DevonHope/FOSS-Health-Alarm/hardware/strap/wakeband-strap-pattern-rev-a.pdf

### WakeBand strap pattern, rev A (print at 100% / Actual size, no scaling)

Check: this box is 50 x 20 mm

2 inches

A BACKING (soft fabric) cut 1 grain along length

fold lines: wrap 4 mm over tape edges turn under 10 mm (anchor end)

FOLD around loop bar A here; box-X stitch below

cut S

S: hook tab C top

cut M

M: hook tab C top

cut L

L: hook tab C top

TIP END: cut at your size, turn under 10 mm (dashed line). Dotted box = hook tab C, sewn on this backing side, 3 mm from tip.

B LOOP TAPE 16 mm (5/8 in), soft side out cut 1

cut S

cut M

cut L

C HOOK TAPE 16 x 35 mm

cut 1, round all corners (r 4 mm)

D TIP TEMPLATE (r 8 mm)

optional: round the tip of A and B together

Sizes (finished strap length):

S: 180 mm wrist 135-160 mm

M: 195 mm wrist 150-175 mm

L: 210 mm wrist 165-190 mm

Measure your wrist snugly where you'll wear it. Between sizes: pick the larger one.

## WakeBand strap: materials and steps

Materials

- 16 mm (5/8 in) sew-on hook-and-loop tape: loop (soft) side about 25 cm, hook side 4 cm. Pick the thin, soft 'sew-on' kind, not adhesive.
- Soft, thin, breathable fabric for the backing (cotton or bamboo jersey, or thin brushed nylon), about 26 x 4 cm.
- Polyester thread, a fabric marker, sharp scissors, a lighter for synthetic edges.

Why this shape

- The strap attaches only at the case's two end loops and never runs under the case, so the charging contacts stay

clear and the motor sits directly on your skin. The finished strap must stay 16 mm wide and under 2 mm thick to

fit the 16.6 x 2.2 mm slots. Aim for 1 mm or less: two layers pass a slot at the bar folds. Test a scrap

through a printed loop before you sew the whole strap.

Steps

1. Print page 1 at 100% (Actual size). Check the 50 x 20 mm box with a ruler.
2. Cut piece A from fabric, piece B from loop tape, piece C from hook tape, at your size's cut lines.
3. Seal cut ends of the synthetic tapes with a quick pass of a lighter flame (don't melt the soft face).
4. Lay B on A, soft side up, centred between A's fold lines, its anchor end on A's 'turn under' line.
5. Fold A's 4 mm edges over B's edges, pin or clip, and topstitch each side about 1.5 mm from the edge.

Use a long stitch (3 mm) and a walking foot or tissue paper if the tape drags.

6. Turn both ends of A under 10 mm (over B's ends) and stitch across.
7. Sew C (hook) onto the BACKING side at the tip, 3 mm from the end, inside the dotted box. Stitch all the way round.
8. Anchor end: thread it through case loop A (either end of the case), fold it back onto the soft side at the 'fold' line,

and sew a box with an X through both layers (about 14 x 14 mm). Do this before you seal the case if the

bar is hard to reach, or sew it with the case already assembled; the slot is open.

9. To wear: wrap around your wrist, pass the tip through the other loop, fold it back and press the hook onto the soft side.

Fit

- Snug, so the case back touches your wrist, but loose enough to slide one finger under the strap.
- The hook tab only touches the soft side when folded back, so it never scratches you.
- Hand wash the strap; remove it from the band first.

Variations

- Stretchier: use 16 mm soft elastic for B and a short sewn-on loop patch where the hook lands.
- Quick, no-sew: 5/8 in VELCRO ONE-WRAP strap cut to length, ends sealed, looped the same way.
