DevonHope/FOSS-Health-Alarm/hardware/strap/wakeband-strap-pattern-rev-b-elastic-buckle.pdf

### WakeBand strap pattern, rev B: elastic edges + buckle (print at 100% / Actual size)

Check: this box is 50 x 20 mm

2 inches

A SHORT STRAP cut 1 (knit)

cut S

S: elastic zone ends

cut M

M: elastic zone ends

cut L

L: elastic zone ends

fold round case bar;
elastic zone starts

turn under 8 mm

B LONG STRAP cut 1 (knit)

cut S

S: elastic zone ends

cut M

M: elastic zone ends

cut L

L: elastic zone ends

fold round case bar;
elastic zone starts

turn under 8 mm

A: male buckle end at top. B: buckle slider end at top. Long dash-dot = fold line (fold lengthwise, right sides in). Short dashes 4 mm in = seam line.

Cut lengths (mm)

size A B elastic A elastic B

S | 66 121 2 x 16 2 x 24
M | 72 129 2 x 21 2 x 30
L | 77 138 2 x 25 2 x 38

Elastic: 1/8 in (3 mm) flat elastic,
two pieces per strap, one per edge.

Keeper: 1/4 in elastic, 45 mm, 1 piece.

## WakeBand strap rev B: elastic edges and a buckle

Materials

- Soft, thin knit (cotton or bamboo jersey, or nylon-spandex), about 30 x 5 cm.
- 1/8 in (3 mm) flat braided elastic, about 30 cm. 1/4 in elastic, 5 cm, for the keeper.
- One 5/8 in (16 mm) plastic side-release buckle with an adjuster bar (the low-profile 'contoured' kind is kinder at night).

Alternative: a 16 mm magnetic snap clasp; then make B the same length as A plus 10 mm and skip the tail and keeper.

- Polyester thread, a bodkin or small safety pin for threading elastic.

How it goes together

- A runs from one case loop to the buckle's male half. B runs from the other case loop, through the buckle's

female half and its adjuster, and ends in a tail held by the keeper. The buckle sits under your wrist.

- Each strap is a 16 mm tube with a 3 mm elastic channel along both edges, so the edges gather and stretch

slightly. The ends that wrap the case bars and buckle bars have no elastic, so they stay thin enough for the

16.6 x 2.2 mm slots.

Steps (same for A and B)

1. Print page 1 at 100%, check the 50 x 20 mm box, cut A and B at your size. Cut elastic from the table.
2. Fold lengthwise right sides together and sew the long edge 4 mm in (stretch or narrow zigzag stitch). Trim to 2 mm.
3. Turn right side out with a bodkin and press so the seam sits on one edge; the tube is now 16 mm wide.
4. Mark the elastic zone from page 1 (from the fold line by the case end to your size's 'elastic zone ends' mark).
5. Sew a line along the full length 3.5 mm in from each edge. This makes two 3 mm channels.
6. Thread one elastic piece into each channel. Pin its ends at the start and end of the elastic zone, so the fabric

gathers evenly. Bar-tack across the channel at both ends of the zone (several back-and-forth stitches).

7. Turn both raw ends in 8 mm and stitch across.
8. A: wrap one end round a case loop bar at the fold mark and box-X stitch. Wrap the other end round the

buckle's male bar the same way.

9. B: wrap one end round the other case loop bar and box-X stitch. Thread the other end up through the

female half's adjuster, back down, and through the keeper.

10. Keeper: overlap the 1/4 in elastic ends by 5 mm round two layers of strap and stitch; slide it onto B.

Fit and care

- Adjust so the case back sits flat on your wrist and you can slide one finger under the strap; the elastic edges

take up movement during sleep. Unclip the buckle to lay the band on the dock.

- Test a scrap of the finished tube end through a printed loop before sewing the bar folds.
- Hand wash with the strap removed from the band.
