DevonHope/FOSS-Health-Alarm/hardware/flex-rev-a/bom.csv

Comment | Designator | Footprint | LCSC | MPN | Qty | DNP
1uF 50V X5R | C201,C206 | Capacitor_SMD:C_0603_1608Metric | C15849 |  | 2
2.2uF 16V X5R | C202 | Capacitor_SMD:C_0603_1608Metric | C23630 |  | 1
100nF | C203,C401,C402 | Capacitor_SMD:C_0402_1005Metric | C1525 |  | 3
10uF 25V X5R | C204,C205,C207,C403 | Capacitor_SMD:C_0603_1608Metric | C96446 |  | 4
1uF 25V X5R | C501,C502 | Capacitor_SMD:C_0402_1005Metric | C52923 |  | 2
SMF18A (TVS) | D601 | Diode_SMD:D_SOD-123F | C409420 | Littelfuse SMF18A | 1
TPD1E10B06 (check) | D602,D603,D604,D605 | Diode_SMD:D_0402_1005Metric | C48260 | TI TPD1E10B06DPYR | 4
red DNP | D701 | LED_SMD:LED_0402_1005Metric | C25503345 | XINGLIGHT XL-1005SURC | 1 | DNP
2.2uH (check) | L201 | Inductor_SMD:L_Murata_DFE201610P | C337891 | Murata DFE201610E-2R2M | 1
100k DNP | R201 | Resistor_SMD:R_0402_1005Metric | C25741 |  | 1 | DNP
68k 1% | R202 | Resistor_SMD:R_0402_1005Metric | C36871 |  | 1
4.7k | R203,R204 | Resistor_SMD:R_0402_1005Metric | C25900 |  | 2
100 | R601,R602,R603,R604 | Resistor_SMD:R_0402_1005Metric | C25076 |  | 4
100k | R605 | Resistor_SMD:R_0402_1005Metric | C25741 |  | 1
1k DNP | R701 | Resistor_SMD:R_0402_1005Metric | C11702 |  | 1 | DNP
button DNP | SW201 | Button_Switch_SMD:SW_SPST_B3U-1000P | C231329 | Omron B3U-1000P | 1 | DNP
10k B3380 | TH201 | Resistor_SMD:R_0402_1005Metric | C77131 | Murata NCP15XH103F03RC | 1
ISP2454-LX | U1 | wakeband:InsightSiP_ISP2454_LGA-62_8x8mm |  |  | 1
nPM1304-QEAA | U201 | Package_DFN_QFN:QFN-32-1EP_5x5mm_P0.5mm_EP3.45x3.45mm |  |  | 1
LIS2DW12TR | U401 | Package_LGA:LGA-12_2x2mm_P0.5mm | C189624 |  | 1
DRV2605LDGSR | U501 | Package_SO:TSSOP-10_3x3mm_P0.5mm | C527464 |  | 1
