DevonHope/FOSS-Health-Alarm/hardware/dock/rev-c/pcb/fab/bom_jlcpcb.csv

Comment | Designator | Footprint | LCSC | MPN | Qty
RP2040 | U1 | QFN-56-1EP_7x7mm_P0.4mm_EP3.2x3.2mm | C2040 | Raspberry Pi RP2040 | 1
W25Q16JVSNIQ | U2 | SOIC-8_3.9x4.9mm_P1.27mm | C2456211 | Winbond W25Q16JVSNIQ | 1
12MHz 12pF | Y1 | Crystal_SMD_3225-4Pin_3.2x2.5mm | C2981639 | 3225-12-12-10-10/A | 1
15pF | C1,C2 | C_0402_1005Metric | C1548 |  | 2
1k | R1,R9,R13,R14 | R_0402_1005Metric | C11702 |  | 4
USB-C | J1 | USB_C_Receptacle_HRO_TYPE-C-31-M-12 | C165948 | HRO TYPE-C-31-M-12 | 1
5.1k | R2,R3 | R_0402_1005Metric | C25905 |  | 2
USBLC6-2SC6 | U3,U9 | SOT-23-6 | C7519 | ST USBLC6-2SC6 | 2
27 | R4,R5 | R_0402_1005Metric | C25100 |  | 2
500mA | F1 | Fuse_0805_2012Metric | C181350 | FSMD050-0805-R | 1
10uF | C3 | C_0603_1608Metric | C19702 |  | 1
XC6206P332MR | U4 | SOT-23-3 | C2897477 | Torex XC6206P332MR | 1
1uF | C4,C5,C6,C7,C14,C15 | C_0402_1005Metric | C52923 |  | 6
XC6206P182MR | U5 | SOT-23-3 | C21659 | Torex XC6206P182MR | 1
SY6280AAC | U6 | SOT-23-5 | C55136 | Silergy SY6280AAC | 1
33k | R6 | R_0402_1005Metric | C25779 |  | 1
100nF | C8,C9,C10,C11,C12,C13,C16,C17,C22,C18,C19,C20,C21 | C_0402_1005Metric | C1525 |  | 13
100nF | C23,C24 | C_0201_0603Metric | C160831 |  | 2
10k | R7,R8 | R_0402_1005Metric | C25744 |  | 2
BOOTSEL | SW1 | SW_SPST_TS-1088-xR020 | C720477 | XKB TS-1088-AR02016 | 1
74LVC1T45 | U7 | SOT-23-6 | C168856 | Diodes 74LVC1T45W6-7 | 1
TXS0101 | U8 | SOT-23-6 | C132604 | TI TXS0101DBVR | 1
22 | R10 | R_0402_1005Metric | C25092 |  | 1
100 | R11,R12 | R_0402_1005Metric | C25076 |  | 2
100k | R15 | R_0201_0603Metric | C106224 | Yageo RC0201FR-07100KL | 1
SMF6.0A | D3 | D_SOD-123F | C123790 | SMF6.0A | 1
red LED | D1,D2 | LED_0603_1608Metric | C2286 | KENTO KT-0603R | 2
