DevonHope/FOSS-Health-Alarm/hardware/band/rev-c/pcb/fab/jlcpcb/bom.csv

Comment | Designator | Footprint | LCSC
2450AT18A0100001E | AE1_0,AE1_1,AE1_2,AE1_3 | Johanson_2450AT18x100 | C17430588
2.2uF | C1_0,C1_1,C1_2,C1_3,C2_0,C2_1,C2_2,C2_3 | Nordic_CAPC0603X03L_C | C335106
10uF | C3_0,C3_1,C3_2,C3_3 | Nordic_CAPC1005X04L | C15525
100nF | C4_0,C4_1,C4_2,C4_3,C7_0,C7_1,C7_2,C7_3,C8_0,C8_1,C8_2,C8_3,C10_0,C10_1,C10_2,C10_3 | Nordic_CAPC0603X03L_C | C307380
2.2nF | C5_0,C5_1,C5_2,C5_3 | Nordic_CAPC0603X03L_C | C161479
1.5pF | C6_0,C6_1,C6_2,C6_3 | Nordic_CAPC0603X03L_C | C435397
2.0pF | C9_0,C9_1,C9_2,C9_3 | Nordic_CAPC0603X03L_C | C668326
0.3pF | C11_0,C11_1,C11_2,C11_3 | Nordic_CAPC0603X03L_C | C76927
10nF | C12_0,C12_1,C12_2,C12_3 | Nordic_CAPC0603X03L_C | C76941
3.9pF | C13_0,C13_1,C13_2,C13_3 | Nordic_CAPC0603X03L_C | C76926
1uF | C201_0,C201_1,C201_2,C201_3,C208_0,C208_1,C208_2,C208_3,C501_0,C501_1,C501_2,C501_3,C502_0,C502_1,C502_2,C502_3 | C_0402_1005Metric | C52923
2.2uF | C202_0,C202_1,C202_2,C202_3 | C_0603_1608Metric | C23630
10uF | C205_0,C205_1,C205_2,C205_3,C206_0,C206_1,C206_2,C206_3 | C_0603_1608Metric | C96446
100nF | C209_0,C209_1,C209_2,C209_3,C401_0,C401_1,C401_2,C401_3,C402_0,C402_1,C402_2,C402_3 | C_0402_1005Metric | C1525
1uF | C210_0,C210_1,C210_2,C210_3,C211_0,C211_1,C211_2,C211_3 | Nordic_CAPC0603X03L_C | C307385
ESD5681N07 | D601_0,D601_1,D601_2,D601_3 | D_SOD-882 | C240204
TPD1E10B06 | D602_0,D602_1,D602_2,D602_3,D603_0,D603_1,D603_2,D603_3 | Texas_DPY0002A_0.6x1mm_P0.65mm | C48260
TJ-S1615SW6TGLCCYRGB-A5 | D702_0,D702_1,D702_2,D702_3 | LED_TOGIALED_1615_RGB_CommonAnode | C273610
120R@100MHz | FB1_0,FB1_1,FB1_2,FB1_3 | Nordic_INDC0603X03L_C | C97850
4.7uH | L1_0,L1_1,L1_2,L1_3 | Nordic_INDC1608X06L | C76799
2.7nH | L2_0,L2_1,L2_2,L2_3 | Nordic_INDC0603X03L_C | C7216765
3.5nH | L3_0,L3_1,L3_2,L3_3,L4_0,L4_1,L4_2,L4_3 | Nordic_INDC0603X03L_C | C3911055
2.2uH | L201_0,L201_1,L201_2,L201_3 | L_Murata_DFE201610P | C337891
1k | R1_0,R1_1,R1_2,R1_3 | Nordic_RESC0603X03L_C | C270365
0R | R2_0,R2_1,R2_2,R2_3 | R_0402_1005Metric | C17168
6.65k | R202_0,R202_1,R202_2,R202_3 | R_0402_1005Metric | C45194
4.7k | R203_0,R203_1,R203_2,R203_3,R204_0,R204_1,R204_2,R204_3 | R_0402_1005Metric | C25900
14k | R207_0,R207_1,R207_2,R207_3 | R_0402_1005Metric | C54831
14.3k | R208_0,R208_1,R208_2,R208_3 | R_0402_1005Metric | C25855
100k | R211_0,R211_1,R211_2,R211_3 | R_0402_1005Metric | C25741
100 | R601_0,R601_1,R601_2,R601_3,R602_0,R602_1,R602_2,R602_3 | R_0402_1005Metric | C25076
10k B3380 | TH201_0,TH201_1,TH201_2,TH201_3 | R_0402_1005Metric | C77131
nRF54L10-QFAA | U1_0,U1_1,U1_2,U1_3 | Nordic_QFN40P600X600X90-48N | C44800139
BQ25125 | U201_0,U201_1,U201_2,U201_3 | TI_DSBGA-25_2.5x2.5mm_Layout5x5_P0.4mm | C2871567
IS31FL3193 | U202_0,U202_1,U202_2,U202_3 | DFN-10-1EP_3x3mm_P0.5mm_EP1.65x2.38mm | C2653363
TPS7A0220 | U203_0,U203_1,U203_2,U203_3 | Texas_X2SON-4_1x1mm_P0.65mm_SilkTrim | C2860934
LIS2DW12TR | U401_0,U401_1,U401_2,U401_3 | LGA-12_2x2mm_P0.5mm | C189624
DRV2605LDGSR | U501_0,U501_1,U501_2,U501_3 | TSSOP-10_3x3mm_P0.5mm | C527464
32.768kHz 9pF | X1_0,X1_1,X1_2,X1_3 | Nordic_XTAL_2012 | C96341
32MHz 8pF | X2_0,X2_1,X2_2,X2_3 | Nordic_BT-XTAL_2016 | C2965582
