DevonHope/FOSS-Health-Alarm/hardware/band/rev-c/case/wakeband-case-rev-c-cover.step

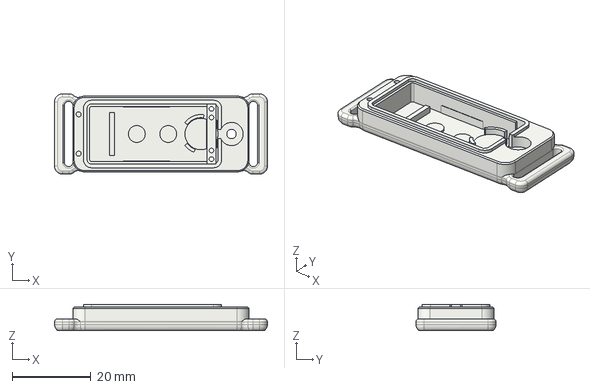
[picture p19: CAD file, 2026-11-10]
hardware/band/rev-c/case/wakeband-case-rev-c-cover.step
54.2 x 20.4 x 6.70 mm
