DevonHope/FOSS-Health-Alarm/hardware/dock/rev-c/case/wakeband-dock-rev-c-tray.step

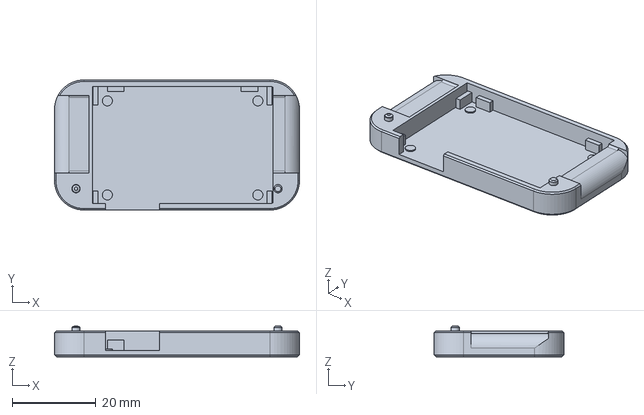
[picture p20: CAD file, 2026-11-10]
hardware/dock/rev-c/case/wakeband-dock-rev-c-tray.step
58.6 x 31.1 x 7.39 mm
