DevonHope/FOSS-Health-Alarm/hardware/band/rev-c/case/wakeband-case-rev-c-shell.step

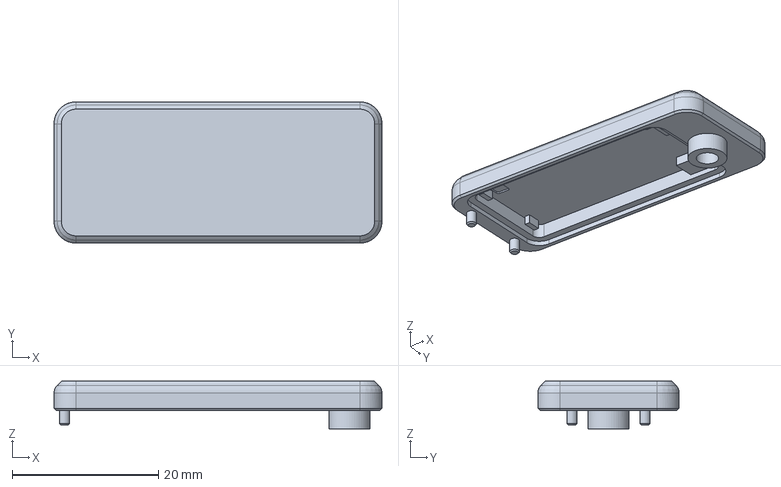
[picture p21: CAD file, 2026-11-10]
hardware/band/rev-c/case/wakeband-case-rev-c-shell.step
44.8 x 19.3 x 6.50 mm
