DevonHope/FOSS-Health-Alarm/hardware/dock/rev-c/case/wakeband-dock-rev-c-spring-pins.step

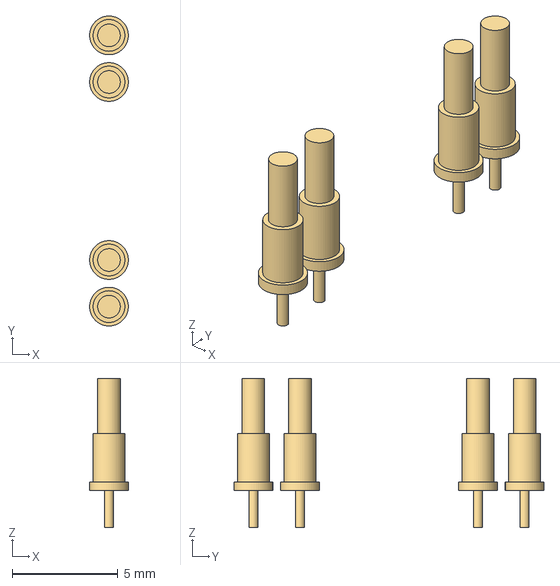
[picture p22: CAD file, 2026-11-10]
hardware/dock/rev-c/case/wakeband-dock-rev-c-spring-pins.step
1.83 x 14.6 x 7.04 mm
