DevonHope/FOSS-Health-Alarm/hardware/dock/rev-c/case/wakeband-dock-rev-c-strap-standin.step

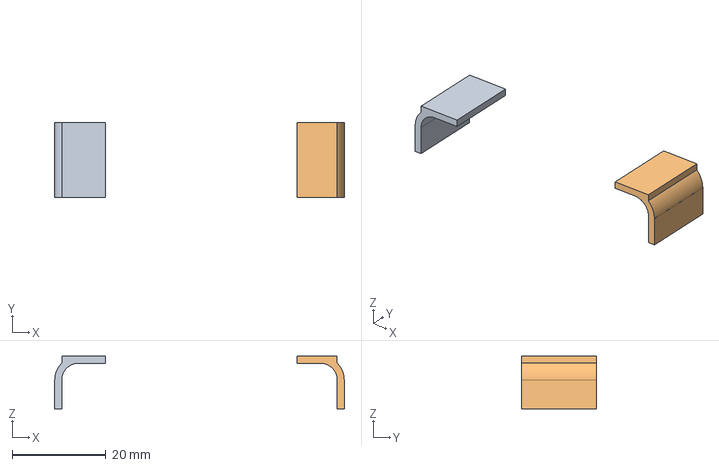
[picture p23: CAD file, 2026-11-10]
hardware/dock/rev-c/case/wakeband-dock-rev-c-strap-standin.step
61.8 x 16.0 x 11.2 mm
