DevonHope/FOSS-Health-Alarm/hardware/dock/rev-c/case/wakeband-dock-rev-c-magnets.step

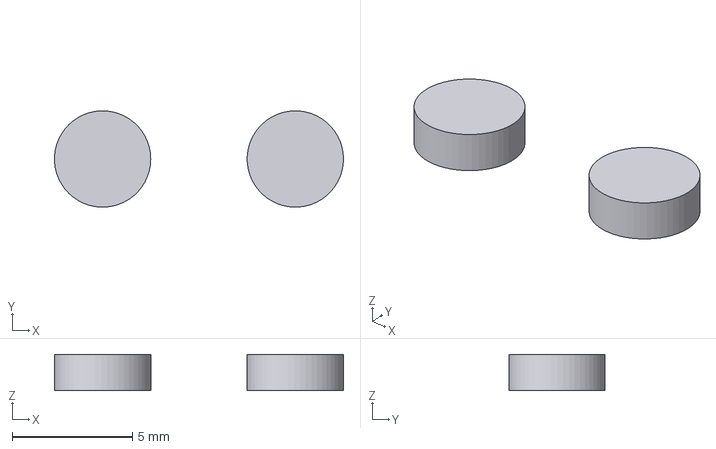
[picture p24: CAD file, 2026-11-10]
hardware/dock/rev-c/case/wakeband-dock-rev-c-magnets.step
12.0 x 4.00 x 1.50 mm
