DevonHope/FOSS-Health-Alarm/hardware/dock/rev-c/case/wakeband-dock-rev-c-top.step

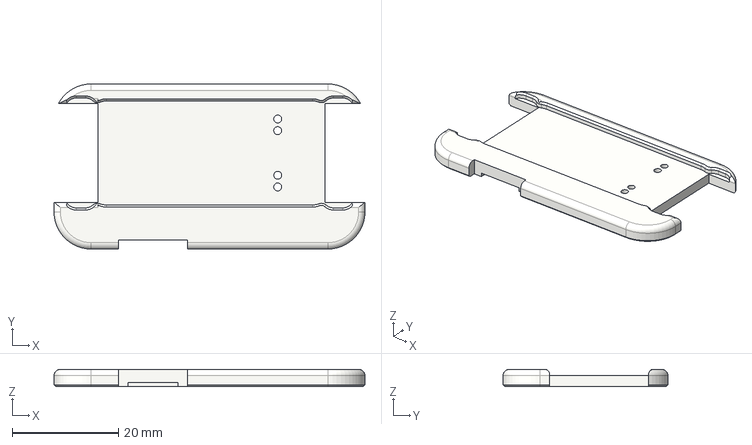
[picture p25: CAD file, 2026-11-10]
hardware/dock/rev-c/case/wakeband-dock-rev-c-top.step
58.6 x 31.1 x 3.25 mm
