DevonHope/FOSS-Health-Alarm/hardware/band/rev-a/case/wakeband-case-rev-a-spring-pins.step

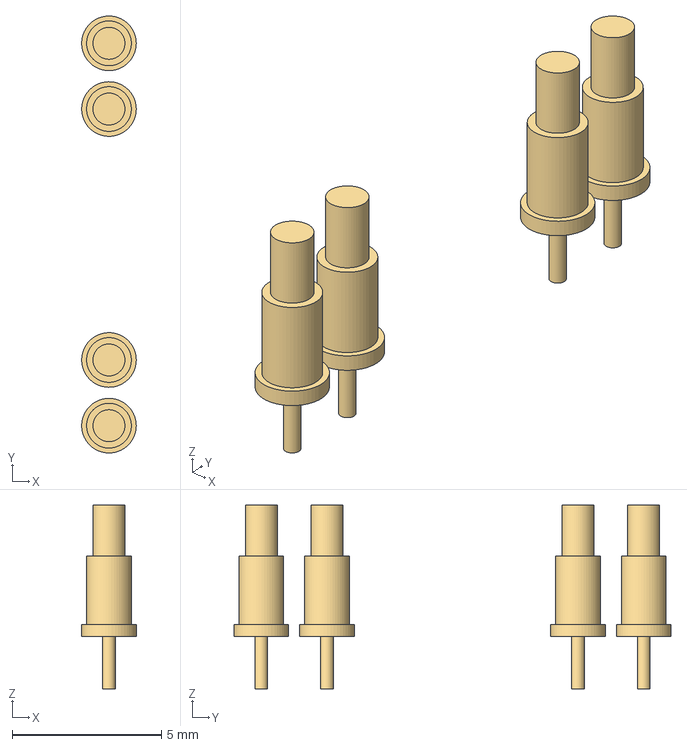
[picture p26: CAD file, 2026-11-10, an earlier design]
hardware/band/rev-a/case/wakeband-case-rev-a-spring-pins.step
1.83 x 14.6 x 6.15 mm
