DevonHope/FOSS-Health-Alarm/hardware/dock/rev-a/case/wakeband-dock-rev-a-pcb-envelope.step

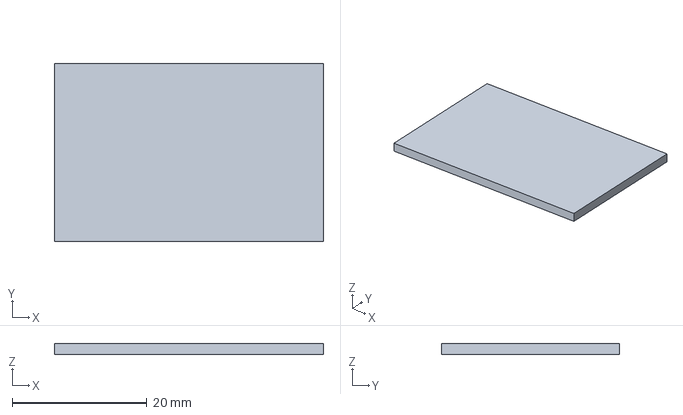
[picture p27: CAD file, 2026-11-10, an earlier design]
hardware/dock/rev-a/case/wakeband-dock-rev-a-pcb-envelope.step
40.0 x 26.5 x 1.60 mm
