DevonHope/FOSS-Health-Alarm/hardware/dock/rev-a/case/wakeband-dock-rev-a-magnets.step

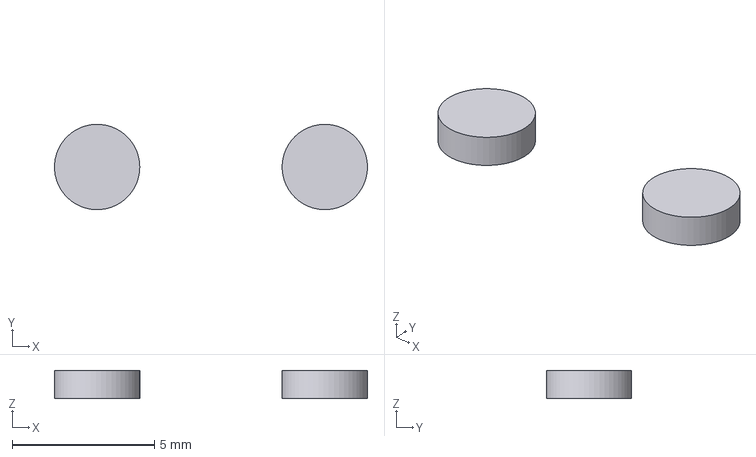
[picture p28: CAD file, 2026-11-10, an earlier design]
hardware/dock/rev-a/case/wakeband-dock-rev-a-magnets.step
11.0 x 3.00 x 1.00 mm
