DevonHope/FOSS-Health-Alarm/(list of files, cad)

Other CAD files:
hardware/dock/rev-a/case/wakeband-dock-rev-a-spring-pins.step
hardware/dock/rev-b/case/wakeband-dock-rev-b-tray.step
hardware/band/rev-a/case/wakeband-case-rev-a-shell.step
hardware/dock/rev-b/case/wakeband-dock-rev-b-strap-standin.step
hardware/band/rev-a/case/wakeband-case-rev-a-cover.step
hardware/dock/rev-b/case/wakeband-dock-rev-b-top.step
hardware/band/rev-a/case/wakeband-case-rev-a-contact-carrier.step
hardware/band/rev-a/case/wakeband-case-rev-a-cover.stl
hardware/band/rev-a/case/wakeband-case-rev-a-magnets.step
hardware/band/rev-a/case/wakeband-case-rev-a-shell.stl
hardware/band/rev-b/case/wakeband-case-rev-b-cover.stl
hardware/band/rev-b/case/wakeband-case-rev-b-shell.stl
hardware/band/rev-c/case/wakeband-case-rev-c-cover.stl
hardware/band/rev-c/case/wakeband-case-rev-c-shell.stl
hardware/dock/rev-a/case/wakeband-dock-rev-a-top.step
hardware/dock/rev-a/case/wakeband-dock-rev-a-top.stl
hardware/dock/rev-a/case/wakeband-dock-rev-a-tray.step
hardware/dock/rev-a/case/wakeband-dock-rev-a-tray.stl
hardware/dock/rev-b/case/wakeband-dock-rev-b-magnets.step
hardware/dock/rev-b/case/wakeband-dock-rev-b-spring-pins.step
hardware/dock/rev-b/case/wakeband-dock-rev-b-top.stl
hardware/dock/rev-b/case/wakeband-dock-rev-b-tray.stl
hardware/dock/rev-c/case/wakeband-dock-rev-c-top.stl
hardware/dock/rev-c/case/wakeband-dock-rev-c-tray.stl
