DevonHope/FOSS-Health-Alarm/hardware/dock/rev-c/pcb/dock-pcb-rev-c-schematic.pdf

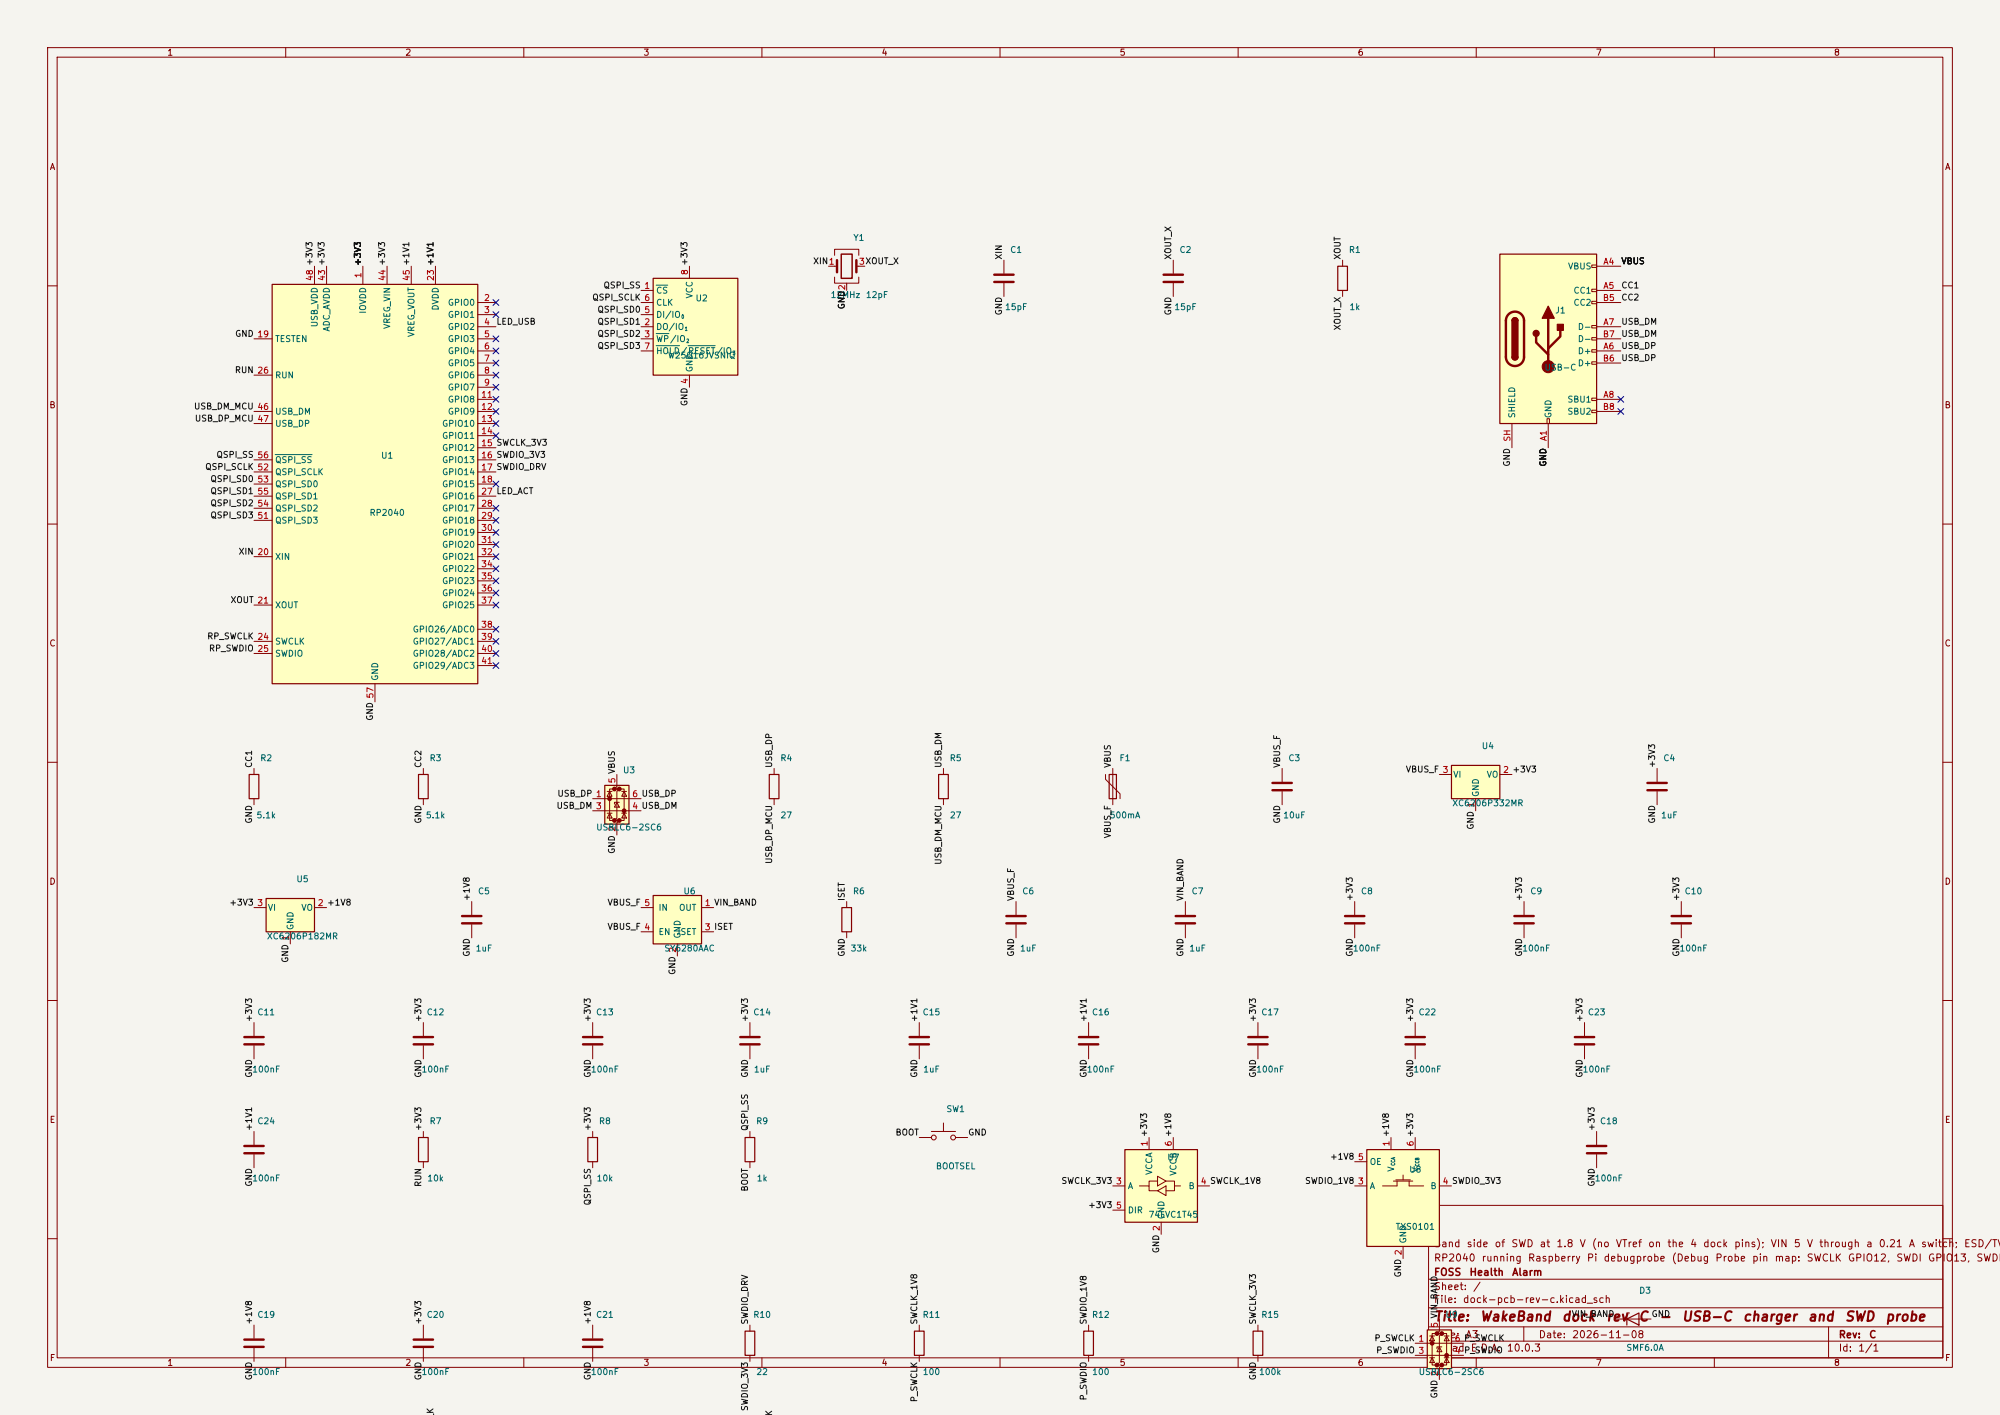
[picture p29: page 1]

4 DI/IO0 5 CLK 6 HOLD/RESET/IO3 7 VCC

Band side of SWD at 1.8 V (no VTref on the 4 dock pins); VIN 5 V through a 0.21 A switch; ESD/TVS on the 4 pins
RP2040 running Raspberry Pi debugprobe (Debug Probe pin map: SWCLK GPIO12, SWDI GPIO13, SWDIO GPIO14, LEDs GPIO2/16)
FOSS Health Alarm
P_SWDIO VIN_BAND
Sheet: /
File: dock-pcb-rev-c.kicad_sch
KiCad E.D.A. 10.0.3
