DevonHope/FOSS-Health-Alarm/hardware/flex-rev-a/flex-rev-a-layout.pdf

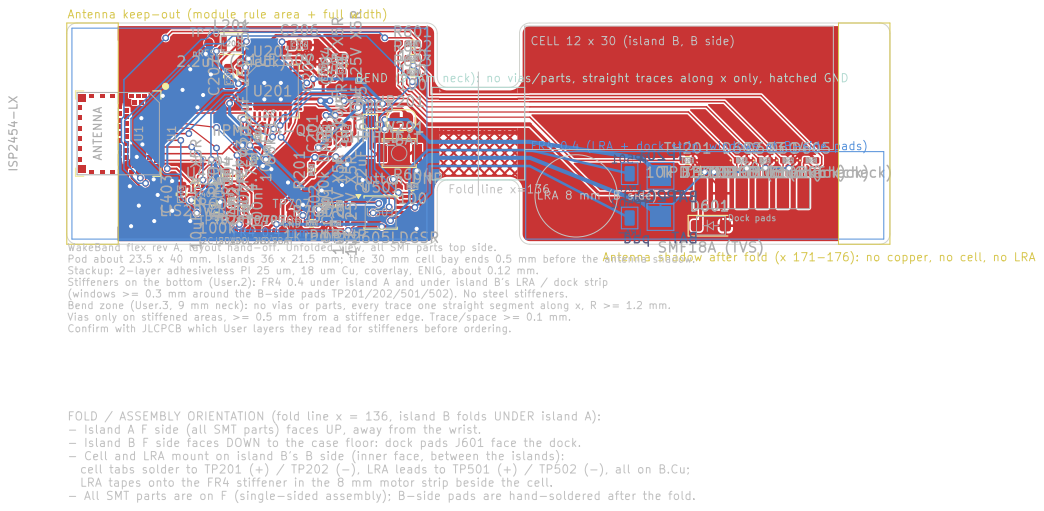
[picture p30: page 1]
