DevonHope/FOSS-Health-Alarm/hardware/dock/rev-c/pcb/dock-pcb-rev-c-layout.pdf

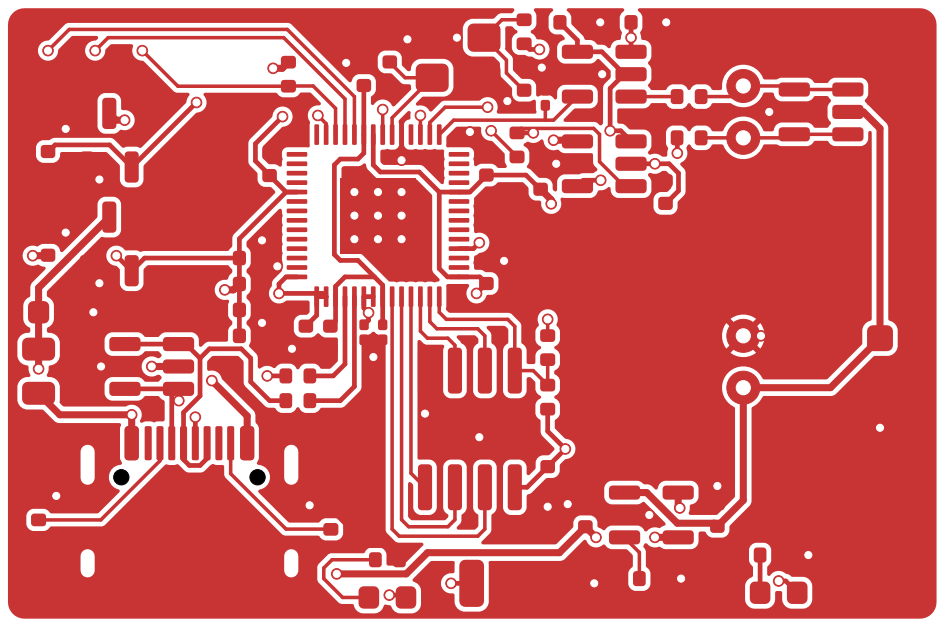
[picture p31: page 1]

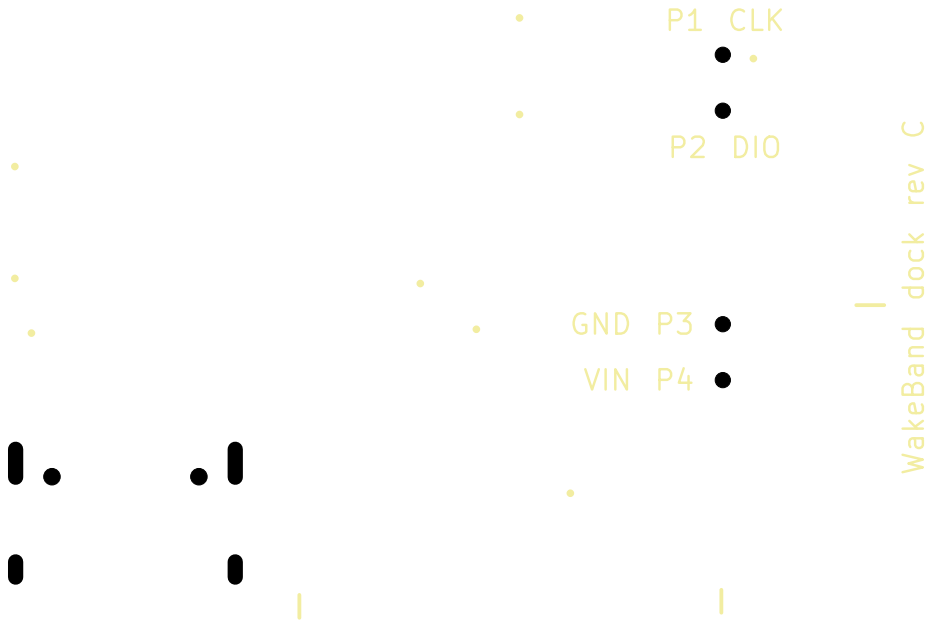
[picture p32: page 2]

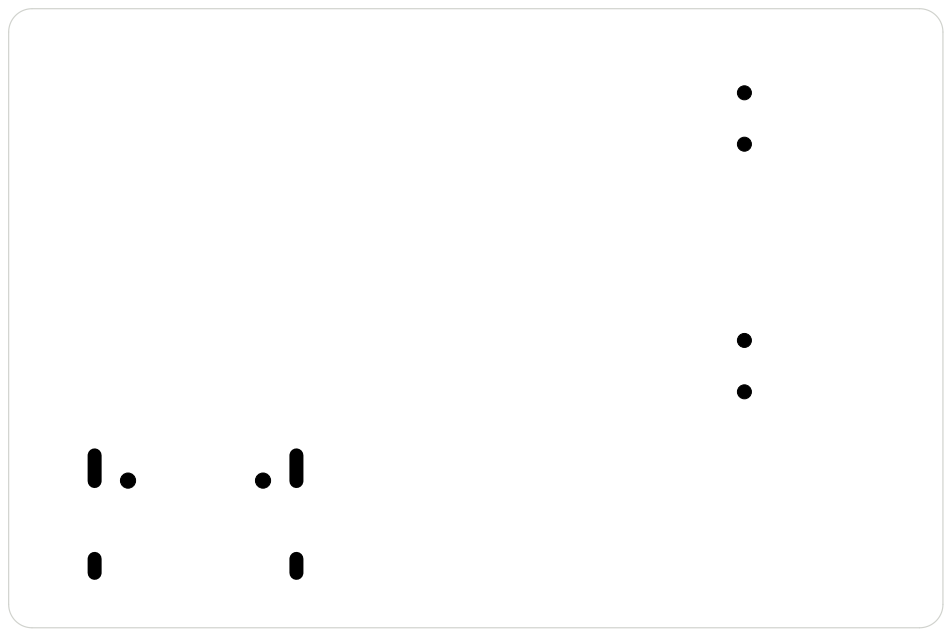
[picture p33: page 3]

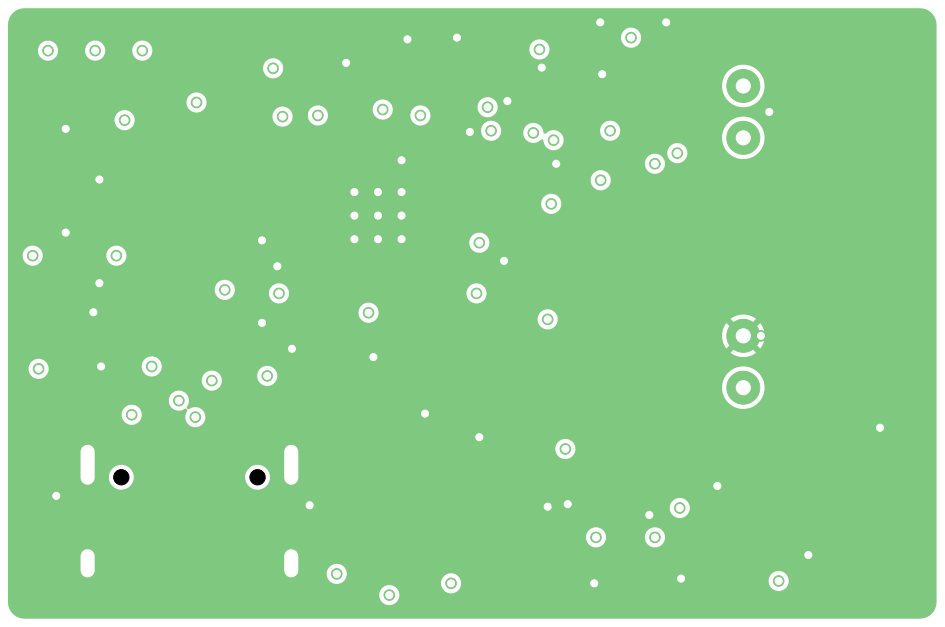
[picture p34: page 4]

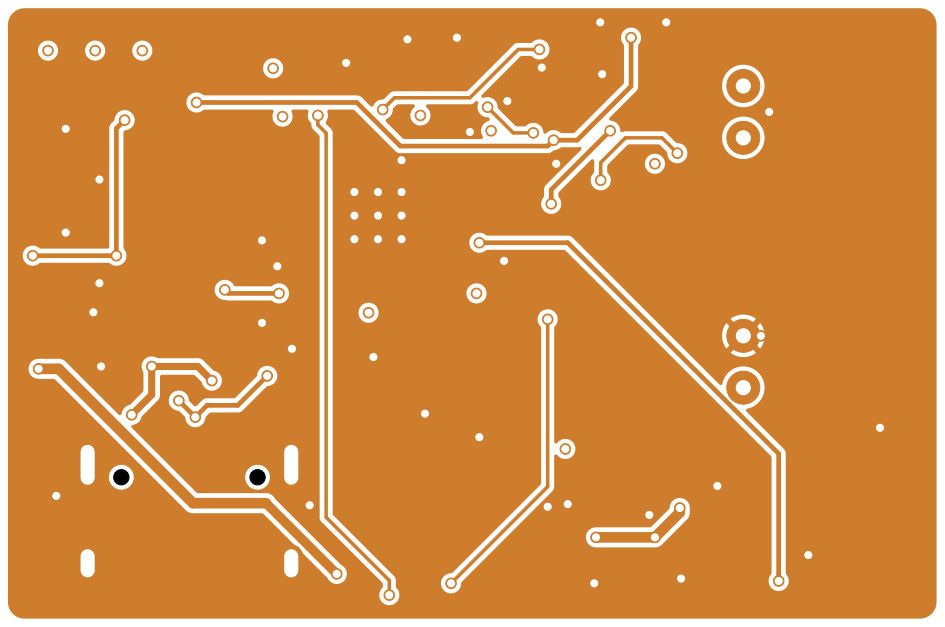
[picture p35: page 5]

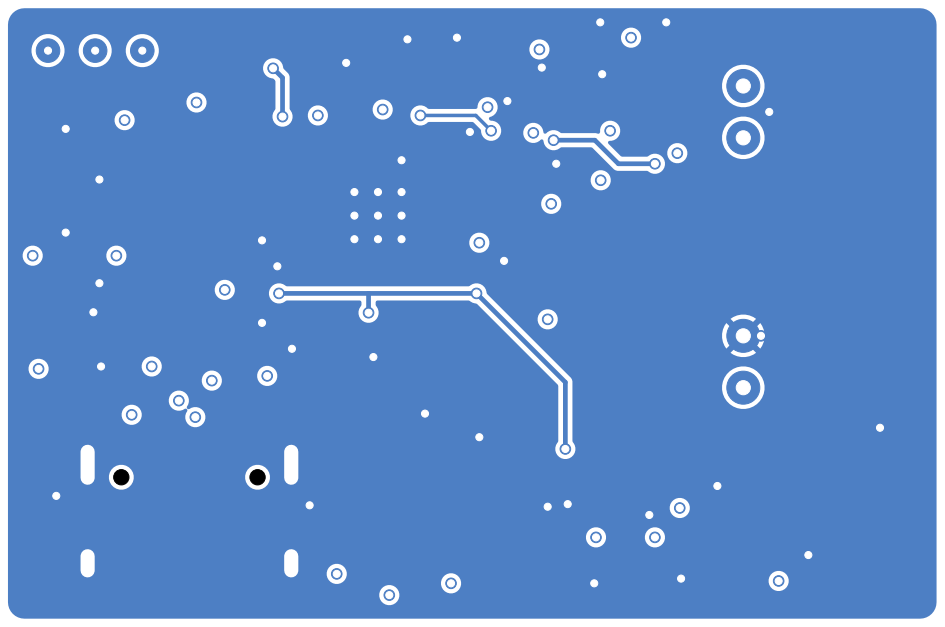
[picture p36: page 6]

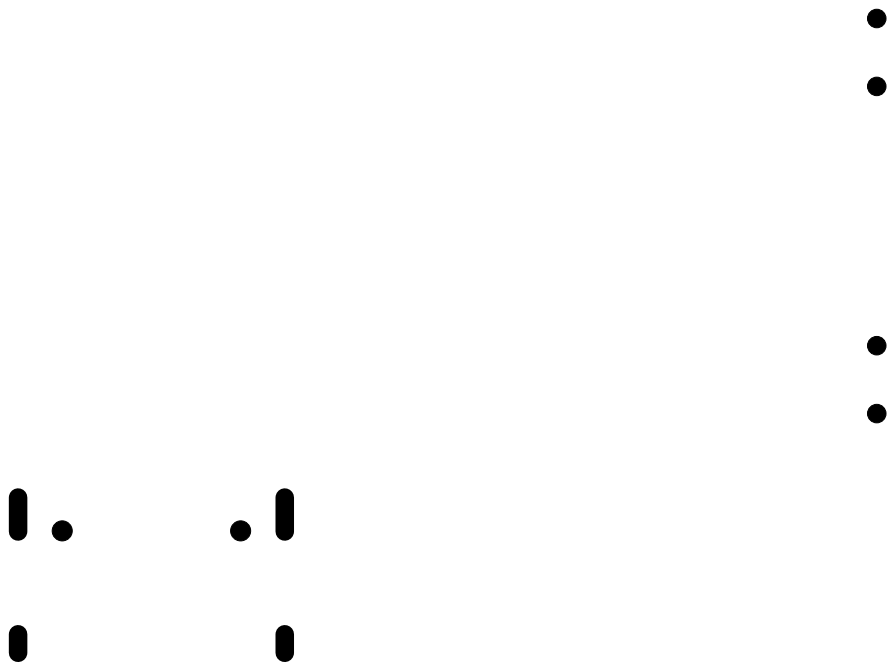
[picture p37: page 7]
