DevonHope/FOSS-Health-Alarm/hardware/dock/rev-a/pcb/dock-pcb-rev-a-layout.pdf

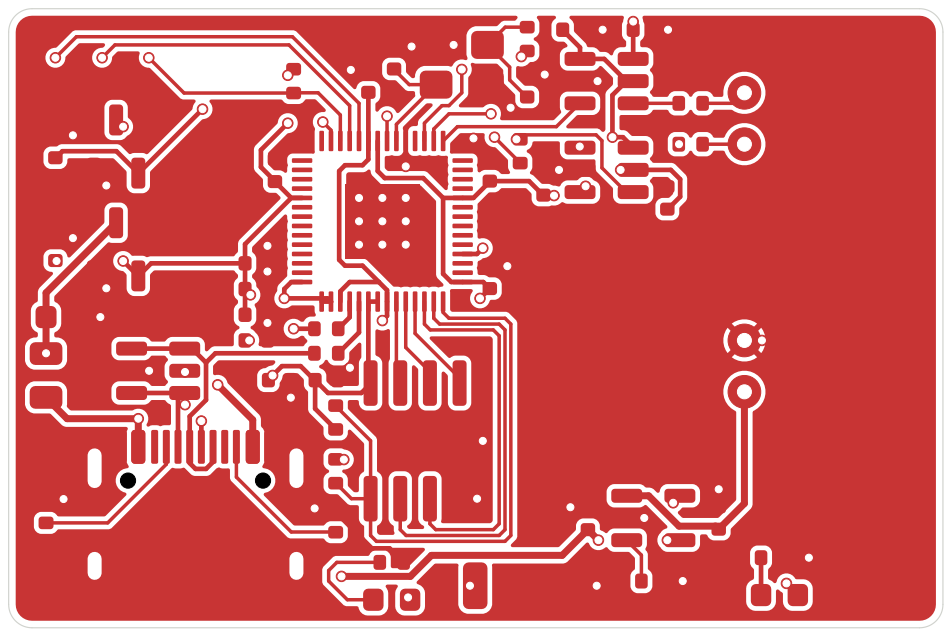
[picture p46: page 1]

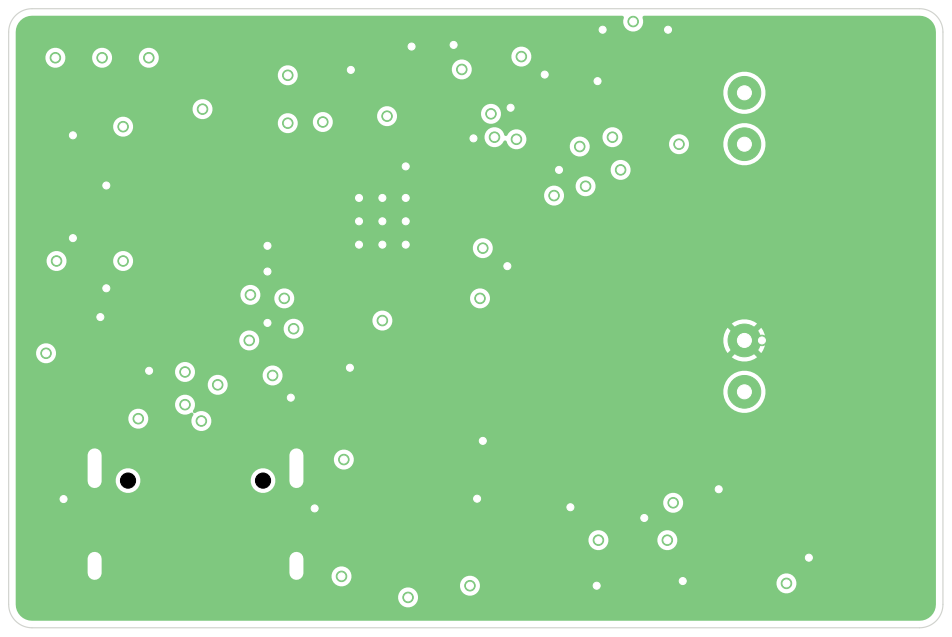
[picture p47: page 2]

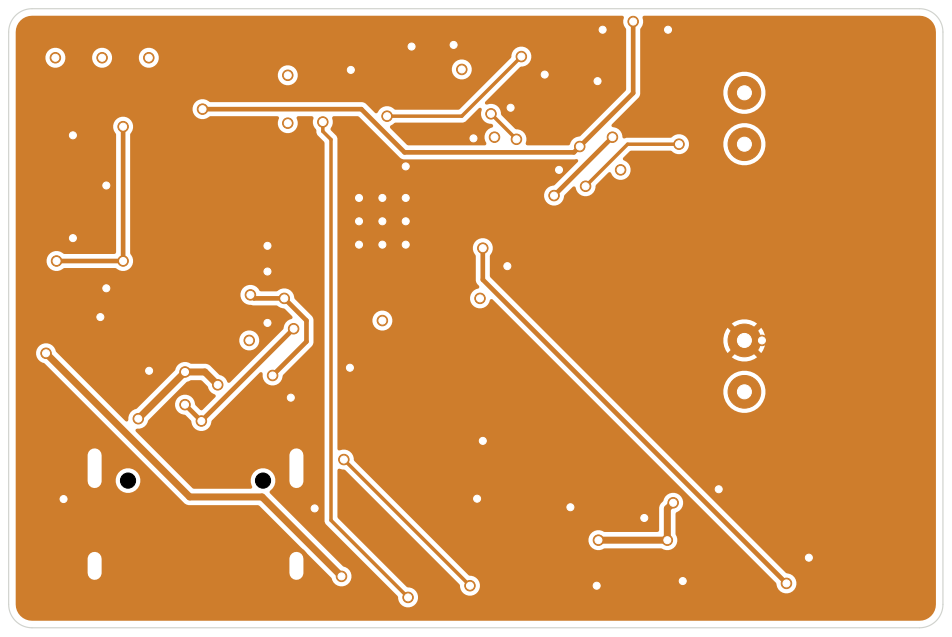
[picture p48: page 3]

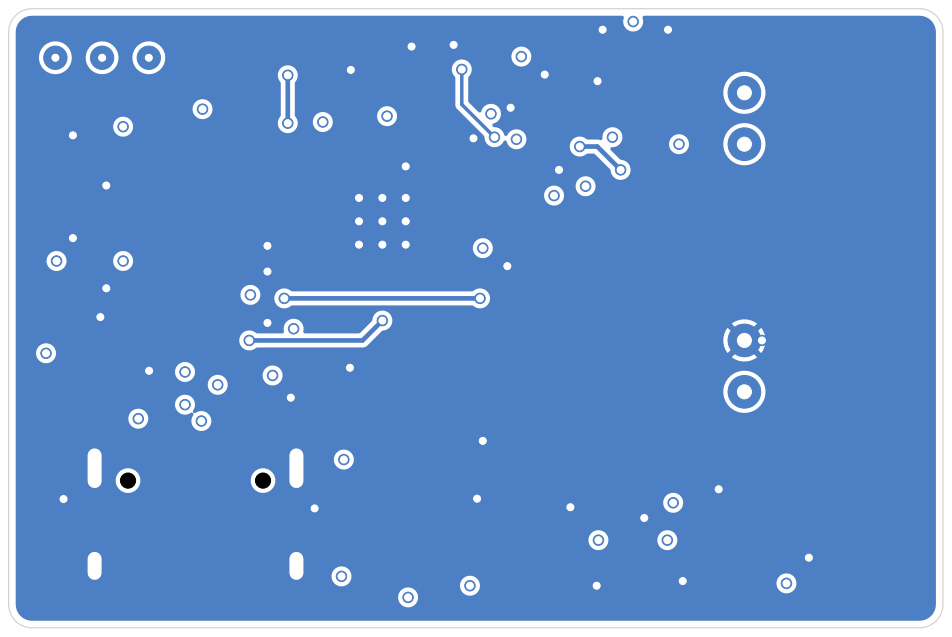
[picture p49: page 4]

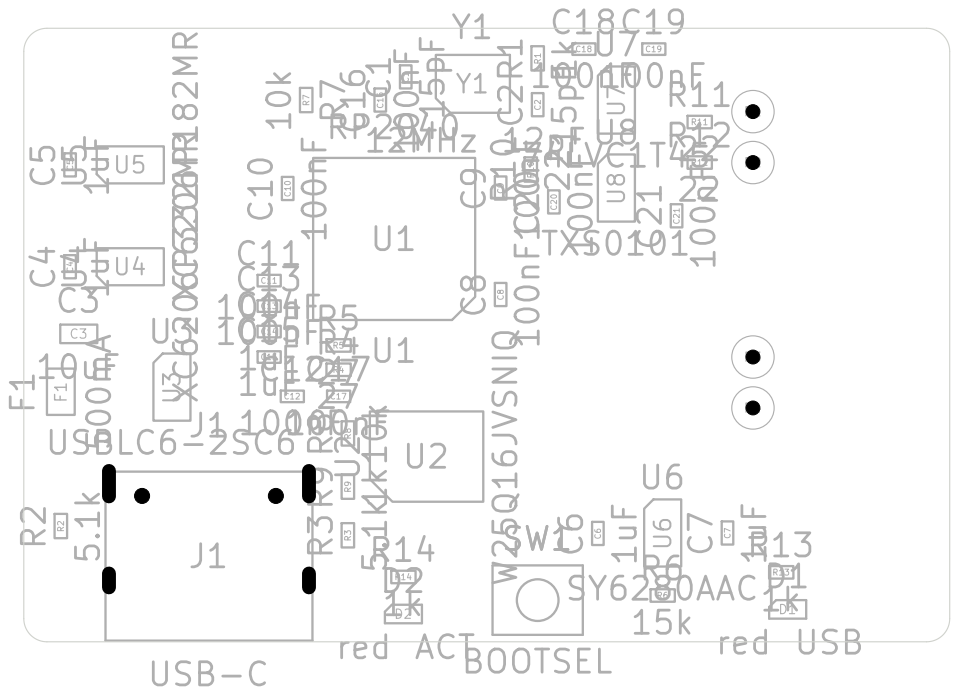
[picture p50: page 5]

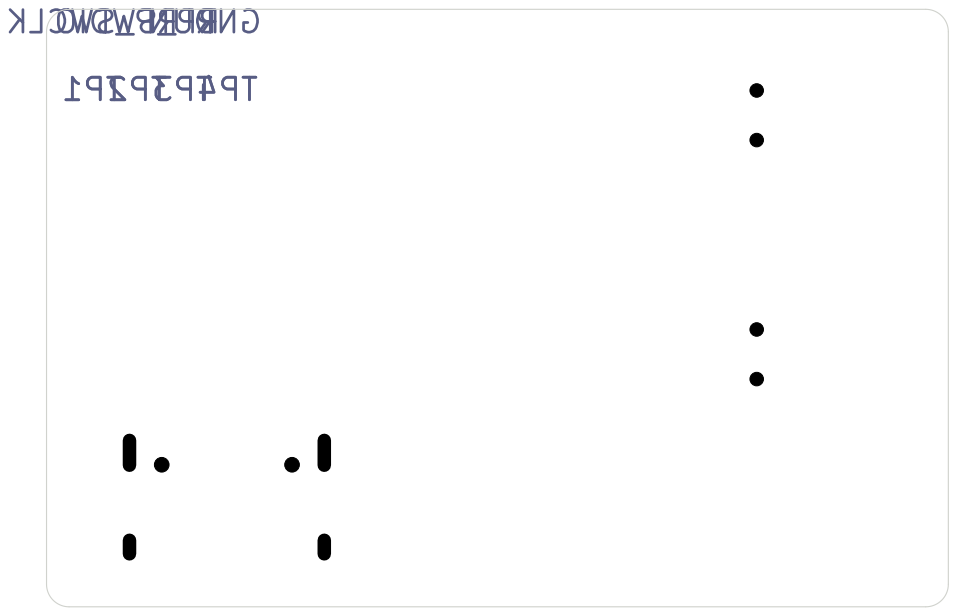
[picture p51: page 6]
