DevonHope/FOSS-Health-Alarm/hardware/dock/rev-b/pcb/dock-pcb-rev-b-layout.pdf

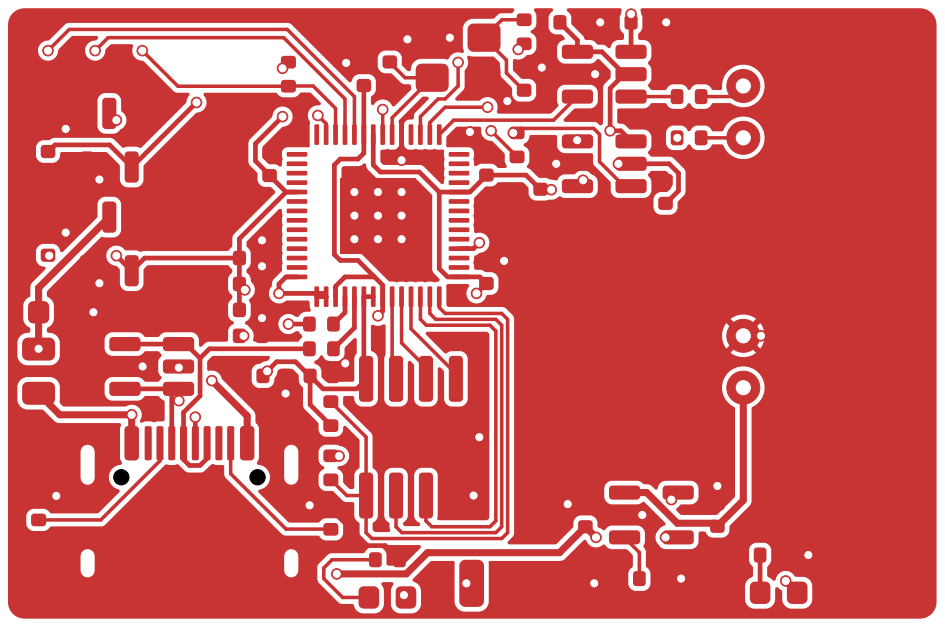
[picture p52: page 1]



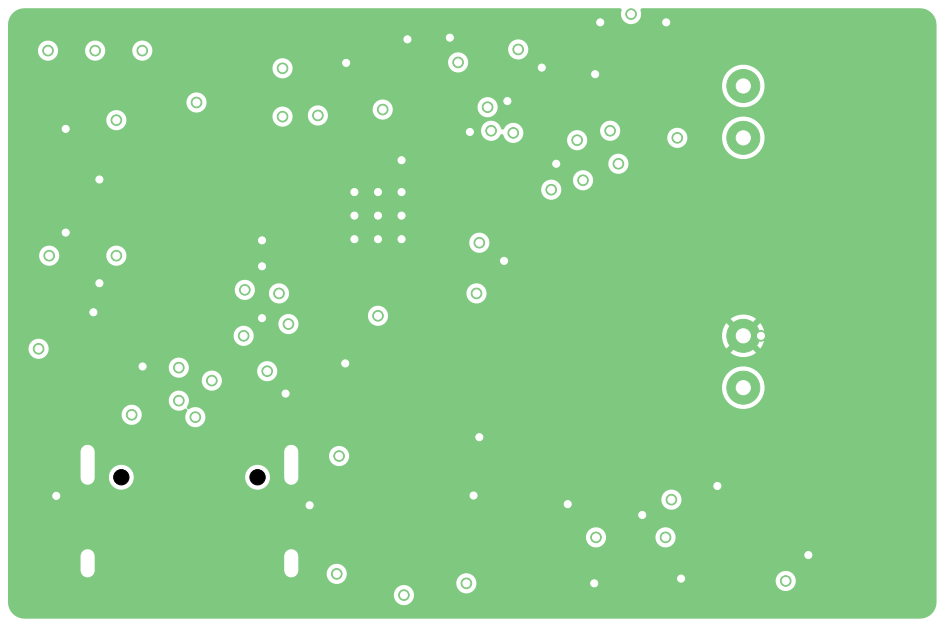
[picture p53: page 4]

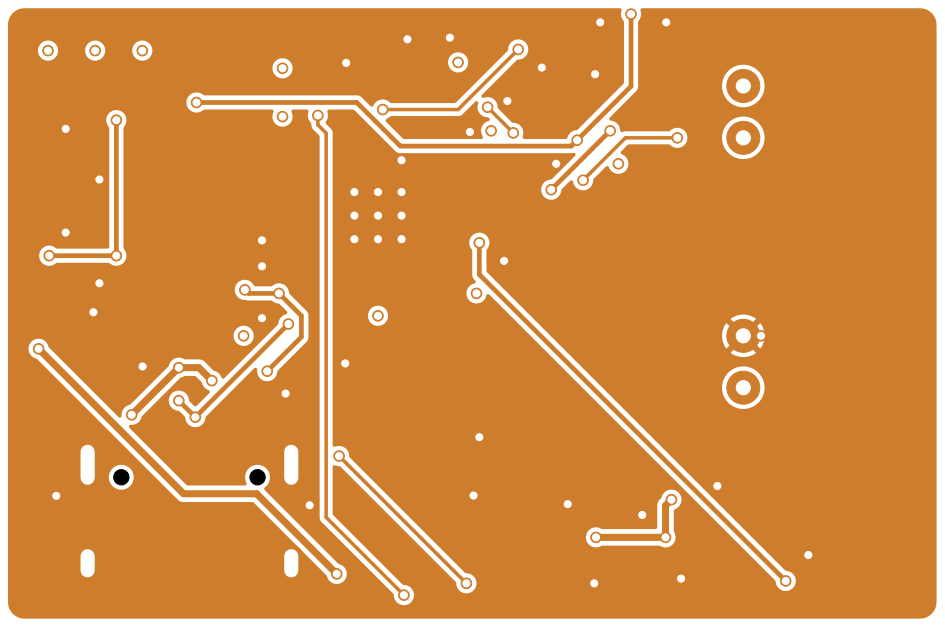
[picture p54: page 5]

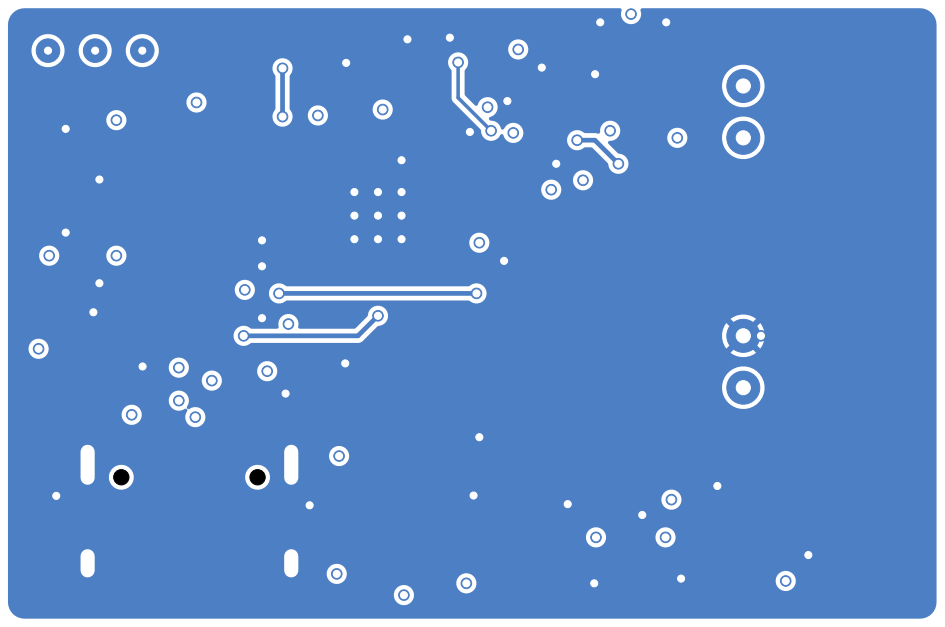
[picture p55: page 6]
