DevonHope/FOSS-Health-Alarm/hardware/band/rev-a/pcb/fab/u1-pin1-drawing.pdf

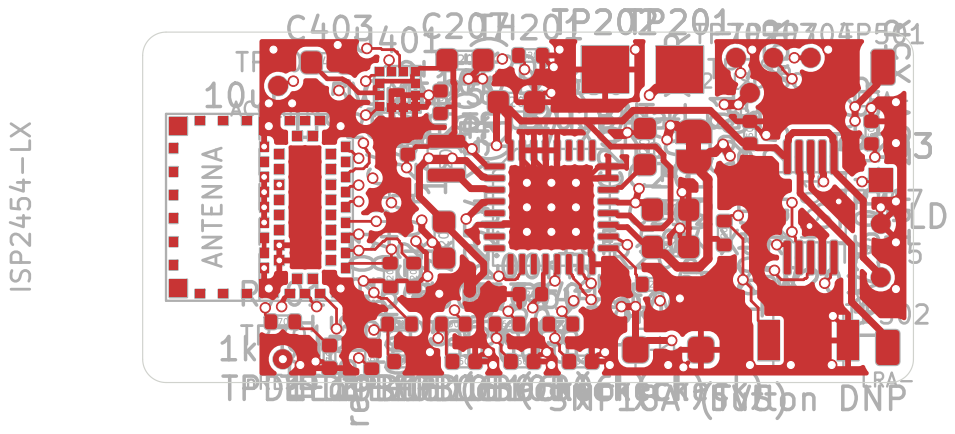
[picture p56: page 1]
