DevonHope/FOSS-Health-Alarm/hardware/dock/rev-b/pcb/dock-pcb-rev-b.kicad_pcb

## KiCad design hardware/dock/rev-b/pcb/dock-pcb-rev-b.kicad_pcb (2026-11-10, an earlier design)

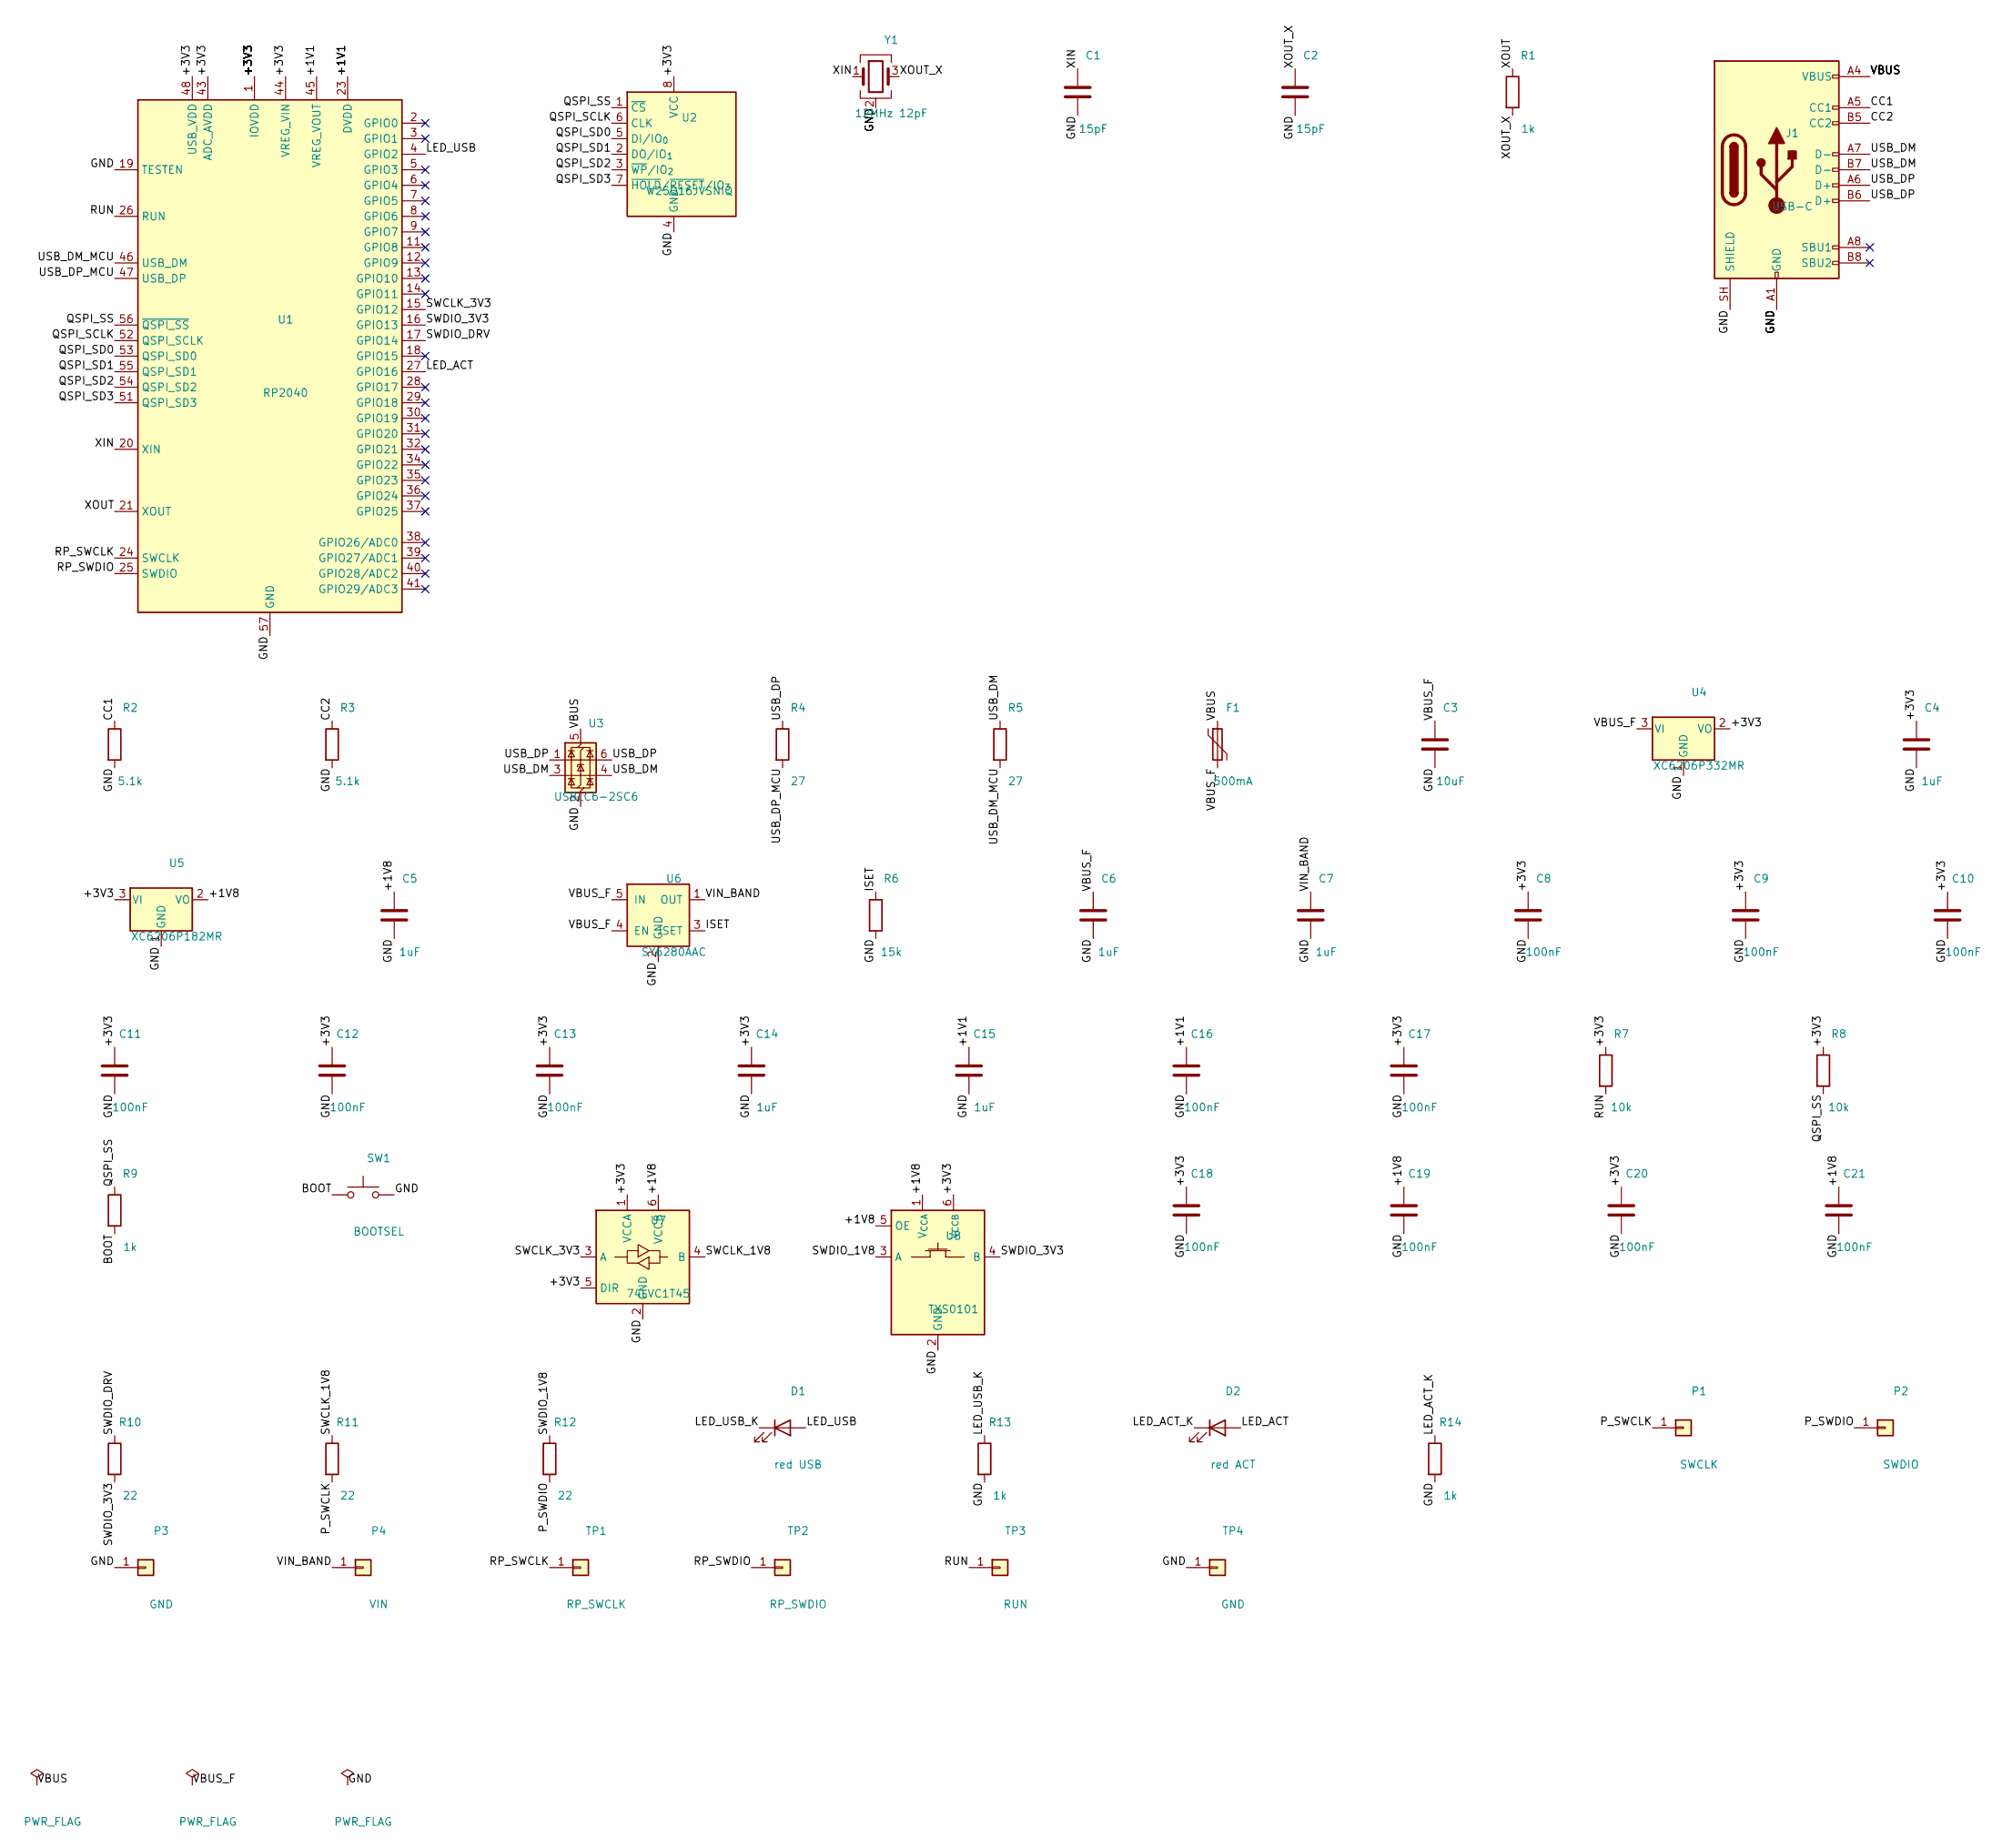
[picture p57: schematic dock-pcb-rev-b.kicad_sch, WakeBand dock rev B - USB-C charger and SWD probe]

Parts:
C1, C2: 15pF; C_0402_1005Metric; LCSC C1548
C3: 10uF; C_0603_1608Metric; LCSC C19702
C4, C5, C6, C7, C14, C15: 1uF; C_0402_1005Metric; LCSC C52923
C8, C9, C10, C11, C12, C13, C16, C17, C18, C19, C20, C21: 100nF; C_0402_1005Metric; LCSC C1525
D1: red USB; LED_0603_1608Metric; MPN KENTO KT-0603R; LCSC C2286
D2: red ACT; LED_0603_1608Metric; MPN KENTO KT-0603R; LCSC C2286
F1: 500mA; Fuse_0805_2012Metric; MPN FSMD050-0805-R; LCSC C181350
J1: USB-C; USB_C_Receptacle_HRO_TYPE-C-31-M-12; MPN HRO TYPE-C-31-M-12; LCSC C165948
P1: SWCLK; SpringPin_Mill-Max_0906_PTH_D1.4mm_Drill0.6mm; MPN Mill-Max 0906-4-15-20-75-14-11-0
P2: SWDIO; SpringPin_Mill-Max_0906_PTH_D1.4mm_Drill0.6mm; MPN Mill-Max 0906-4-15-20-75-14-11-0
P3: GND; SpringPin_Mill-Max_0906_PTH_D1.4mm_Drill0.6mm; MPN Mill-Max 0906-4-15-20-75-14-11-0
P4: VIN; SpringPin_Mill-Max_0906_PTH_D1.4mm_Drill0.6mm; MPN Mill-Max 0906-4-15-20-75-14-11-0
R1, R9, R13, R14: 1k; R_0402_1005Metric; LCSC C11702
R2, R3: 5.1k; R_0402_1005Metric; LCSC C25905
R4, R5: 27; R_0402_1005Metric; LCSC C25100
R6: 15k; R_0402_1005Metric; LCSC C25756
R7, R8: 10k; R_0402_1005Metric; LCSC C25744
R10, R11, R12: 22; R_0402_1005Metric; LCSC C25092
SW1: BOOTSEL; SW_SPST_TS-1088-xR020; MPN XKB TS-1088-AR02016; LCSC C720477
TP1: RP_SWCLK; TestPoint_Pad_D1.0mm
TP2: RP_SWDIO; TestPoint_Pad_D1.0mm
TP3: RUN; TestPoint_Pad_D1.0mm
TP4: GND; TestPoint_Pad_D1.0mm
U1: RP2040; QFN-56-1EP_7x7mm_P0.4mm_EP3.2x3.2mm; MPN Raspberry Pi RP2040; LCSC C2040
U2: W25Q16JVSNIQ; SOIC-8_3.9x4.9mm_P1.27mm; MPN Winbond W25Q16JVSNIQ; LCSC C2456211
U3: USBLC6-2SC6; SOT-23-6; MPN ST USBLC6-2SC6; LCSC C7519
U4: XC6206P332MR; SOT-23-3; MPN Torex XC6206P332MR; LCSC C2897477
U5: XC6206P182MR; SOT-23-3; MPN Torex XC6206P182MR; LCSC C21659
U6: SY6280AAC; SOT-23-5; MPN Silergy SY6280AAC; LCSC C55136
U7: 74LVC1T45; SOT-23-6; MPN Diodes 74LVC1T45W6-7; LCSC C168856
U8: TXS0101; SOT-23-6; MPN TI TXS0101DBVR; LCSC C132604
Y1: 12MHz 12pF; Crystal_SMD_3225-4Pin_3.2x2.5mm; MPN 3225-12-12-10-10/A; LCSC C2981639

Connections:
/+1V1: C15.1, C16.1, U1.23 (DVDD), U1.45 (VREG_VOUT), U1.50 (DVDD)
/+1V8: C5.1, C19.1, C21.1, U5.2 (VO), U7.6 (VCCB), U8.1 (V_{CCA}), U8.5 (OE)
/+3V3: C4.1, C8.1, C9.1, C10.1, C11.1, C12.1, C13.1, C14.1, C17.1, C18.1, C20.1, R7.1, R8.1, U1.1 (IOVDD), U1.10 (IOVDD), U1.22 (IOVDD), U1.33 (IOVDD), U1.42 (IOVDD), U1.43 (ADC_AVDD), U1.44 (VREG_VIN), U1.48 (USB_VDD), U1.49 (IOVDD), U2.8 (VCC), U4.2 (VO), U5.3 (VI), U7.1 (VCCA), U7.5 (DIR), U8.6 (V_{CCB})
/BOOT: R9.2, SW1.1
/CC1: J1.A5 (CC1), R2.1
/CC2: J1.B5 (CC2), R3.1
/GND: C1.2, C2.2, C3.2, C4.2, C5.2, C6.2, C7.2, C8.2, C9.2, C10.2, C11.2, C12.2, C13.2, C14.2, C15.2, C16.2, C17.2, C18.2, C19.2, C20.2, C21.2, J1.A1 (GND), J1.A12 (GND), J1.B1 (GND), J1.B12 (GND), J1.SH (SHIELD), P3.1, R2.2, R3.2, R6.2, R13.2, R14.2, SW1.2, TP4.1, U1.19 (TESTEN), U1.57 (GND), U2.4 (GND), U3.2 (GND), U4.1 (GND), U5.1 (GND), U6.2 (GND), U7.2 (GND), U8.2 (GND), Y1.2 (G), Y1.4 (G)
/ISET: R6.1, U6.3 (ISET)
/LED_ACT: D2.2 (A), U1.27 (GPIO16)
/LED_ACT_K: D2.1 (K), R14.1
/LED_USB: D1.2 (A), U1.4 (GPIO2)
/LED_USB_K: D1.1 (K), R13.1
/P_SWCLK: P1.1, R11.2
/P_SWDIO: P2.1, R12.2
/QSPI_SCLK: U1.52 (QSPI_SCLK), U2.6 (CLK)
/QSPI_SD0: U1.53 (QSPI_SD0), U2.5 (DI/IO_{0})
/QSPI_SD1: U1.55 (QSPI_SD1), U2.2 (DO/IO_{1})
/QSPI_SD2: U1.54 (QSPI_SD2), U2.3 (~WP/IO_{2})
/QSPI_SD3: U1.51 (QSPI_SD3), U2.7 (~HOLD/~RESET/IO_{3})
/QSPI_SS: R8.2, R9.1, U1.56 (~QSPI_SS), U2.1 (~CS)
/RP_SWCLK: TP1.1, U1.24 (SWCLK)
/RP_SWDIO: TP2.1, U1.25 (SWDIO)
/RUN: R7.2, TP3.1, U1.26 (RUN)
/SWCLK_1V8: R11.1, U7.4 (B)
/SWCLK_3V3: U1.15 (GPIO12), U7.3 (A)
/SWDIO_1V8: R12.1, U8.3 (A)
/SWDIO_3V3: R10.2, U1.16 (GPIO13), U8.4 (B)
/SWDIO_DRV: R10.1, U1.17 (GPIO14)
/USB_DM: J1.A7 (D-), J1.B7 (D-), R5.1, U3.3 (I/O2), U3.4 (I/O2)
/USB_DM_MCU: R5.2, U1.46 (USB_DM)
/USB_DP: J1.A6 (D+), J1.B6 (D+), R4.1, U3.1 (I/O1), U3.6 (I/O1)
/USB_DP_MCU: R4.2, U1.47 (USB_DP)
/VBUS: F1.1, J1.A4 (VBUS), J1.A9 (VBUS), J1.B4 (VBUS), J1.B9 (VBUS), U3.5 (VBUS)
/VBUS_F: C3.1, C6.1, F1.2, U4.3 (VI), U6.4 (EN), U6.5 (IN)
/VIN_BAND: C7.1, P4.1, U6.1 (OUT)
/XIN: C1.1, U1.20 (XIN), Y1.1
/XOUT: R1.1, U1.21 (XOUT)
/XOUT_X: C2.1, R1.2, Y1.3

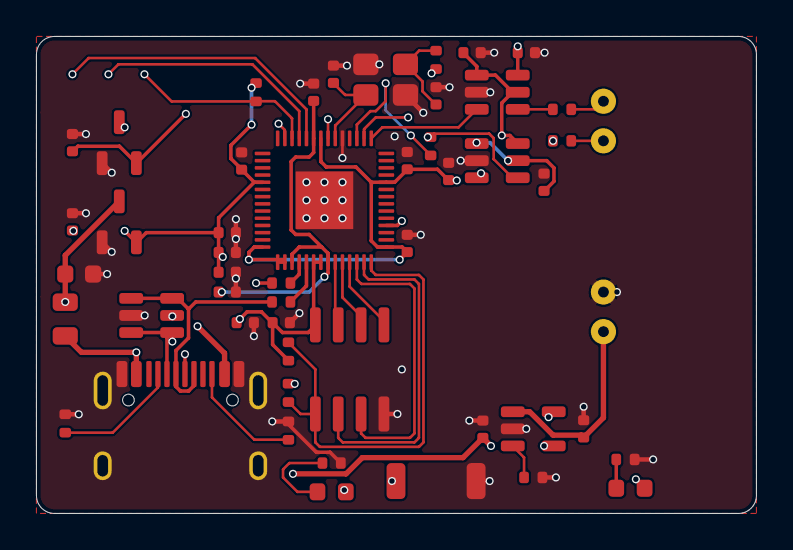
[picture p58: board dock-pcb-rev-b.kicad_pcb from above]

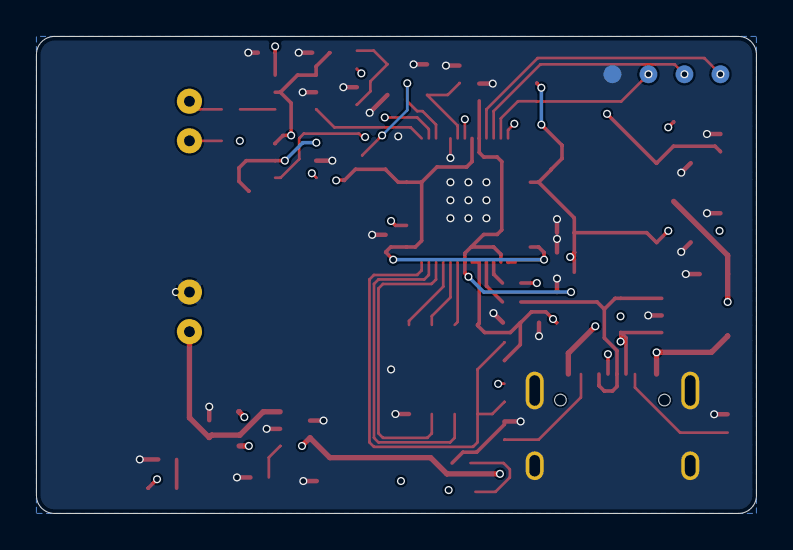
[picture p59: board dock-pcb-rev-b.kicad_pcb from below]

Board: 4 copper layers, 40.0 x 26.5 mm, 57 parts (4 on the bottom side), 38 nets.
