DevonHope/FOSS-Health-Alarm/hardware/band/rev-b/pcb/rigid-rev-b.kicad_pcb

## KiCad design hardware/band/rev-b/pcb/rigid-rev-b.kicad_pcb (2026-11-10, an earlier design)

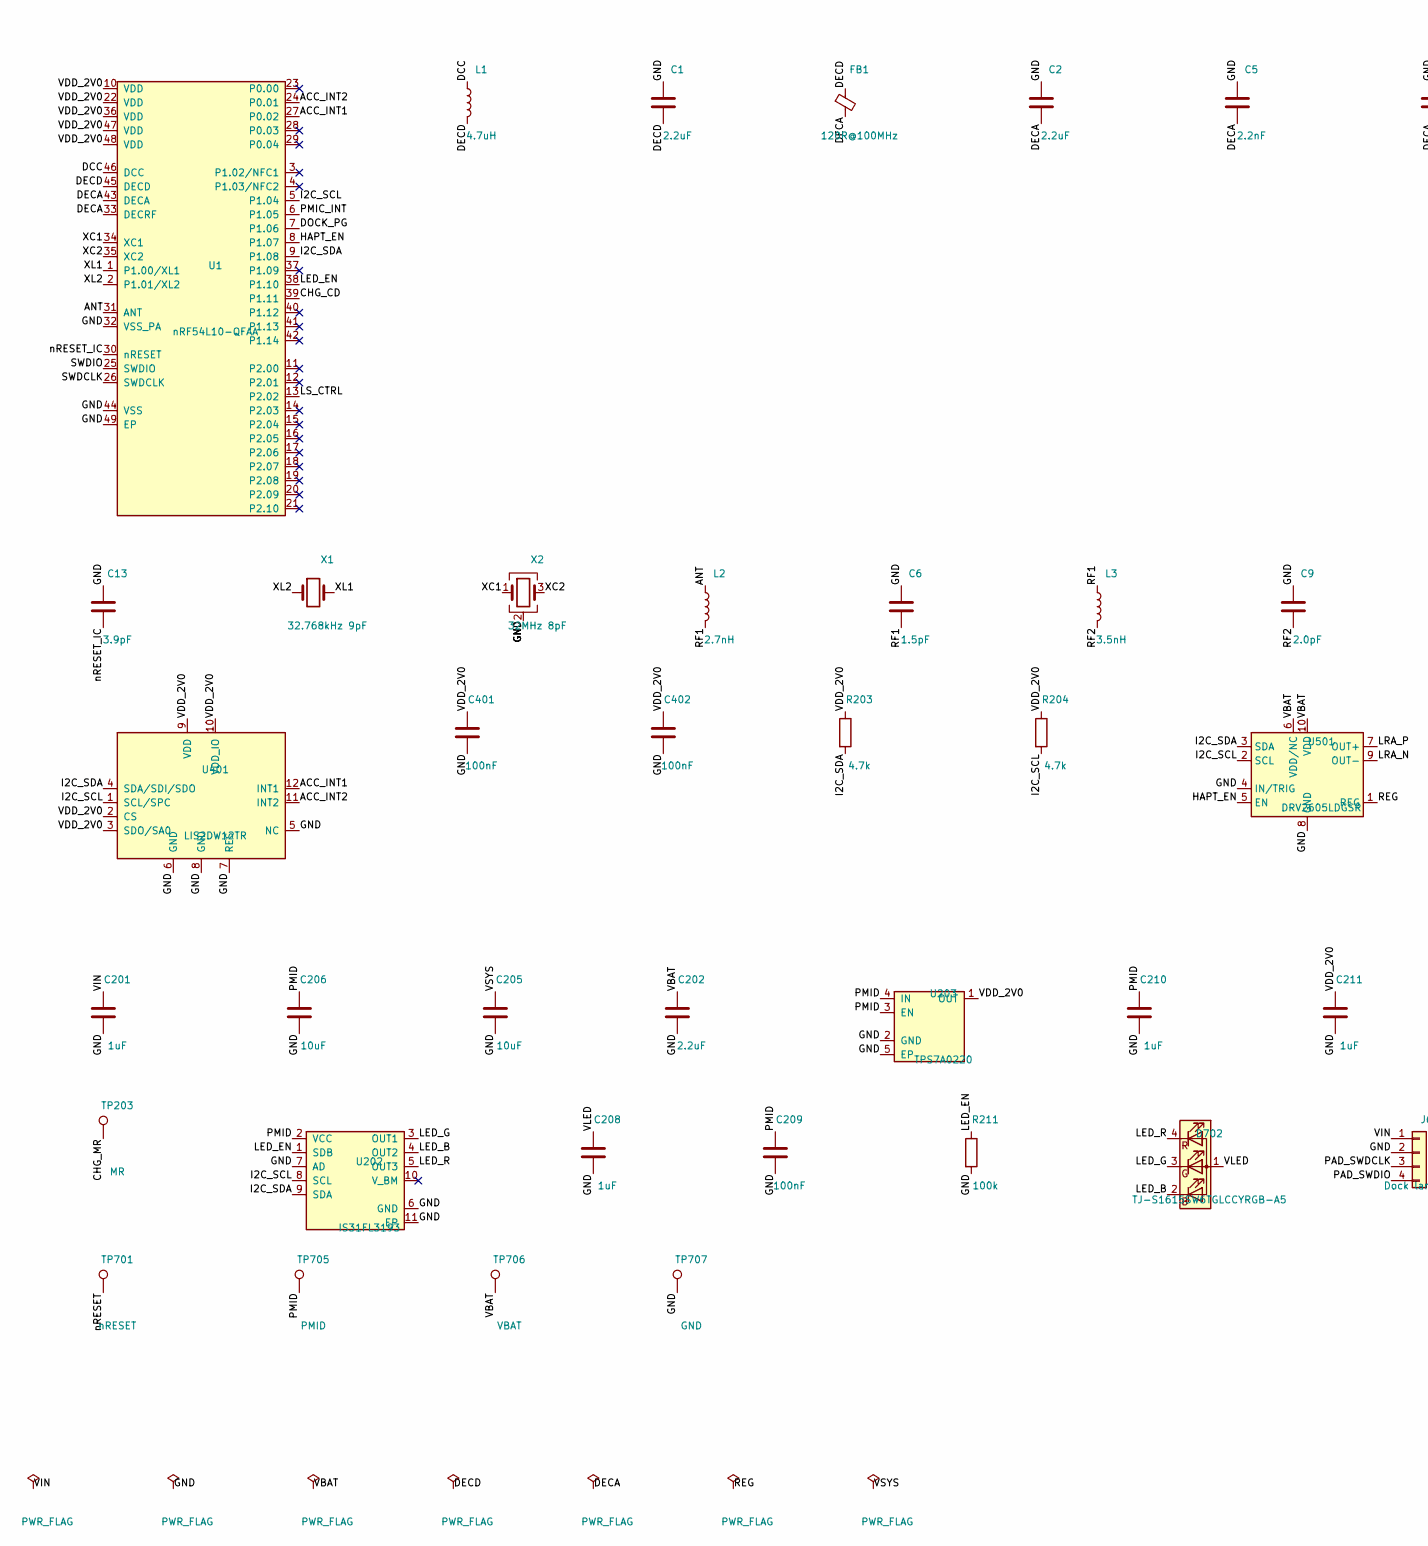
[picture p60: schematic rigid-rev-b.kicad_sch, WakeBand rigid rev B - all parts JLCPCB-assembled, part in row 1, column 1]

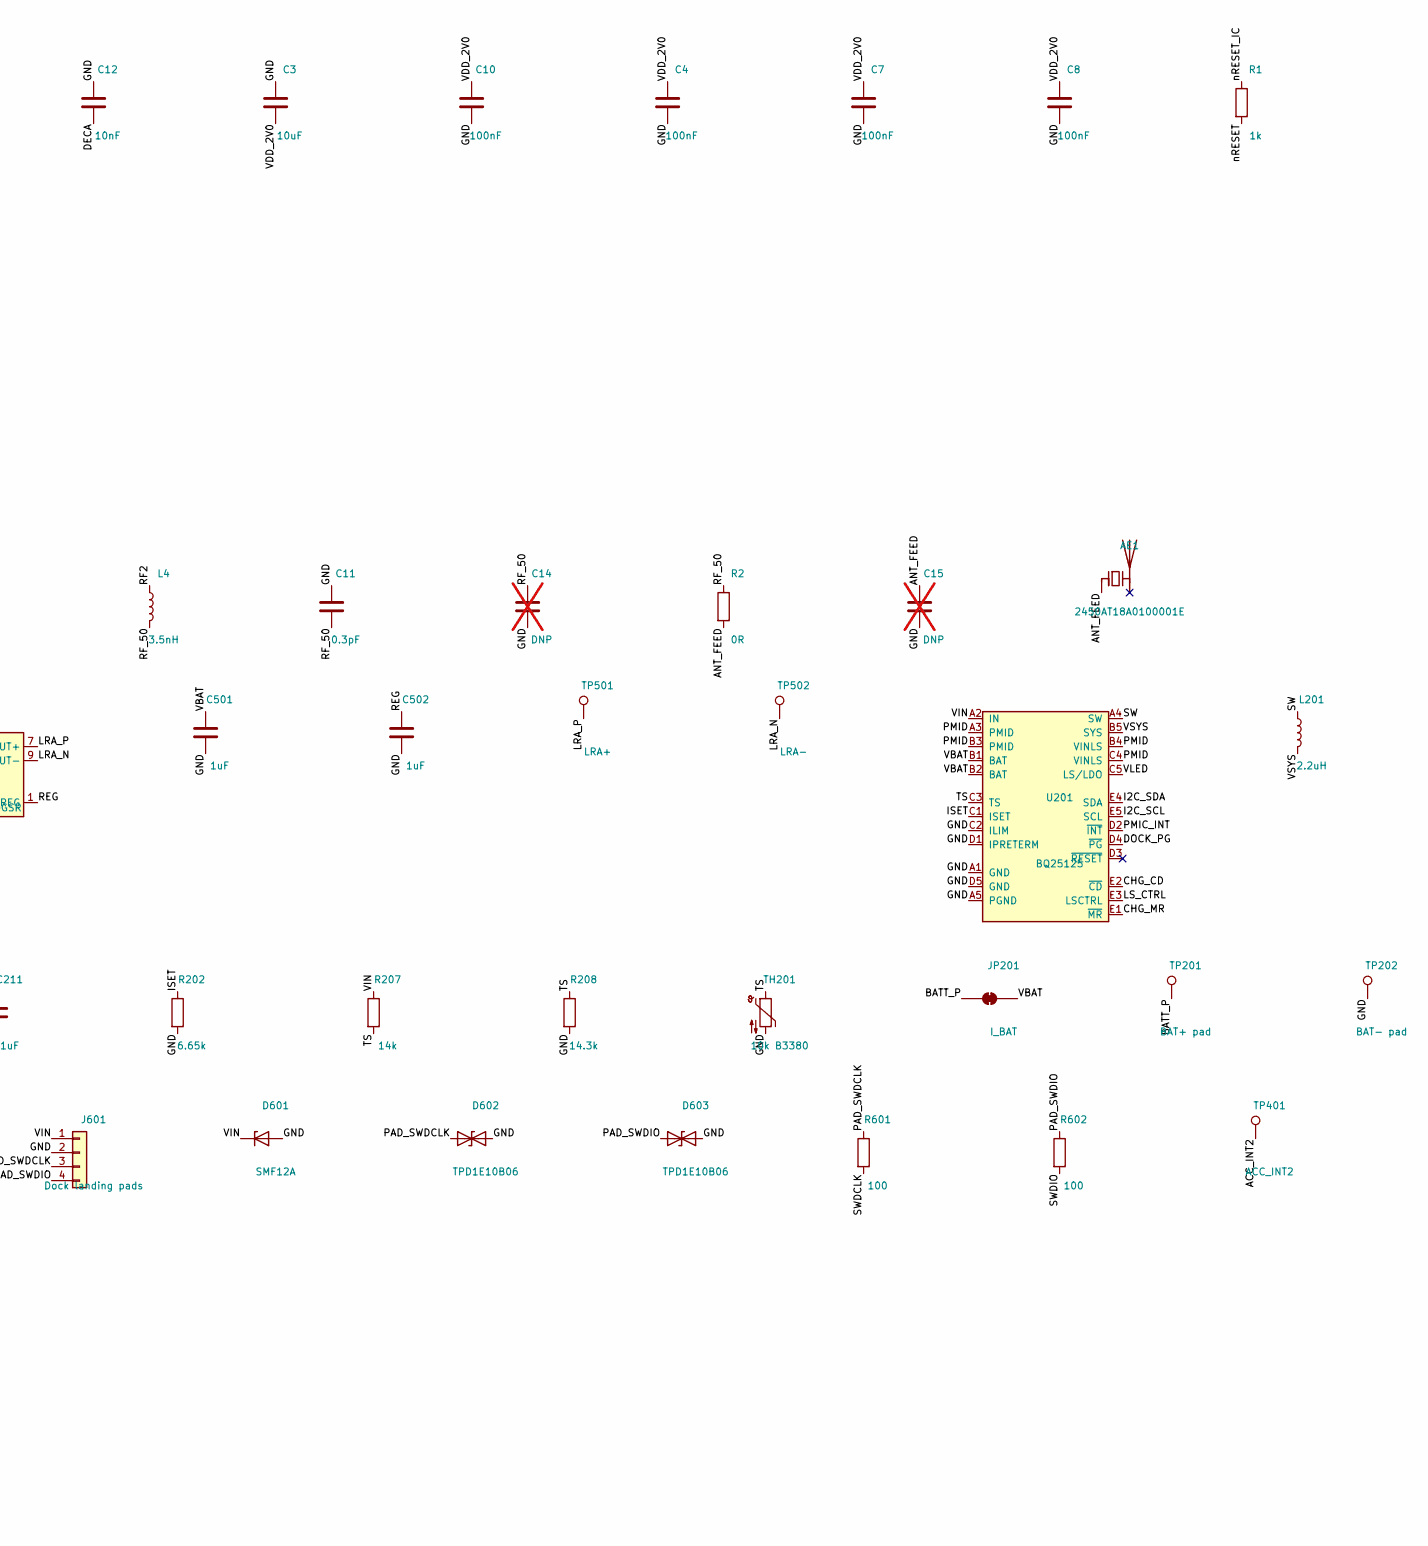
[picture p61: schematic rigid-rev-b.kicad_sch, WakeBand rigid rev B - all parts JLCPCB-assembled, part in row 1, column 2]

Parts:
AE1: 2450AT18A0100001E; Johanson_2450AT18x100; MPN Johanson 2450AT18A0100001E; LCSC C17430588
C1, C2: 2.2uF; Nordic_CAPC0603X03L_C; MPN Murata GRM033R61A225KE47D; LCSC C335106
C3: 10uF; Nordic_CAPC1005X04L; LCSC C15525
C4, C7, C8, C10: 100nF; Nordic_CAPC0603X03L_C; LCSC C307380
C5: 2.2nF; Nordic_CAPC0603X03L_C; MPN Murata GRM033R71A222KA01D; LCSC C161479
C6: 1.5pF; Nordic_CAPC0603X03L_C; MPN Murata GJM0335C1E1R5WB01D; LCSC C435397
C9: 2.0pF; Nordic_CAPC0603X03L_C; MPN Murata GJM0335C1E2R0WB01D; LCSC C668326
C11: 0.3pF; Nordic_CAPC0603X03L_C; MPN Murata GRM0335C1HR30BA01D; LCSC C76927
C12: 10nF; Nordic_CAPC0603X03L_C; MPN Murata GRM033R71A103KA01D; LCSC C76941
C13: 3.9pF; Nordic_CAPC0603X03L_C; MPN Murata GRM0335C1H3R9CA01D; LCSC C76926
C14, C15: DNP; C_0402_1005Metric; not fitted
C201, C208, C501, C502: 1uF; C_0402_1005Metric; LCSC C52923
C202: 2.2uF; C_0603_1608Metric; LCSC C23630
C205, C206: 10uF; C_0603_1608Metric; LCSC C96446
C209, C401, C402: 100nF; C_0402_1005Metric; LCSC C1525
C210, C211: 1uF; Nordic_CAPC0603X03L_C; MPN Samsung CL03A105MO3NRNH; LCSC C307385
D601: SMF12A; D_SOD-123F; MPN Littelfuse SMF12A; LCSC C207255
D602, D603: TPD1E10B06; Texas_DPY0002A_0.6x1mm_P0.65mm; MPN TI TPD1E10B06DPYR; LCSC C48260
D702: TJ-S1615SW6TGLCCYRGB-A5; LED_TOGIALED_1615_RGB_CommonAnode; MPN TOGIALED TJ-S1615SW6TGLCCYRGB-A5; LCSC C273610
FB1: 120R@100MHz; Nordic_INDC0603X03L_C; MPN Murata BLM03AG121SN1D; LCSC C97850
J601: Dock landing pads; DockLanding_4xB_D1.6mm
JP201: I_BAT; SolderJumper-2_P1.3mm_Bridged_RoundedPad1.0x1.5mm
L1: 4.7uH; Nordic_INDC1608X06L; MPN TDK MLZ1608M4R7WT000; LCSC C76799
L2: 2.7nH; Nordic_INDC0603X03L_C; MPN Murata LQP03HQ2N7B02D; LCSC C7216765
L3, L4: 3.5nH; Nordic_INDC0603X03L_C; MPN Murata LQP03HQ3N5B02D; LCSC C3911055
L201: 2.2uH; L_Murata_DFE201610P; MPN Murata DFE201610E-2R2M; LCSC C337891
R1: 1k; Nordic_RESC0603X03L_C; LCSC C270365
R2: 0R; R_0402_1005Metric; LCSC C17168
R202: 6.65k; R_0402_1005Metric; LCSC C45194
R203, R204: 4.7k; R_0402_1005Metric; LCSC C25900
R207: 14k; R_0402_1005Metric; LCSC C54831
R208: 14.3k; R_0402_1005Metric; LCSC C25855
R211: 100k; R_0402_1005Metric; LCSC C25741
R601, R602: 100; R_0402_1005Metric; LCSC C25076
TH201: 10k B3380; R_0402_1005Metric; MPN Murata NCP15XH103F03RC; LCSC C77131
TP201: BAT+ pad; TestPoint_Pad_2.0x2.0mm
TP202: BAT- pad; TestPoint_Pad_1.5x1.5mm
TP203: MR; TestPoint_Pad_D0.8mm
TP401: ACC_INT2; TestPoint_Pad_D0.8mm
TP501: LRA+; Pad_SMD_1.0x1.5mm
TP502: LRA-; Pad_SMD_1.0x1.5mm
TP701: nRESET; TestPoint_Pad_D0.8mm
TP705: PMID; TestPoint_Pad_D0.8mm
TP706: VBAT; TestPoint_Pad_D0.8mm
TP707: GND; TestPoint_Pad_D0.8mm
U1: nRF54L10-QFAA; Nordic_QFN40P600X600X90-48N; MPN Nordic NRF54L10-QFAA-R7; LCSC C44800139
U201: BQ25125; TI_DSBGA-25_2.5x2.5mm_Layout5x5_P0.4mm; MPN TI BQ25125YFPR; LCSC C2871567
U202: IS31FL3193; DFN-10-1EP_3x3mm_P0.5mm_EP1.65x2.38mm; MPN Lumissil IS31FL3193-DLS2-TR; LCSC C2653363
U203: TPS7A0220; Texas_X2SON-4_1x1mm_P0.65mm_SilkTrim; MPN TI TPS7A0220PDQNR; LCSC C2860934
U401: LIS2DW12TR; LGA-12_2x2mm_P0.5mm; MPN ST LIS2DW12TR; LCSC C189624
U501: DRV2605LDGSR; TSSOP-10_3x3mm_P0.5mm; MPN TI DRV2605LDGSR; LCSC C527464
X1: 32.768kHz 9pF; Nordic_XTAL_2012; MPN Epson FC-12M X1A0000610008; LCSC C96341
X2: 32MHz 8pF; Nordic_BT-XTAL_2016; MPN Yangxing XL7EL89CKI-111YLC-32M; LCSC C2965582

Connections:
/ACC_INT1: U1.27 (P0.02), U401.12 (INT1)
/ACC_INT2: TP401.1, U1.24 (P0.01), U401.11 (INT2)
/ANT: L2.1, U1.31 (ANT)
/ANT_FEED: AE1.1 (FEED), C15.1, R2.2
/BATT_P: JP201.1 (A), TP201.1
/CHG_CD: U1.39 (P1.11), U201.E2 (~CD)
/CHG_MR: TP203.1, U201.E1 (~MR)
/DCC: L1.1, U1.46 (DCC)
/DECA: C2.2, C5.2, C12.2, FB1.2, U1.33 (DECRF), U1.43 (DECA)
/DECD: C1.2, FB1.1, L1.2, U1.45 (DECD)
/DOCK_PG: U1.7 (P1.06), U201.D4 (~PG)
/GND: C1.1, C2.1, C3.1, C4.2, C5.1, C6.1, C7.2, C8.2, C9.1, C10.2, C11.1, C12.1, C13.1, C14.2, C15.2, C201.2, C202.2, C205.2, C206.2, C208.2, C209.2, C210.2, C211.2, C401.2, C402.2, C501.2, C502.2, D601.2 (A), D602.2 (A2), D603.2 (A2), J601.2, R202.2, R208.2, R211.2, TH201.2, TP202.1, TP707.1, U1.32 (VSS_PA), U1.44 (VSS), U1.49 (EP), U201.A1 (GND), U201.A5 (PGND), U201.C2 (ILIM), U201.D1 (IPRETERM), U201.D5 (GND), U202.6 (GND), U202.7 (AD), U202.11 (EP), U203.2 (GND), U203.5 (EP), U401.5 (NC), U401.6 (GND), U401.7 (RES), U401.8 (GND), U501.4 (IN/TRIG), U501.8 (GND), X2.2 (G), X2.4 (G)
/HAPT_EN: U1.8 (P1.07), U501.5 (EN)
/I2C_SCL: R204.2, U1.5 (P1.04), U201.E5 (SCL), U202.8 (SCL), U401.1 (SCL/SPC), U501.2 (SCL)
/I2C_SDA: R203.2, U1.9 (P1.08), U201.E4 (SDA), U202.9 (SDA), U401.4 (SDA/SDI/SDO), U501.3 (SDA)
/ISET: R202.1, U201.C1 (ISET)
/LED_B: D702.2 (BK), U202.4 (OUT2)
/LED_EN: R211.1, U1.38 (P1.10), U202.1 (SDB)
/LED_G: D702.3 (GK), U202.3 (OUT1)
/LED_R: D702.4 (RK), U202.5 (OUT3)
/LRA_N: TP502.1, U501.9 (OUT-)
/LRA_P: TP501.1, U501.7 (OUT+)
/LS_CTRL: U1.13 (P2.02), U201.E3 (LSCTRL)
/PAD_SWDCLK: D602.1 (A1), J601.3, R601.1
/PAD_SWDIO: D603.1 (A1), J601.4, R602.1
/PMIC_INT: U1.6 (P1.05), U201.D2 (~INT)
/PMID: C206.1, C209.1, C210.1, TP705.1, U201.A3 (PMID), U201.B3 (PMID), U201.B4 (VINLS), U201.C4 (VINLS), U202.2 (VCC), U203.3 (EN), U203.4 (IN)
/REG: C502.1, U501.1 (REG)
/RF1: C6.2, L2.2, L3.1
/RF2: C9.2, L3.2, L4.1
/RF_50: C11.2, C14.1, L4.2, R2.1
/SW: L201.1, U201.A4 (SW)
/SWDCLK: R601.2, U1.26 (SWDCLK)
/SWDIO: R602.2, U1.25 (SWDIO)
/TS: R207.2, R208.1, TH201.1, U201.C3 (TS)
/VBAT: C202.1, C501.1, JP201.2 (B), TP706.1, U201.B1 (BAT), U201.B2 (BAT), U501.6 (VDD/NC), U501.10 (VDD)
/VDD_2V0: C3.2, C4.1, C7.1, C8.1, C10.1, C211.1, C401.1, C402.1, R203.1, R204.1, U1.10 (VDD), U1.22 (VDD), U1.36 (VDD), U1.47 (VDD), U1.48 (VDD), U203.1 (OUT), U401.2 (CS), U401.3 (SDO/SA0), U401.9 (VDD), U401.10 (VDD_IO)
/VIN: C201.1, D601.1 (K), J601.1, R207.1, U201.A2 (IN)
/VLED: C208.1, D702.1 (A), U201.C5 (LS/LDO)
/VSYS: C205.1, L201.2, U201.B5 (SYS)
/XC1: U1.34 (XC1), X2.1
/XC2: U1.35 (XC2), X2.3
/XL1: U1.1 (P1.00/XL1), X1.2
/XL2: U1.2 (P1.01/XL2), X1.1
/nRESET: R1.2, TP701.1
/nRESET_IC: C13.2, R1.1, U1.30 (nRESET)

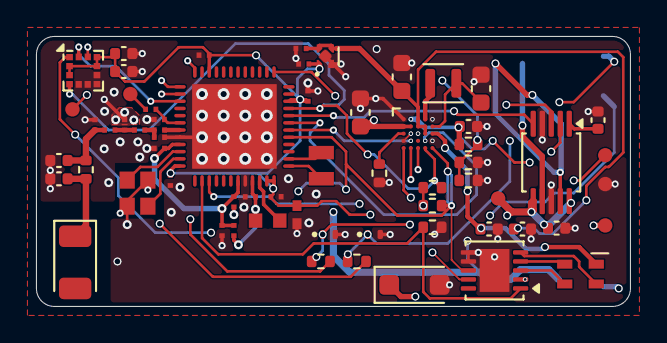
[picture p62: board rigid-rev-b.kicad_pcb from above]

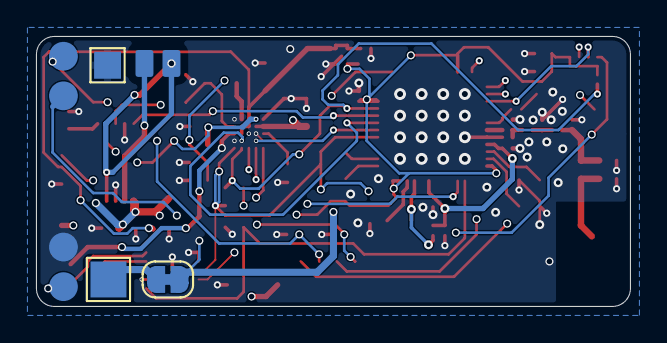
[picture p63: board rigid-rev-b.kicad_pcb from below]

Board: 4 copper layers, 33.0 x 15.0 mm, 69 parts (5 on the bottom side), 46 nets.
