DevonHope/FOSS-Health-Alarm/hardware/band/rev-a/pcb/rigid-rev-a.kicad_pcb

## KiCad design hardware/band/rev-a/pcb/rigid-rev-a.kicad_pcb (2026-11-10, an earlier design)

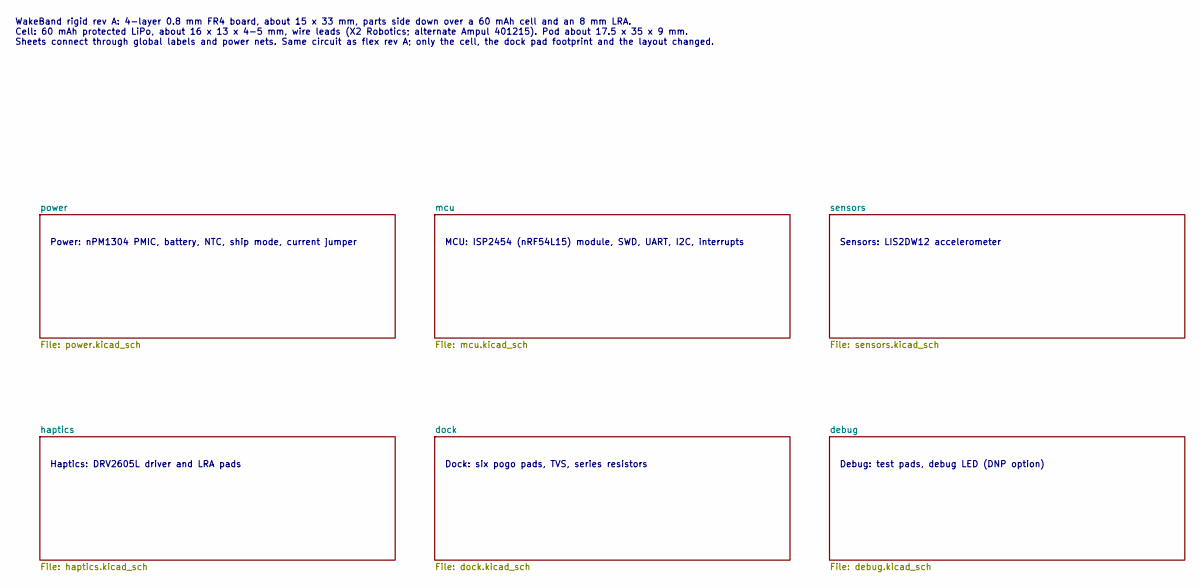
[picture p64: schematic rigid-rev-a.kicad_sch, WakeBand rigid rev A - Top]

Notes on the sheet:
Haptics: DRV2605L driver and LRA pads
Power: nPM1304 PMIC, battery, NTC, ship mode, current jumper
Debug: test pads, debug LED (DNP option)
Dock: six pogo pads, TVS, series resistors
Sensors: LIS2DW12 accelerometer
WakeBand rigid rev A: 4-layer 0.8 mm FR4 board, about 15 x 33 mm, parts side down over a 60 mAh cell and an 8 mm LRA. Cell: 60 mAh protected LiPo, about 16 x 13 x 4-5 mm, wire leads (X2 Robotics; alternate Ampul 401215). Pod about 17.5 x 35 x 9 mm. Sheets connect through global labels and power net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
MCU: ISP2454 (nRF54L15) module, SWD, UART, I2C, interrupts

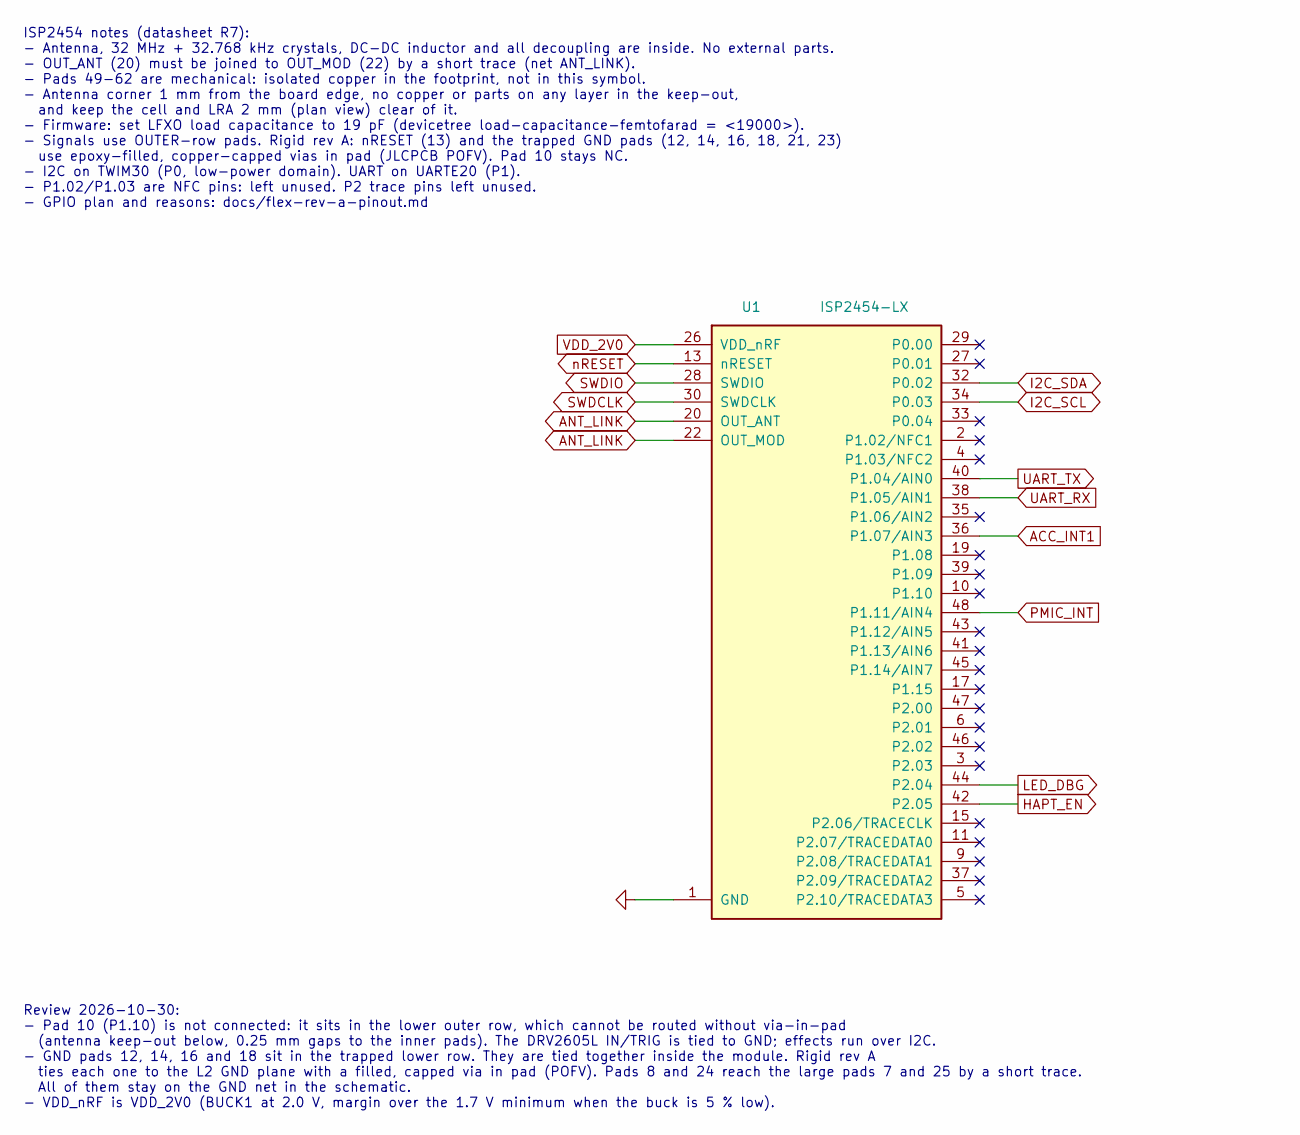
[picture p65: schematic mcu.kicad_sch, WakeBand rigid rev A - MCU]

Parts:
U1: ISP2454-LX; InsightSiP_ISP2454_LGA-62_8x8mm

Connections:
ACC_INT1: U1.36 (P1.07/AIN3); also elsewhere on the board
ANT_LINK: U1.20 (OUT_ANT), U1.22 (OUT_MOD)
GND: U1.1 (GND), U1.7 (GND), U1.8 (GND), U1.12 (GND), U1.14 (GND), U1.16 (GND), U1.18 (GND), U1.21 (GND), U1.23 (GND), U1.24 (GND), U1.25 (GND), U1.31 (GND); also elsewhere on the board
HAPT_EN: U1.42 (P2.05); also elsewhere on the board
I2C_SCL: U1.34 (P0.03); also elsewhere on the board
I2C_SDA: U1.32 (P0.02); also elsewhere on the board
LED_DBG: U1.44 (P2.04); also elsewhere on the board
PMIC_INT: U1.48 (P1.11/AIN4); also elsewhere on the board
SWDCLK: U1.30 (SWDCLK); also elsewhere on the board
SWDIO: U1.28 (SWDIO); also elsewhere on the board
UART_RX: U1.38 (P1.05/AIN1); also elsewhere on the board
UART_TX: U1.40 (P1.04/AIN0); also elsewhere on the board
VDD_2V0: U1.26 (VDD_nRF); also elsewhere on the board
nRESET: U1.13 (nRESET); also elsewhere on the board

Notes on the sheet:
Review 2026-10-30: - Pad 10 (P1.10) is not connected: it sits in the lower outer row, which cannot be routed without via-in-pad (antenna keep-out below, 0.25 mm gaps to the inner pads). The DRV2605L IN/TRIG is tied to GND; effects run over I2C. - GND pads 12, 14, 16 and 18 sit in the trapped lower 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
ISP2454 notes (datasheet R7): - Antenna, 32 MHz + 32.768 kHz crystals, DC-DC inductor and all decoupling are inside. No external parts. - OUT_ANT (20) must be joined to OUT_MOD (22) by a short trace (net ANT_LINK). - Pads 49-62 are mechanical: isolated copper in the footprint, not in this symbol. -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

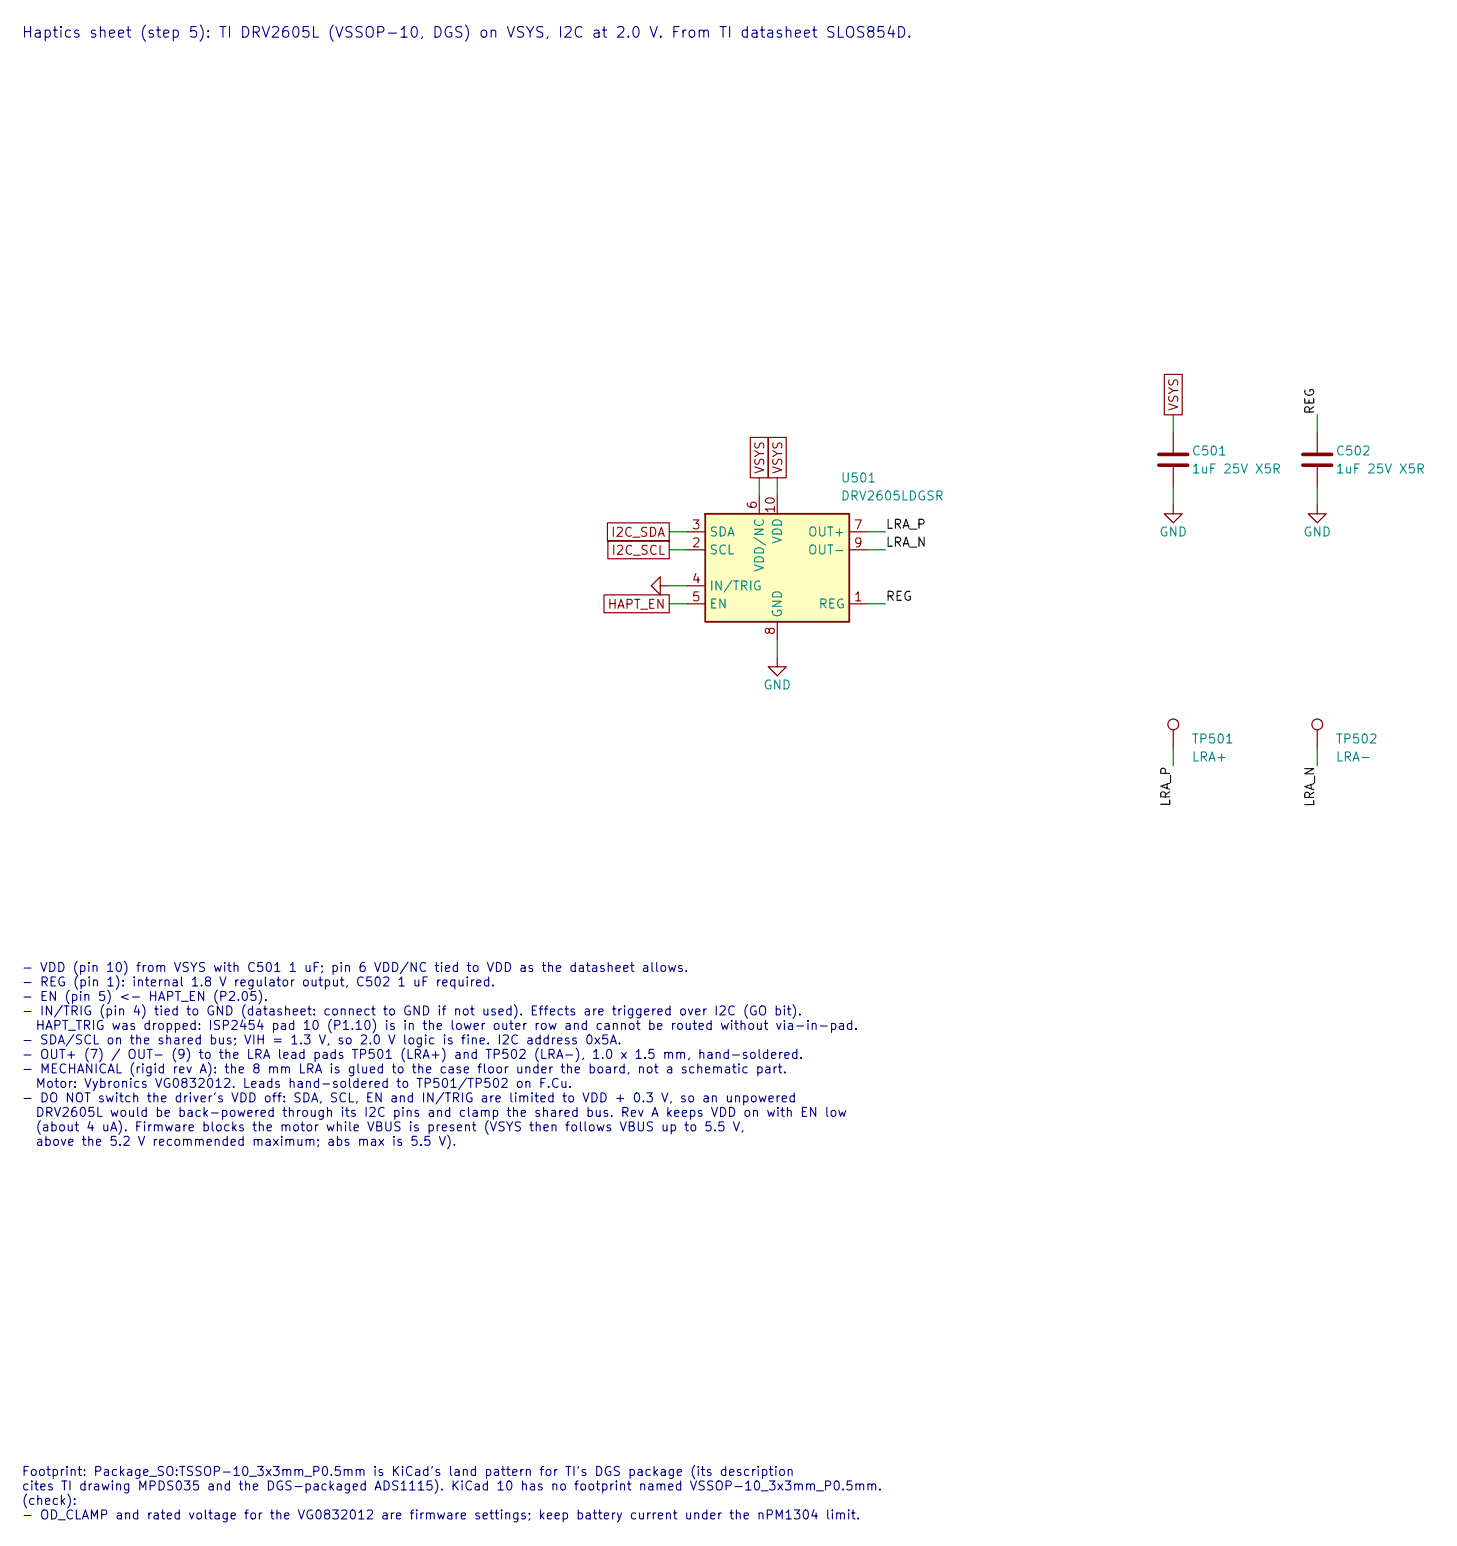
[picture p66: schematic haptics.kicad_sch, WakeBand rigid rev A - Haptics]

Parts:
C501, C502: 1uF 25V X5R; C_0402_1005Metric; LCSC C52923
TP501: LRA+; Pad_SMD_1.0x1.5mm
TP502: LRA-; Pad_SMD_1.0x1.5mm
U501: DRV2605LDGSR; TSSOP-10_3x3mm_P0.5mm; LCSC C527464

Connections:
/haptics/LRA_N: TP502.1, U501.9 (OUT-)
/haptics/LRA_P: TP501.1, U501.7 (OUT+)
/haptics/REG: C502.1, U501.1 (REG)
GND: C501.2, C502.2, U501.4 (IN/TRIG), U501.8 (GND); also elsewhere on the board
HAPT_EN: U501.5 (EN); also elsewhere on the board
I2C_SCL: U501.2 (SCL); also elsewhere on the board
I2C_SDA: U501.3 (SDA); also elsewhere on the board
VSYS: C501.1, U501.6 (VDD/NC), U501.10 (VDD); also elsewhere on the board

Notes on the sheet:
Footprint: Package_SO:TSSOP-10_3x3mm_P0.5mm is KiCad's land pattern for TI's DGS package (its description cites TI drawing MPDS035 and the DGS-packaged ADS1115). KiCad 10 has no footprint named VSSOP-10_3x3mm_P0.5mm. (check): - OD_CLAMP and rated voltage for the VG0832012 are firmware settings; kee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
Haptics sheet (step 5): TI DRV2605L (VSSOP-10, DGS) on VSYS, I2C at 2.0 V. From TI datasheet SLOS854D.
- VDD (pin 10) from VSYS with C501 1 uF; pin 6 VDD/NC tied to VDD as the datasheet allows. - REG (pin 1): internal 1.8 V regulator output, C502 1 uF required. - EN (pin 5) <- HAPT_EN (P2.05). - IN/TRIG (pin 4) tied to GND (datasheet: connect to GND if not used). Effects are triggered over I2C (GO b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
