DevonHope/FOSS-Health-Alarm/hardware/band/rev-a/pcb/rigid-rev-a.kicad_pcb

## KiCad design hardware/band/rev-a/pcb/rigid-rev-a.kicad_pcb (continued)

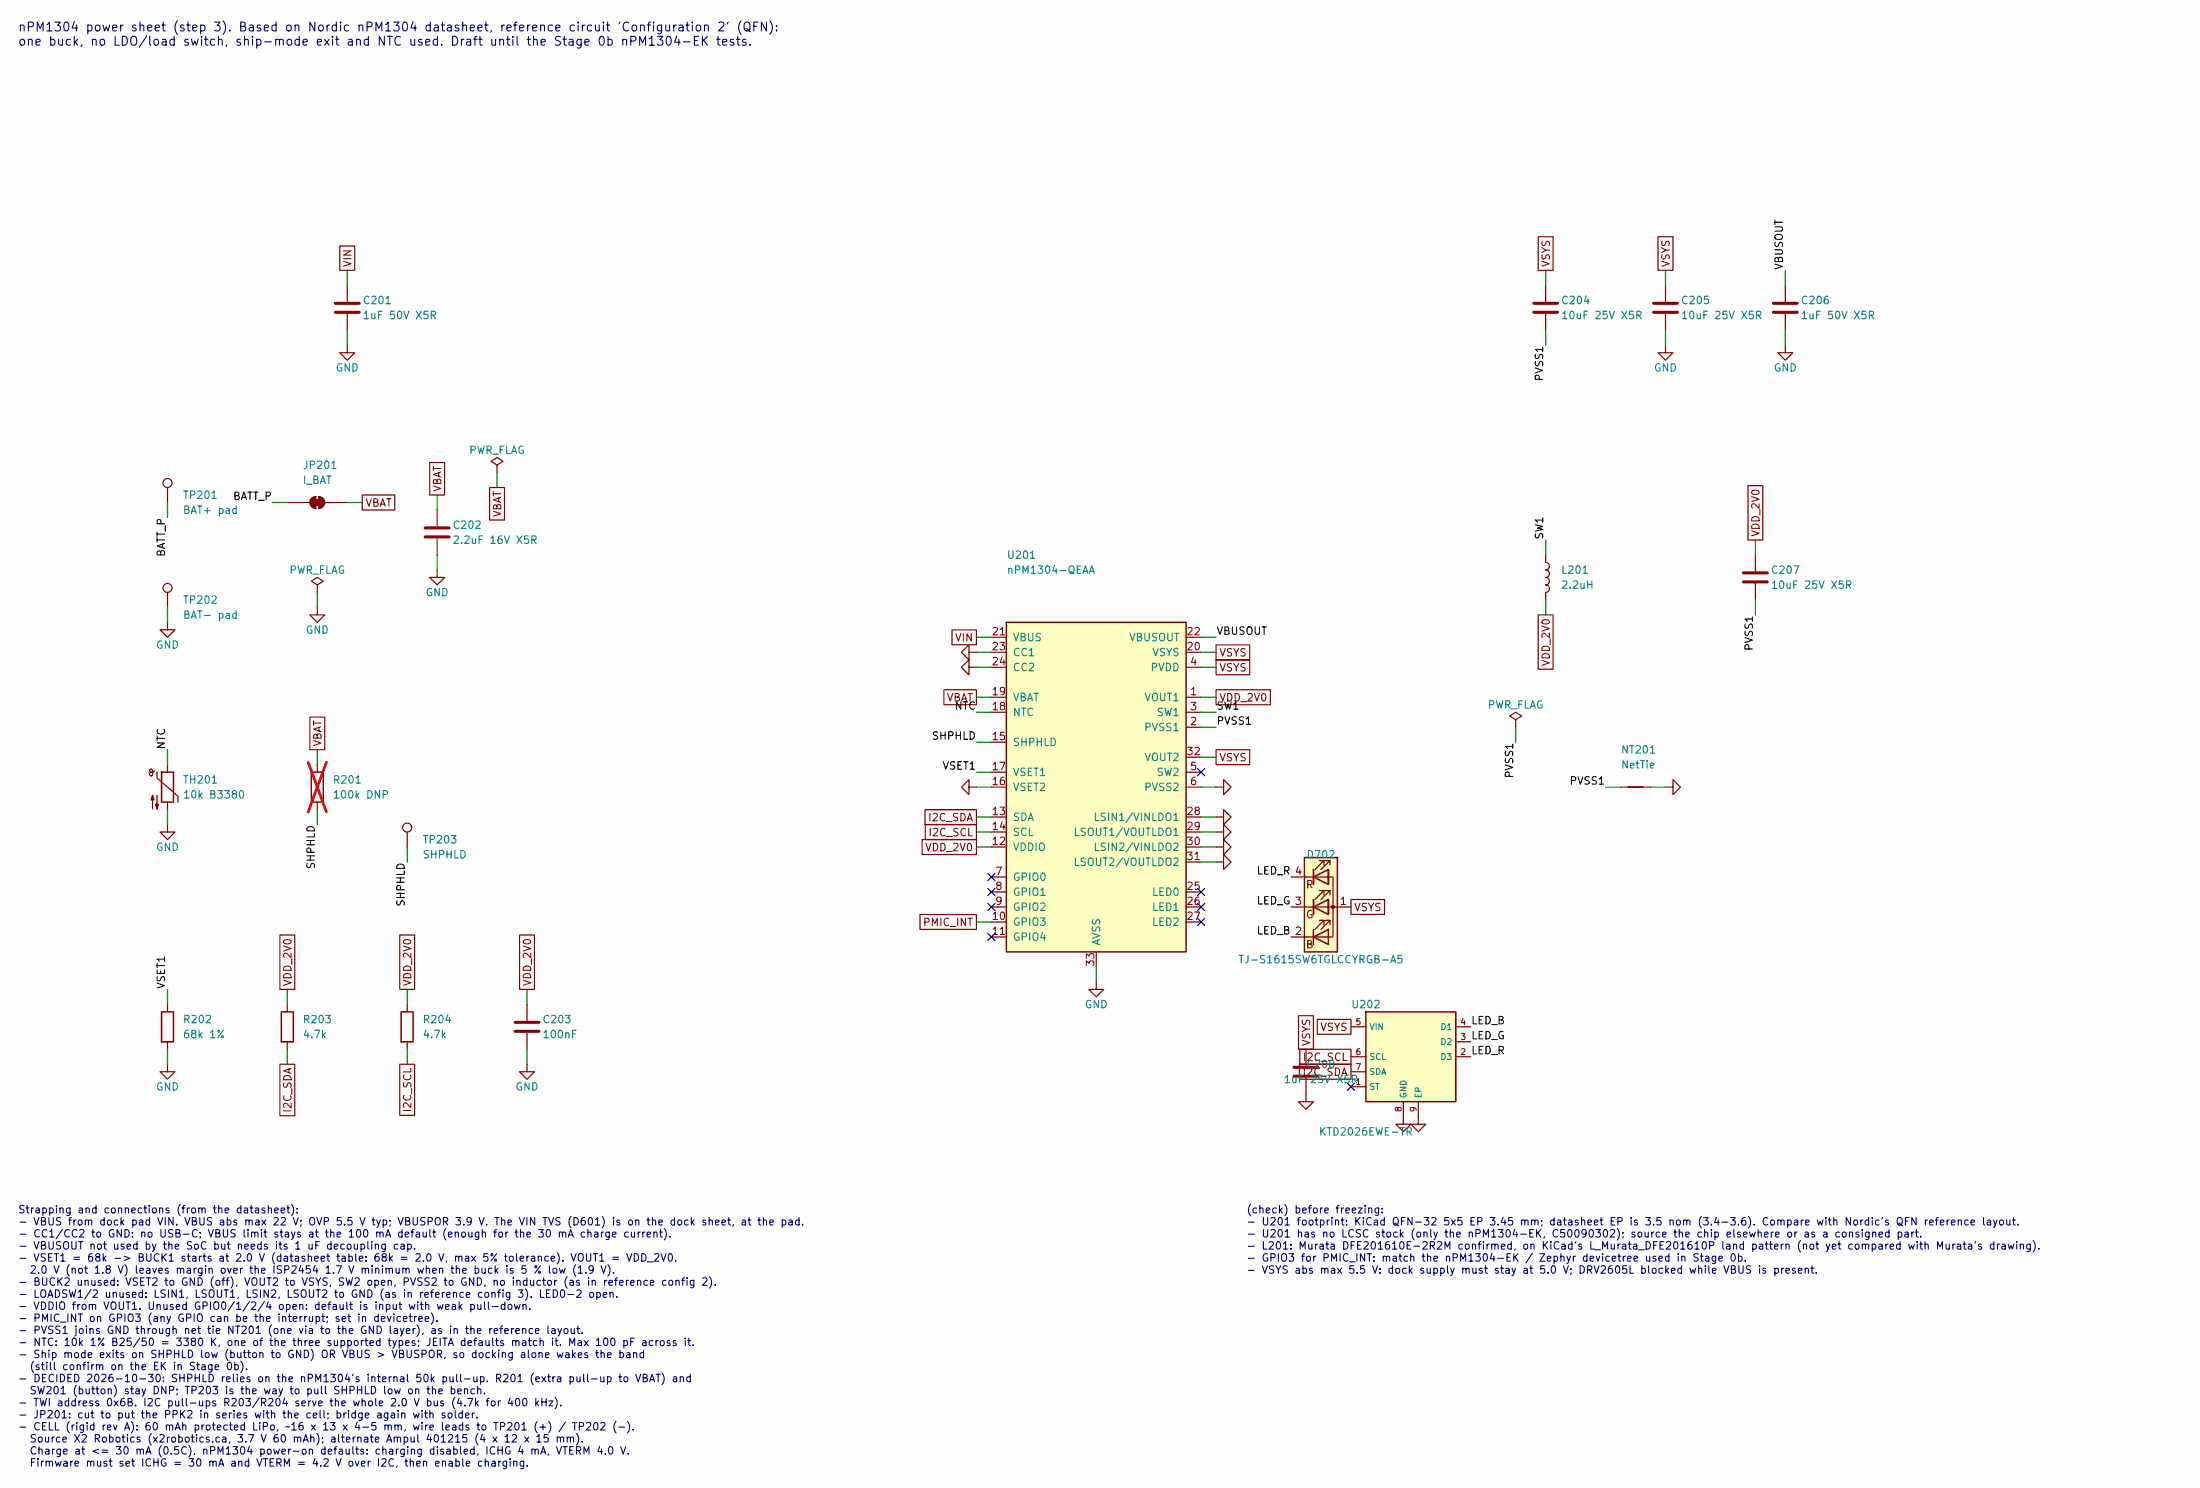
[picture p67: schematic power.kicad_sch, WakeBand rigid rev A - Power]

Parts:
C201, C206: 1uF 50V X5R; C_0603_1608Metric; LCSC C15849
C202: 2.2uF 16V X5R; C_0603_1608Metric; LCSC C23630
C203: 100nF; C_0402_1005Metric; LCSC C1525
C204, C205, C207: 10uF 25V X5R; C_0603_1608Metric; LCSC C96446
C208: 1uF 25V X5R; C_0402_1005Metric; LCSC C52923
D702: TJ-S1615SW6TGLCCYRGB-A5; LED_TOGIALED_1615_RGB_CommonAnode; LCSC C273610
JP201: I_BAT; SolderJumper-2_P1.3mm_Bridged_RoundedPad1.0x1.5mm
L201: 2.2uH; L_Murata_DFE201610P; MPN Murata DFE201610E-2R2M; LCSC C337891
NT201: NetTie; NetTie-2_SMD_Pad0.5mm
R201: 100k DNP; R_0402_1005Metric; LCSC C25741; not fitted
R202: 68k 1%; R_0402_1005Metric; LCSC C36871
R203, R204: 4.7k; R_0402_1005Metric; LCSC C25900
TH201: 10k B3380; R_0402_1005Metric; MPN Murata NCP15XH103F03RC; LCSC C77131
TP201: BAT+ pad; TestPoint_Pad_2.0x2.0mm
TP202: BAT- pad; TestPoint_Pad_1.5x1.5mm
TP203: SHPHLD; TestPoint_Pad_1.0x1.0mm
U201: nPM1304-QEAA; QFN-32-1EP_5x5mm_P0.5mm_EP3.45x3.45mm
U202: KTD2026EWE-TR; Kinetic_UTDFN-8_1.5x1.5mm_P0.4mm_EP1.2x0.65mm; MPN Kinetic KTD2026EWE-TR

Connections:
/power/BATT_P: JP201.1 (A), TP201.1
/power/LED_B: D702.2 (BK), U202.4 (D1)
/power/LED_G: D702.3 (GK), U202.3 (D2)
/power/LED_R: D702.4 (RK), U202.2 (D3)
/power/NTC: TH201.1, U201.18 (NTC)
/power/PVSS1: C204.2, C207.2, NT201.1, U201.2 (PVSS1)
/power/SHPHLD: R201.2, TP203.1, U201.15 (SHPHLD)
/power/SW1: L201.1, U201.3 (SW1)
/power/VBUSOUT: C206.1, U201.22 (VBUSOUT)
/power/VSET1: R202.1, U201.17 (VSET1)
GND: C201.2, C202.2, C203.2, C205.2, C206.2, C208.2, NT201.2, R202.2, TH201.2, TP202.1, U201.6 (PVSS2), U201.16 (VSET2), U201.23 (CC1), U201.24 (CC2), U201.28 (LSIN1/VINLDO1), U201.29 (LSOUT1/VOUTLDO1), U201.30 (LSIN2/VINLDO2), U201.31 (LSOUT2/VOUTLDO2), U201.33 (AVSS), U202.8 (GND), U202.9 (EP); also elsewhere on the board
I2C_SCL: R204.2, U201.14 (SCL), U202.6 (SCL); also elsewhere on the board
I2C_SDA: R203.2, U201.13 (SDA), U202.7 (SDA); also elsewhere on the board
PMIC_INT: U201.10 (GPIO3); also elsewhere on the board
VBAT: C202.1, JP201.2 (B), R201.1, U201.19 (VBAT); also elsewhere on the board
VDD_2V0: C203.1, C207.1, L201.2, R203.1, R204.1, U201.1 (VOUT1), U201.12 (VDDIO); also elsewhere on the board
VIN: C201.1, U201.21 (VBUS); also elsewhere on the board
VSYS: C204.1, C205.1, C208.1, D702.1 (A), U201.4 (PVDD), U201.20 (VSYS), U201.32 (VOUT2), U202.5 (VIN); also elsewhere on the board

Notes on the sheet:
Strapping and connections (from the datasheet): - VBUS from dock pad VIN. VBUS abs max 22 V; OVP 5.5 V typ; VBUSPOR 3.9 V. The VIN TVS (D601) is on the dock sheet, at the pad. - CC1/CC2 to GND: no USB-C; VBUS limit stays at the 100 mA default (enough for the 30 mA charge current). - VBUSOUT not use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
(check) before freezing: - U201 footprint: KiCad QFN-32 5x5 EP 3.45 mm; datasheet EP is 3.5 nom (3.4-3.6). Compare with Nordic's QFN reference layout. - U201 has no LCSC stock (only the nPM1304-EK, C50090302); source the chip elsewhere or as a consigned part. - L201: Murata DFE201610E-2R2M confirme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
nPM1304 power sheet (step 3). Based on Nordic nPM1304 datasheet, reference circuit 'Configuration 2' (QFN): one buck, no LDO/load switch, ship-mode exit and NTC used. Draft until the Stage 0b nPM1304-EK tests.

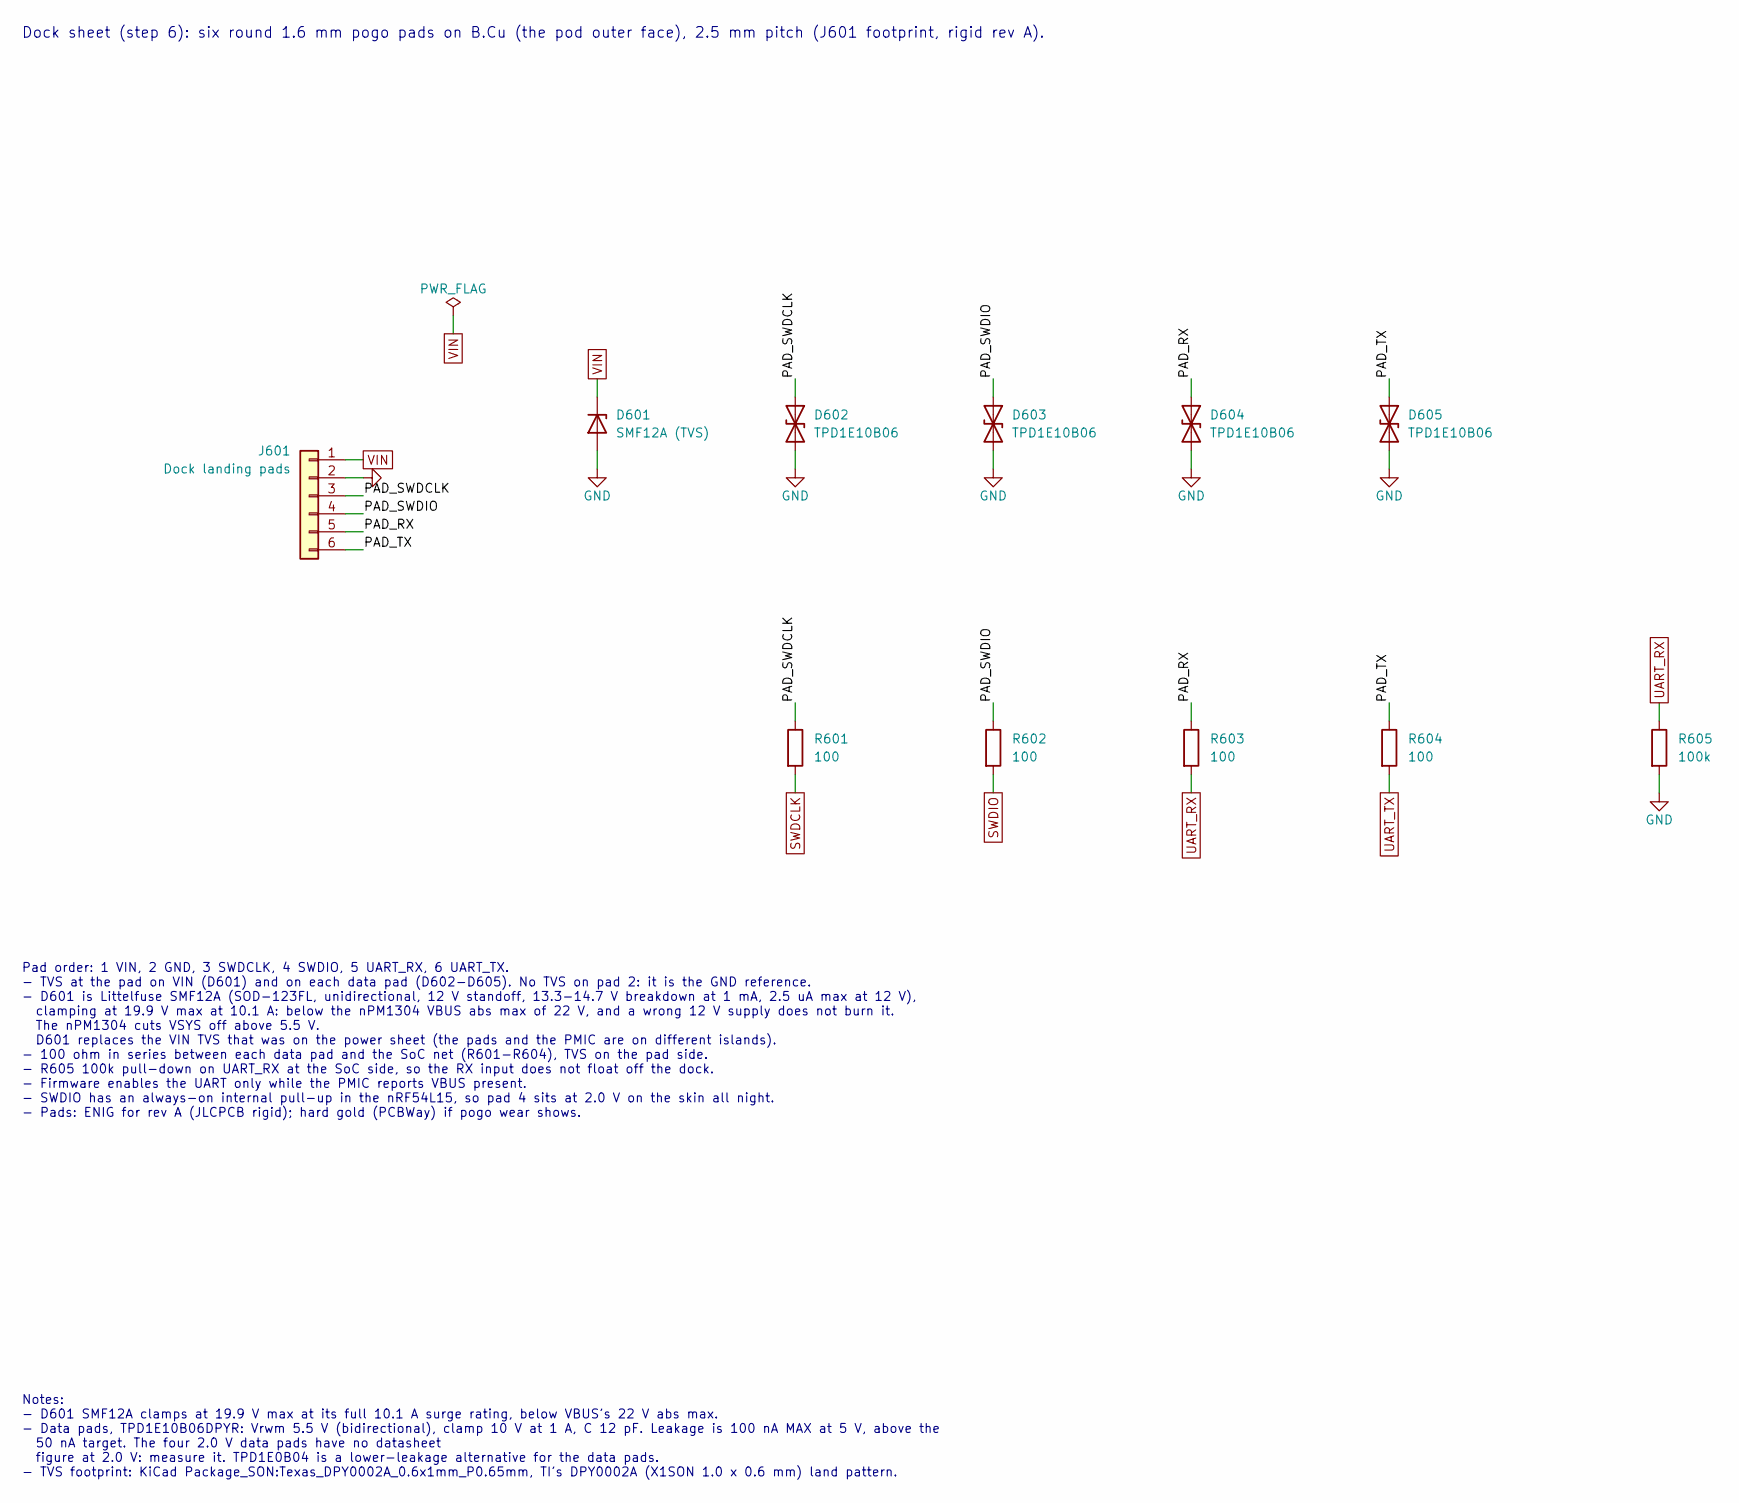
[picture p68: schematic dock.kicad_sch, WakeBand rigid rev A - Dock]

Parts:
D601: SMF12A (TVS); D_SOD-123F; MPN Littelfuse SMF12A; LCSC C207255
D602, D603, D604, D605: TPD1E10B06; Texas_DPY0002A_0.6x1mm_P0.65mm; MPN TI TPD1E10B06DPYR; LCSC C48260
J601: Dock landing pads; DockLanding_4xB_D1.6mm_2xUART
R601, R602, R603, R604: 100; R_0402_1005Metric; LCSC C25076
R605: 100k; R_0402_1005Metric; LCSC C25741

Connections:
/dock/PAD_RX: D604.1 (A1), J601.5, R603.1
/dock/PAD_SWDCLK: D602.1 (A1), J601.3, R601.1
/dock/PAD_SWDIO: D603.1 (A1), J601.4, R602.1
/dock/PAD_TX: D605.1 (A1), J601.6, R604.1
GND: D601.2 (A), D602.2 (A2), D603.2 (A2), D604.2 (A2), D605.2 (A2), J601.2, R605.2; also elsewhere on the board
SWDCLK: R601.2; also elsewhere on the board
SWDIO: R602.2; also elsewhere on the board
UART_RX: R603.2, R605.1; also elsewhere on the board
UART_TX: R604.2; also elsewhere on the board
VIN: D601.1 (K), J601.1; also elsewhere on the board

Notes on the sheet:
Pad order: 1 VIN, 2 GND, 3 SWDCLK, 4 SWDIO, 5 UART_RX, 6 UART_TX. - TVS at the pad on VIN (D601) and on each data pad (D602-D605). No TVS on pad 2: it is the GND reference. - D601 is Littelfuse SMF12A (SOD-123FL, unidirectional, 12 V standoff, 13.3-14.7 V breakdown at 1 mA, 2.5 uA max at 12 V), cla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
Dock sheet (step 6): six round 1.6 mm pogo pads on B.Cu (the pod outer face), 2.5 mm pitch (J601 footprint, rigid rev A).
Notes: - D601 SMF12A clamps at 19.9 V max at its full 10.1 A surge rating, below VBUS's 22 V abs max. - Data pads, TPD1E10B06DPYR: Vrwm 5.5 V (bidirectional), clamp 10 V at 1 A, C 12 pF. Leakage is 100 nA MAX at 5 V, above the 50 nA target. The four 2.0 V data pads have no datasheet figure at 2.0 V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

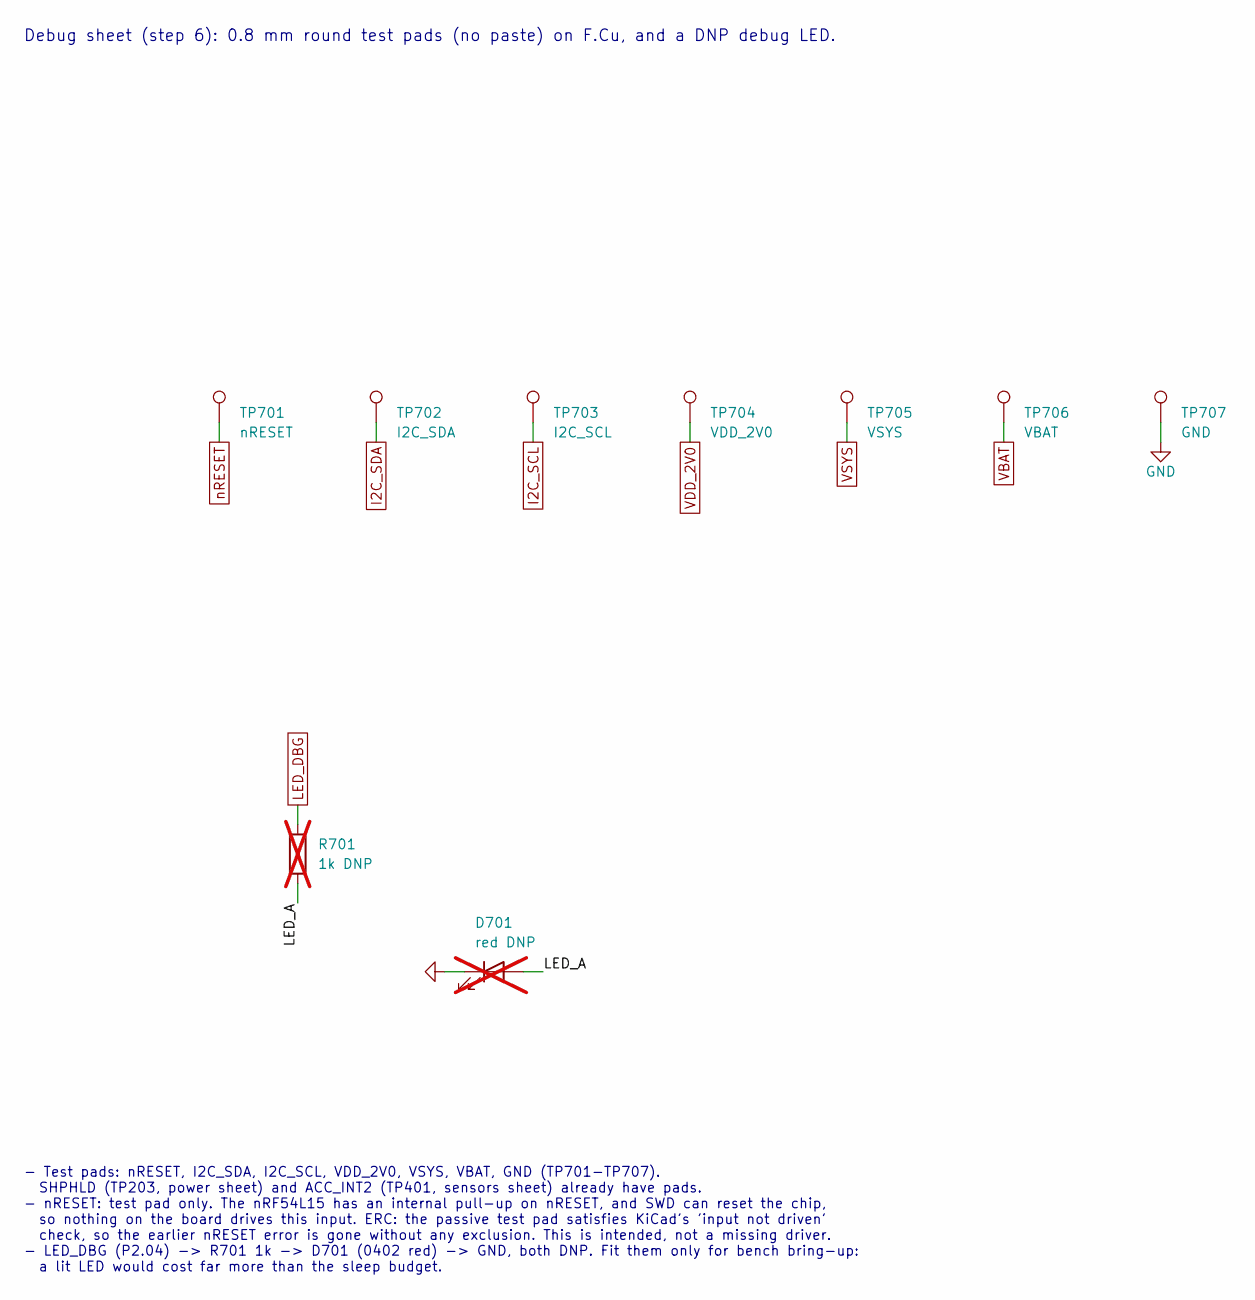
[picture p69: schematic debug.kicad_sch, WakeBand rigid rev A - Debug]

Parts:
D701: red DNP; LED_0402_1005Metric; MPN XINGLIGHT XL-1005SURC; LCSC C25503345; not fitted
R701: 1k DNP; R_0402_1005Metric; LCSC C11702; not fitted
TP701: nRESET; TestPoint_Pad_D0.8mm
TP702: I2C_SDA; TestPoint_Pad_D0.8mm
TP703: I2C_SCL; TestPoint_Pad_D0.8mm
TP704: VDD_2V0; TestPoint_Pad_D0.8mm
TP705: VSYS; TestPoint_Pad_D0.8mm
TP706: VBAT; TestPoint_Pad_D0.8mm
TP707: GND; TestPoint_Pad_D0.8mm

Connections:
/debug/LED_A: D701.2 (A), R701.2
GND: D701.1 (K), TP707.1; also elsewhere on the board
I2C_SCL: TP703.1; also elsewhere on the board
I2C_SDA: TP702.1; also elsewhere on the board
LED_DBG: R701.1; also elsewhere on the board
VBAT: TP706.1; also elsewhere on the board
VDD_2V0: TP704.1; also elsewhere on the board
VSYS: TP705.1; also elsewhere on the board
nRESET: TP701.1; also elsewhere on the board

Notes on the sheet:
- Test pads: nRESET, I2C_SDA, I2C_SCL, VDD_2V0, VSYS, VBAT, GND (TP701-TP707). SHPHLD (TP203, power sheet) and ACC_INT2 (TP401, sensors sheet) already have pads. - nRESET: test pad only. The nRF54L15 has an internal pull-up on nRESET, and SWD can reset the chip, so nothing on the board drives this 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
Debug sheet (step 6): 0.8 mm round test pads (no paste) on F.Cu, and a DNP debug LED.

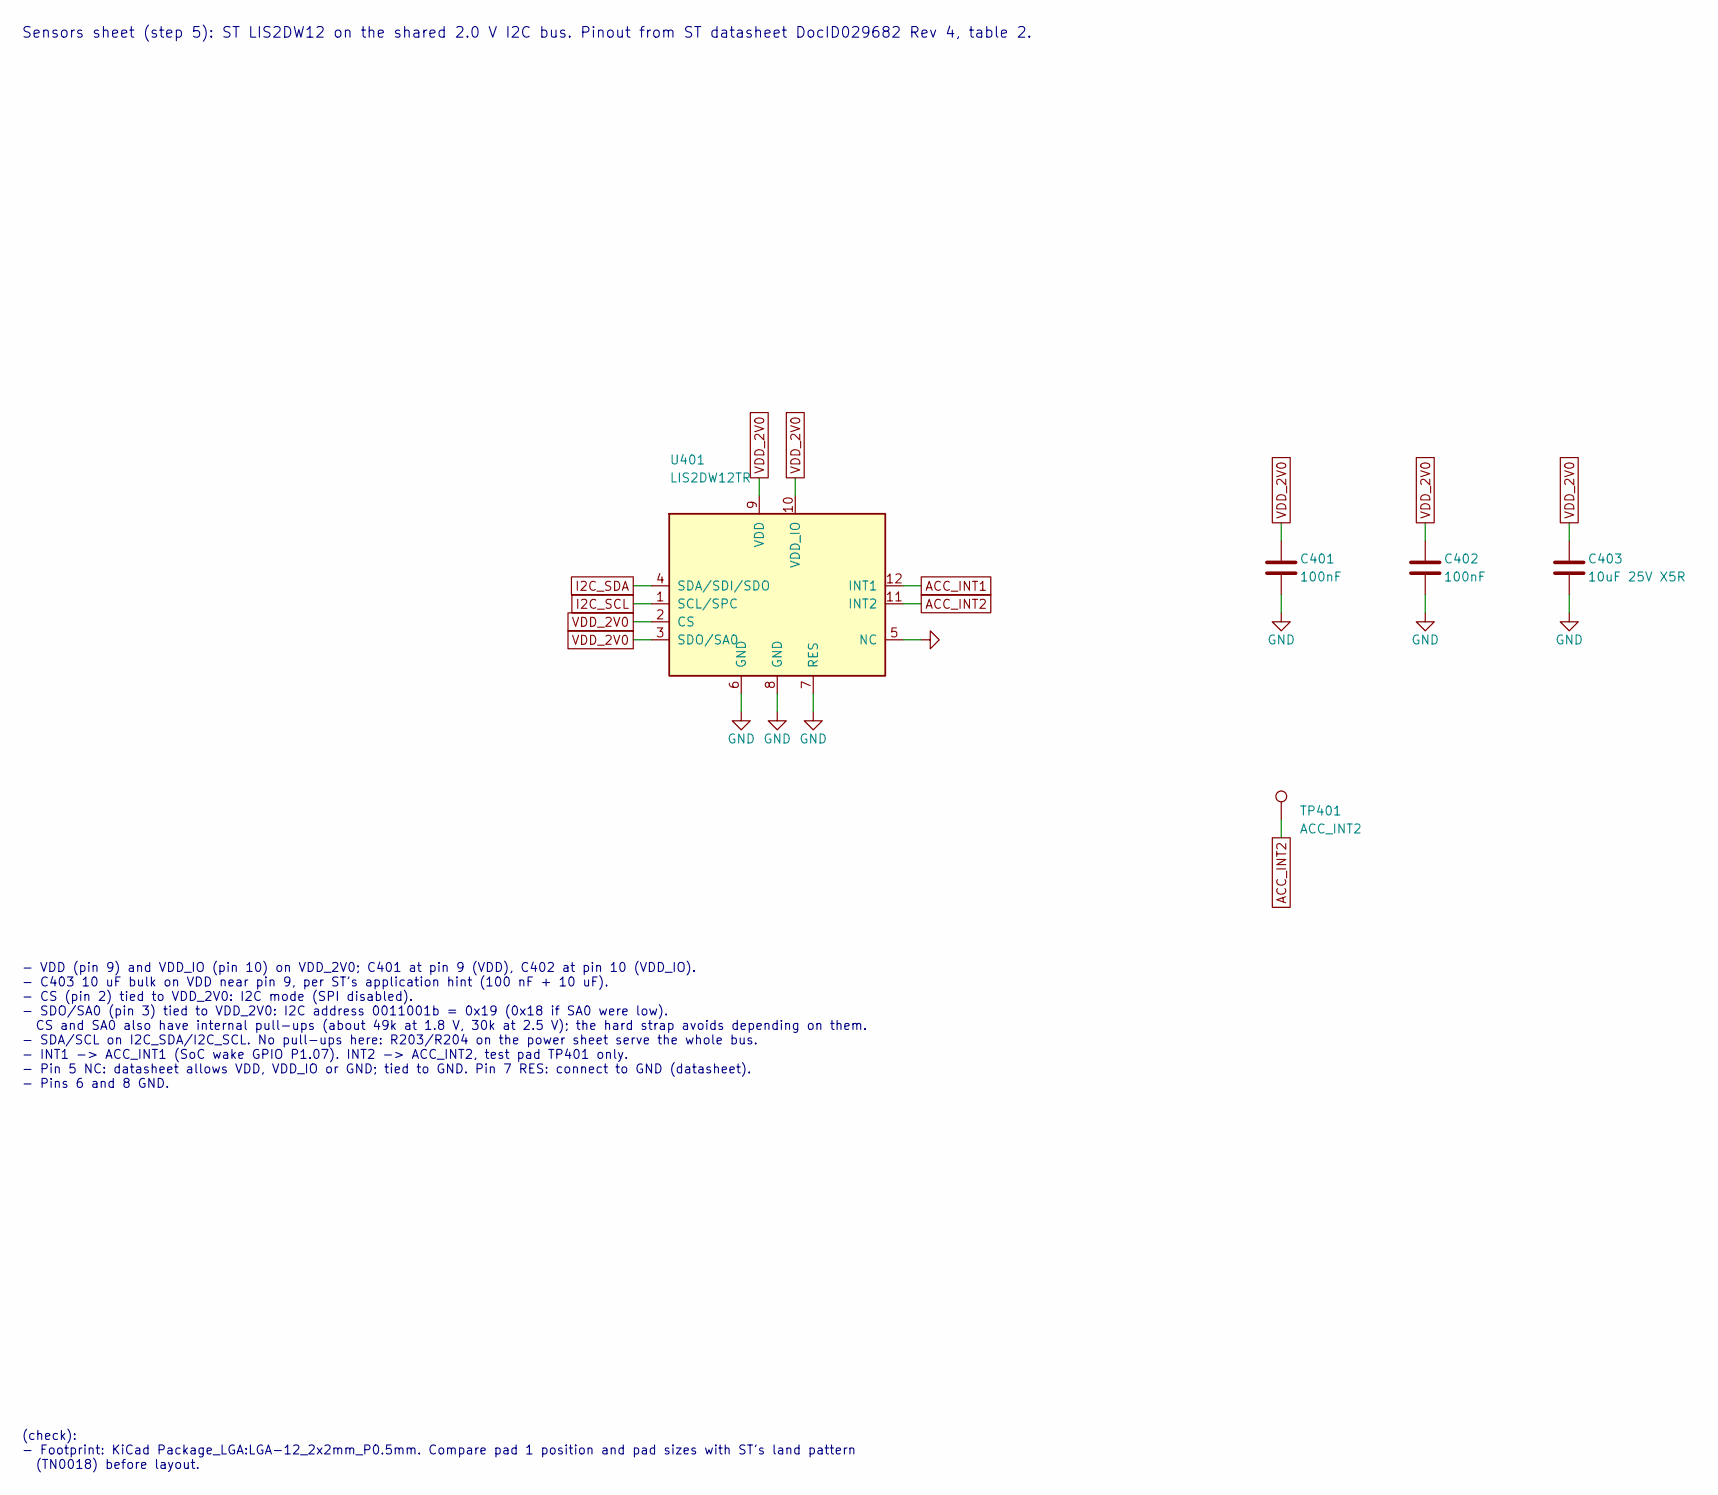
[picture p70: schematic sensors.kicad_sch, WakeBand rigid rev A - Sensors]

Parts:
C401, C402: 100nF; C_0402_1005Metric; LCSC C1525
C403: 10uF 25V X5R; C_0603_1608Metric; LCSC C96446
TP401: ACC_INT2; TestPoint_Pad_D0.8mm
U401: LIS2DW12TR; LGA-12_2x2mm_P0.5mm; LCSC C189624

Connections:
ACC_INT1: U401.12 (INT1); also elsewhere on the board
ACC_INT2: TP401.1, U401.11 (INT2)
GND: C401.2, C402.2, C403.2, U401.5 (NC), U401.6 (GND), U401.7 (RES), U401.8 (GND); also elsewhere on the board
I2C_SCL: U401.1 (SCL/SPC); also elsewhere on the board
I2C_SDA: U401.4 (SDA/SDI/SDO); also elsewhere on the board
VDD_2V0: C401.1, C402.1, C403.1, U401.2 (CS), U401.3 (SDO/SA0), U401.9 (VDD), U401.10 (VDD_IO); also elsewhere on the board

Notes on the sheet:
(check): - Footprint: KiCad Package_LGA:LGA-12_2x2mm_P0.5mm. Compare pad 1 position and pad sizes with ST's land pattern (TN0018) before layout.
Sensors sheet (step 5): ST LIS2DW12 on the shared 2.0 V I2C bus. Pinout from ST datasheet DocID029682 Rev 4, table 2.
- VDD (pin 9) and VDD_IO (pin 10) on VDD_2V0; C401 at pin 9 (VDD), C402 at pin 10 (VDD_IO). - C403 10 uF bulk on VDD near pin 9, per ST's application hint (100 nF + 10 uF). - CS (pin 2) tied to VDD_2V0: I2C mode (SPI disabled). - SDO/SA0 (pin 3) tied to VDD_2V0: I2C address 0011001b = 0x19 (0x18 if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

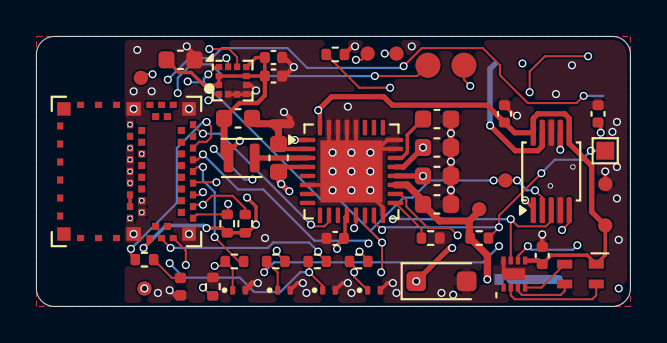
[picture p71: board rigid-rev-a.kicad_pcb from above]

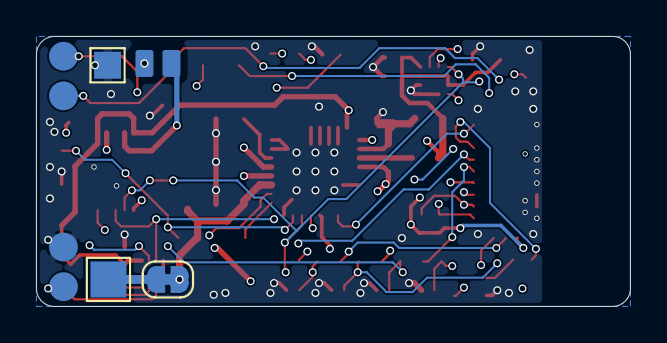
[picture p72: board rigid-rev-a.kicad_pcb from below]

Board: 4 copper layers, 33.0 x 15.0 mm, 53 parts (5 on the bottom side), 36 nets.
