DevonHope/FOSS-Health-Alarm/hardware/band/rev-b/pcb/fab/panel/rigid-rev-b-panel.kicad_pcb

## KiCad design hardware/band/rev-b/pcb/fab/panel/rigid-rev-b-panel.kicad_pcb (2026-11-10, an earlier design)

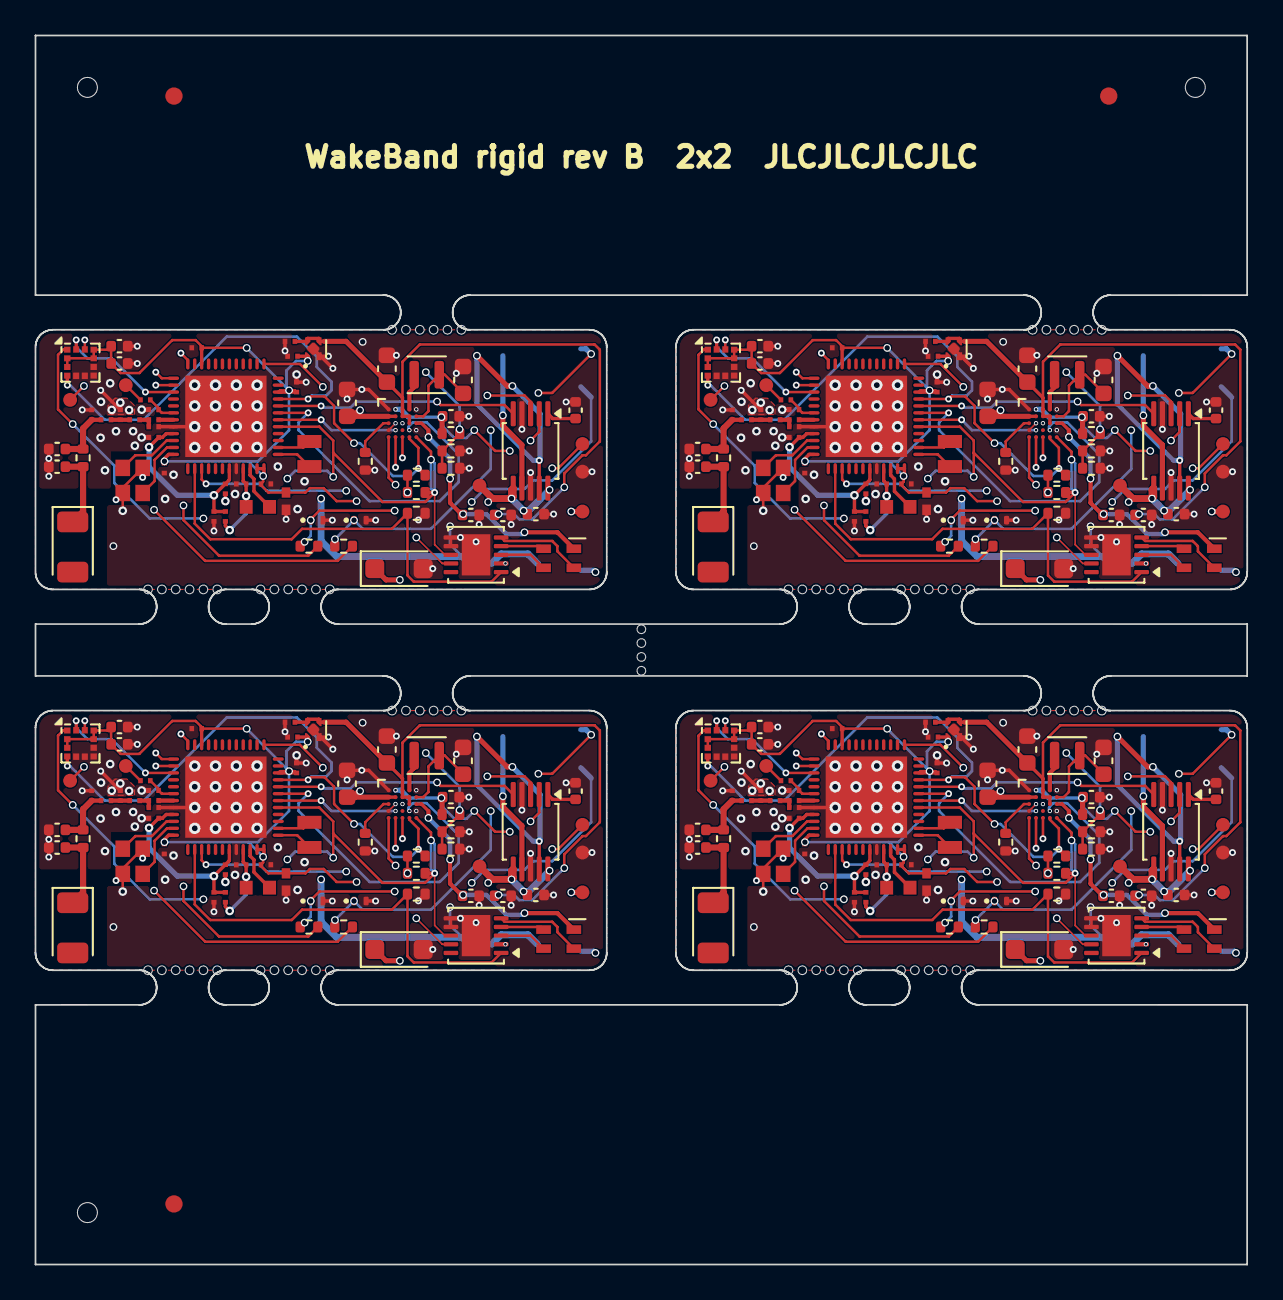
[picture p73: board rigid-rev-b-panel.kicad_pcb from above]

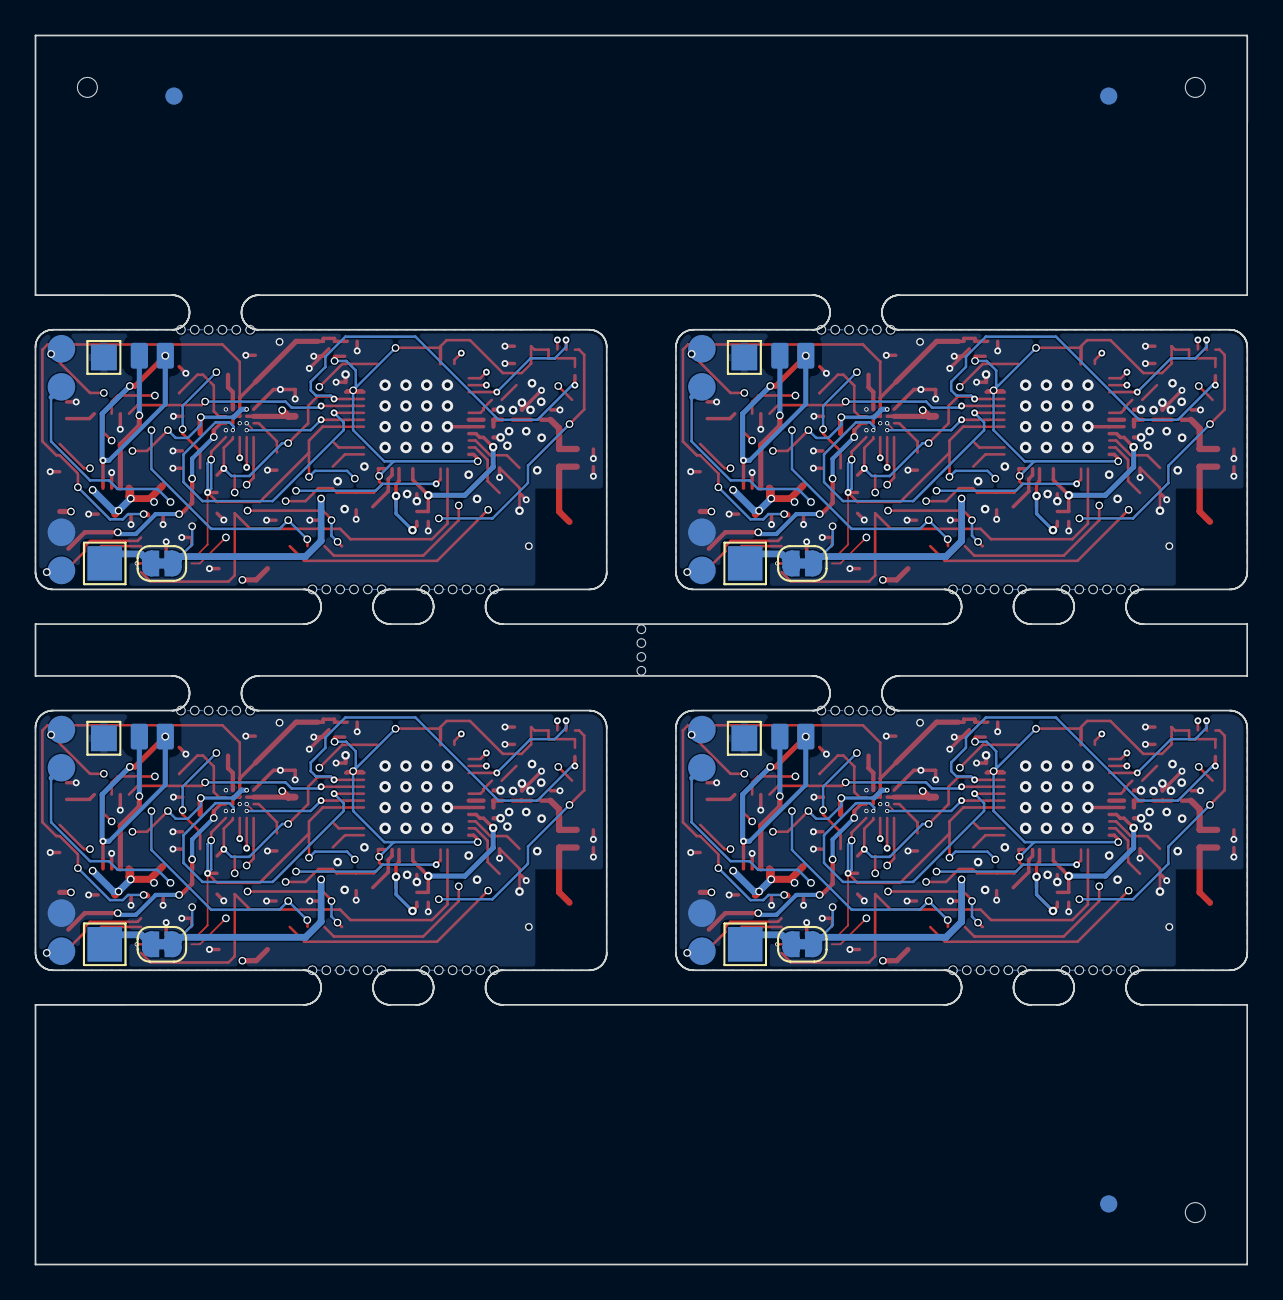
[picture p74: board rigid-rev-b-panel.kicad_pcb from below]

Board: 4 copper layers, 70.0 x 71.0 mm, 361 parts (23 on the bottom side), 184 nets.

Parts:
AE1_0, AE1_1, AE1_2, AE1_3: 2450AT18A0100001E; Johanson_2450AT18x100
C1_0, C1_1, C1_2, C1_3, C2_0, C2_1, C2_2, C2_3: 2.2uF; Nordic_CAPC0603X03L_C
C3_0, C3_1, C3_2, C3_3: 10uF; Nordic_CAPC1005X04L
C4_0, C4_1, C4_2, C4_3, C7_0, C7_1, C7_2, C7_3, C8_0, C8_1, C8_2, C8_3, C10_0, C10_1, C10_2, C10_3: 100nF; Nordic_CAPC0603X03L_C
C5_0, C5_1, C5_2, C5_3: 2.2nF; Nordic_CAPC0603X03L_C
C6_0, C6_1, C6_2, C6_3: 1.5pF; Nordic_CAPC0603X03L_C
C9_0, C9_1, C9_2, C9_3: 2.0pF; Nordic_CAPC0603X03L_C
C11_0, C11_1, C11_2, C11_3: 0.3pF; Nordic_CAPC0603X03L_C
C12_0, C12_1, C12_2, C12_3: 10nF; Nordic_CAPC0603X03L_C
C13_0, C13_1, C13_2, C13_3: 3.9pF; Nordic_CAPC0603X03L_C
C14_0, C14_1, C14_2, C14_3, C15_0, C15_1, C15_2, C15_3: DNP; C_0402_1005Metric
C201_0, C201_1, C201_2, C201_3, C208_0, C208_1, C208_2, C208_3, C501_0, C501_1, C501_2, C501_3, C502_0, C502_1, C502_2, C502_3: 1uF; C_0402_1005Metric
C202_0, C202_1, C202_2, C202_3: 2.2uF; C_0603_1608Metric
C205_0, C205_1, C205_2, C205_3, C206_0, C206_1, C206_2, C206_3: 10uF; C_0603_1608Metric
C209_0, C209_1, C209_2, C209_3, C401_0, C401_1, C401_2, C401_3, C402_0, C402_1, C402_2, C402_3: 100nF; C_0402_1005Metric
C210_0, C210_1, C210_2, C210_3, C211_0, C211_1, C211_2, C211_3: 1uF; Nordic_CAPC0603X03L_C
D601_0, D601_1, D601_2, D601_3: SMF12A; D_SOD-123F
D602_0, D602_1, D602_2, D602_3, D603_0, D603_1, D603_2, D603_3: TPD1E10B06; Texas_DPY0002A_0.6x1mm_P0.65mm
D702_0, D702_1, D702_2, D702_3: TJ-S1615SW6TGLCCYRGB-A5; LED_TOGIALED_1615_RGB_CommonAnode
FB1_0, FB1_1, FB1_2, FB1_3: 120R@100MHz; Nordic_INDC0603X03L_C
J601_0, J601_1, J601_2, J601_3: Dock landing pads; DockLanding_4xB_D1.6mm
JP201_0, JP201_1, JP201_2, JP201_3: I_BAT; SolderJumper-2_P1.3mm_Bridged_RoundedPad1.0x1.5mm
KiKit_FID_B_1, KiKit_FID_B_2, KiKit_FID_B_3: Fiducial
KiKit_FID_T_1, KiKit_FID_T_2, KiKit_FID_T_3: Fiducial
KiKit_MB_1_1, KiKit_MB_1_2, KiKit_MB_1_3, KiKit_MB_1_4, KiKit_MB_1_5, KiKit_MB_1_6, KiKit_MB_2_1, KiKit_MB_2_2, KiKit_MB_2_3, KiKit_MB_2_4, KiKit_MB_2_5, KiKit_MB_2_6, KiKit_MB_3_1, KiKit_MB_3_2, KiKit_MB_3_3, KiKit_MB_3_4, KiKit_MB_3_5, KiKit_MB_3_6, KiKit_MB_4_1, KiKit_MB_4_2, KiKit_MB_4_3, KiKit_MB_4_4, KiKit_MB_4_5, KiKit_MB_4_6, KiKit_MB_5_1, KiKit_MB_5_2, KiKit_MB_5_3, KiKit_MB_5_4, KiKit_MB_5_5, KiKit_MB_5_6, KiKit_MB_6_1, KiKit_MB_6_2, KiKit_MB_6_3, KiKit_MB_6_4, KiKit_MB_6_5, KiKit_MB_6_6, KiKit_MB_7_1, KiKit_MB_7_2, KiKit_MB_7_3, KiKit_MB_7_4, KiKit_MB_7_5, KiKit_MB_7_6, KiKit_MB_8_1, KiKit_MB_8_2, KiKit_MB_8_3, KiKit_MB_8_4, KiKit_MB_8_5, KiKit_MB_8_6, KiKit_MB_9_1, KiKit_MB_9_2, KiKit_MB_9_3, KiKit_MB_9_4, KiKit_MB_9_5, KiKit_MB_9_6, KiKit_MB_10_1, KiKit_MB_10_2, KiKit_MB_10_3, KiKit_MB_10_4, KiKit_MB_10_5, KiKit_MB_10_6, KiKit_MB_11_1, KiKit_MB_11_2, KiKit_MB_11_3, KiKit_MB_11_4, KiKit_MB_11_5, KiKit_MB_11_6, KiKit_MB_12_1, KiKit_MB_12_2, KiKit_MB_12_3, KiKit_MB_12_4, KiKit_MB_12_5, KiKit_MB_12_6, KiKit_MB_13_2, KiKit_MB_13_3, KiKit_MB_13_4, KiKit_MB_13_5: NPTH
KiKit_TO_1, KiKit_TO_2, KiKit_TO_3: NPTH
L1_0, L1_1, L1_2, L1_3: 4.7uH; Nordic_INDC1608X06L
L2_0, L2_1, L2_2, L2_3: 2.7nH; Nordic_INDC0603X03L_C
L3_0, L3_1, L3_2, L3_3, L4_0, L4_1, L4_2, L4_3: 3.5nH; Nordic_INDC0603X03L_C
L201_0, L201_1, L201_2, L201_3: 2.2uH; L_Murata_DFE201610P
R1_0, R1_1, R1_2, R1_3: 1k; Nordic_RESC0603X03L_C
R2_0, R2_1, R2_2, R2_3: 0R; R_0402_1005Metric
R202_0, R202_1, R202_2, R202_3: 6.65k; R_0402_1005Metric
R203_0, R203_1, R203_2, R203_3, R204_0, R204_1, R204_2, R204_3: 4.7k; R_0402_1005Metric
R207_0, R207_1, R207_2, R207_3: 14k; R_0402_1005Metric
R208_0, R208_1, R208_2, R208_3: 14.3k; R_0402_1005Metric
R211_0, R211_1, R211_2, R211_3: 100k; R_0402_1005Metric
R601_0, R601_1, R601_2, R601_3, R602_0, R602_1, R602_2, R602_3: 100; R_0402_1005Metric
TH201_0, TH201_1, TH201_2, TH201_3: 10k B3380; R_0402_1005Metric
TP201_0, TP201_1, TP201_2, TP201_3: BAT+ pad; TestPoint_Pad_2.0x2.0mm
TP202_0, TP202_1, TP202_2, TP202_3: BAT- pad; TestPoint_Pad_1.5x1.5mm
TP203_0, TP203_1, TP203_2, TP203_3: MR; TestPoint_Pad_D0.8mm
TP401_0, TP401_1, TP401_2, TP401_3: ACC_INT2; TestPoint_Pad_D0.8mm
TP501_0, TP501_1, TP501_2, TP501_3: LRA+; Pad_SMD_1.0x1.5mm
TP502_0, TP502_1, TP502_2, TP502_3: LRA-; Pad_SMD_1.0x1.5mm
TP701_0, TP701_1, TP701_2, TP701_3: nRESET; TestPoint_Pad_D0.8mm
TP705_0, TP705_1, TP705_2, TP705_3: PMID; TestPoint_Pad_D0.8mm
TP706_0, TP706_1, TP706_2, TP706_3: VBAT; TestPoint_Pad_D0.8mm
TP707_0, TP707_1, TP707_2, TP707_3: GND; TestPoint_Pad_D0.8mm
U1_0, U1_1, U1_2, U1_3: nRF54L10-QFAA; Nordic_QFN40P600X600X90-48N
U201_0, U201_1, U201_2, U201_3: BQ25125; TI_DSBGA-25_2.5x2.5mm_Layout5x5_P0.4mm
U202_0, U202_1, U202_2, U202_3: IS31FL3193; DFN-10-1EP_3x3mm_P0.5mm_EP1.65x2.38mm
U203_0, U203_1, U203_2, U203_3: TPS7A0220; Texas_X2SON-4_1x1mm_P0.65mm_SilkTrim
U401_0, U401_1, U401_2, U401_3: LIS2DW12TR; LGA-12_2x2mm_P0.5mm
U501_0, U501_1, U501_2, U501_3: DRV2605LDGSR; TSSOP-10_3x3mm_P0.5mm
X1_0, X1_1, X1_2, X1_3: 32.768kHz 9pF; Nordic_XTAL_2012
X2_0, X2_1, X2_2, X2_3: 32MHz 8pF; Nordic_BT-XTAL_2016

Connections:
Board_0-/ACC_INT1: U1_0.27, U401_0.12
Board_0-/ACC_INT2: TP401_0.1, U1_0.24, U401_0.11
Board_0-/ANT: L2_0.1, U1_0.31
Board_0-/ANT_FEED: AE1_0.1, C15_0.1, R2_0.2
Board_0-/BATT_P: JP201_0.1, TP201_0.1
Board_0-/CHG_CD: U1_0.39, U201_0.E2
Board_0-/CHG_MR: TP203_0.1, U201_0.E1
Board_0-/DCC: L1_0.1, U1_0.46
Board_0-/DECA: C2_0.2, C5_0.2, C12_0.2, FB1_0.2, U1_0.33, U1_0.43
Board_0-/DECD: C1_0.2, FB1_0.1, L1_0.2, U1_0.45
Board_0-/DOCK_PG: U1_0.7, U201_0.D4
Board_0-/GND: C1_0.1, C2_0.1, C3_0.1, C4_0.2, C5_0.1, C6_0.1, C7_0.2, C8_0.2, C9_0.1, C10_0.2, C11_0.1, C12_0.1, C13_0.1, C14_0.2, C15_0.2, C201_0.2, C202_0.2, C205_0.2, C206_0.2, C208_0.2, C209_0.2, C210_0.2, C211_0.2, C401_0.2, C402_0.2, C501_0.2, C502_0.2, D601_0.2, D602_0.2, D603_0.2, J601_0.2, R202_0.2, R208_0.2, R211_0.2, TH201_0.2, TP202_0.1, TP707_0.1, U1_0.32, U1_0.44, U1_0.49, U201_0.A1, U201_0.A5, U201_0.C2, U201_0.D1, U201_0.D5, U202_0.6, U202_0.7, U202_0.11, U203_0.2, U203_0.5, U401_0.5, U401_0.6, U401_0.7, U401_0.8, U501_0.4, U501_0.8, X2_0.2, X2_0.4
Board_0-/HAPT_EN: U1_0.8, U501_0.5
Board_0-/I2C_SCL: R204_0.2, U1_0.5, U201_0.E5, U202_0.8, U401_0.1, U501_0.2
Board_0-/I2C_SDA: R203_0.2, U1_0.9, U201_0.E4, U202_0.9, U401_0.4, U501_0.3
Board_0-/ISET: R202_0.1, U201_0.C1
Board_0-/LED_B: D702_0.2, U202_0.4
Board_0-/LED_EN: R211_0.1, U1_0.38, U202_0.1
Board_0-/LED_G: D702_0.3, U202_0.3
Board_0-/LED_R: D702_0.4, U202_0.5
Board_0-/LRA_N: TP502_0.1, U501_0.9
Board_0-/LRA_P: TP501_0.1, U501_0.7
Board_0-/LS_CTRL: U1_0.13, U201_0.E3
Board_0-/PAD_SWDCLK: D602_0.1, J601_0.3, R601_0.1
Board_0-/PAD_SWDIO: D603_0.1, J601_0.4, R602_0.1
Board_0-/PMIC_INT: U1_0.6, U201_0.D2
Board_0-/PMID: C206_0.1, C209_0.1, C210_0.1, TP705_0.1, U201_0.A3, U201_0.B3, U201_0.B4, U201_0.C4, U202_0.2, U203_0.3, U203_0.4
Board_0-/REG: C502_0.1, U501_0.1
Board_0-/RF1: C6_0.2, L2_0.2, L3_0.1
Board_0-/RF2: C9_0.2, L3_0.2, L4_0.1
Board_0-/RF_50: C11_0.2, C14_0.1, L4_0.2, R2_0.1
Board_0-/SW: L201_0.1, U201_0.A4
Board_0-/SWDCLK: R601_0.2, U1_0.26
Board_0-/SWDIO: R602_0.2, U1_0.25
Board_0-/TS: R207_0.2, R208_0.1, TH201_0.1, U201_0.C3
Board_0-/VBAT: C202_0.1, C501_0.1, JP201_0.2, TP706_0.1, U201_0.B1, U201_0.B2, U501_0.6, U501_0.10
Board_0-/VDD_2V0: C3_0.2, C4_0.1, C7_0.1, C8_0.1, C10_0.1, C211_0.1, C401_0.1, C402_0.1, R203_0.1, R204_0.1, U1_0.10, U1_0.22, U1_0.36, U1_0.47, U1_0.48, U203_0.1, U401_0.2, U401_0.3, U401_0.9, U401_0.10
Board_0-/VIN: C201_0.1, D601_0.1, J601_0.1, R207_0.1, U201_0.A2
Board_0-/VLED: C208_0.1, D702_0.1, U201_0.C5
Board_0-/VSYS: C205_0.1, L201_0.2, U201_0.B5
Board_0-/XC1: U1_0.34, X2_0.1
Board_0-/XC2: U1_0.35, X2_0.3
Board_0-/XL1: U1_0.1, X1_0.2
Board_0-/XL2: U1_0.2, X1_0.1
Board_0-/nRESET: R1_0.2, TP701_0.1
Board_0-/nRESET_IC: C13_0.2, R1_0.1, U1_0.30
Board_1-/ACC_INT1: U1_1.27, U401_1.12
Board_1-/ACC_INT2: TP401_1.1, U1_1.24, U401_1.11
Board_1-/ANT: L2_1.1, U1_1.31
Board_1-/ANT_FEED: AE1_1.1, C15_1.1, R2_1.2
Board_1-/BATT_P: JP201_1.1, TP201_1.1
Board_1-/CHG_CD: U1_1.39, U201_1.E2
Board_1-/CHG_MR: TP203_1.1, U201_1.E1
Board_1-/DCC: L1_1.1, U1_1.46
Board_1-/DECA: C2_1.2, C5_1.2, C12_1.2, FB1_1.2, U1_1.33, U1_1.43
Board_1-/DECD: C1_1.2, FB1_1.1, L1_1.2, U1_1.45
Board_1-/DOCK_PG: U1_1.7, U201_1.D4
Board_1-/GND: C1_1.1, C2_1.1, C3_1.1, C4_1.2, C5_1.1, C6_1.1, C7_1.2, C8_1.2, C9_1.1, C10_1.2, C11_1.1, C12_1.1, C13_1.1, C14_1.2, C15_1.2, C201_1.2, C202_1.2, C205_1.2, C206_1.2, C208_1.2, C209_1.2, C210_1.2, C211_1.2, C401_1.2, C402_1.2, C501_1.2, C502_1.2, D601_1.2, D602_1.2, D603_1.2, J601_1.2, R202_1.2, R208_1.2, R211_1.2, TH201_1.2, TP202_1.1, TP707_1.1, U1_1.32, U1_1.44, U1_1.49, U201_1.A1, U201_1.A5, U201_1.C2, U201_1.D1, U201_1.D5, U202_1.6, U202_1.7, U202_1.11, U203_1.2, U203_1.5, U401_1.5, U401_1.6, U401_1.7, U401_1.8, U501_1.4, U501_1.8, X2_1.2, X2_1.4
Board_1-/HAPT_EN: U1_1.8, U501_1.5
Board_1-/I2C_SCL: R204_1.2, U1_1.5, U201_1.E5, U202_1.8, U401_1.1, U501_1.2
Board_1-/I2C_SDA: R203_1.2, U1_1.9, U201_1.E4, U202_1.9, U401_1.4, U501_1.3
Board_1-/ISET: R202_1.1, U201_1.C1
Board_1-/LED_B: D702_1.2, U202_1.4
Board_1-/LED_EN: R211_1.1, U1_1.38, U202_1.1
Board_1-/LED_G: D702_1.3, U202_1.3
Board_1-/LED_R: D702_1.4, U202_1.5
Board_1-/LRA_N: TP502_1.1, U501_1.9
Board_1-/LRA_P: TP501_1.1, U501_1.7
Board_1-/LS_CTRL: U1_1.13, U201_1.E3
Board_1-/PAD_SWDCLK: D602_1.1, J601_1.3, R601_1.1
Board_1-/PAD_SWDIO: D603_1.1, J601_1.4, R602_1.1
Board_1-/PMIC_INT: U1_1.6, U201_1.D2
Board_1-/PMID: C206_1.1, C209_1.1, C210_1.1, TP705_1.1, U201_1.A3, U201_1.B3, U201_1.B4, U201_1.C4, U202_1.2, U203_1.3, U203_1.4
Board_1-/REG: C502_1.1, U501_1.1
Board_1-/RF1: C6_1.2, L2_1.2, L3_1.1
Board_1-/RF2: C9_1.2, L3_1.2, L4_1.1
Board_1-/RF_50: C11_1.2, C14_1.1, L4_1.2, R2_1.1
Board_1-/SW: L201_1.1, U201_1.A4
Board_1-/SWDCLK: R601_1.2, U1_1.26
Board_1-/SWDIO: R602_1.2, U1_1.25
Board_1-/TS: R207_1.2, R208_1.1, TH201_1.1, U201_1.C3
Board_1-/VBAT: C202_1.1, C501_1.1, JP201_1.2, TP706_1.1, U201_1.B1, U201_1.B2, U501_1.6, U501_1.10
Board_1-/VDD_2V0: C3_1.2, C4_1.1, C7_1.1, C8_1.1, C10_1.1, C211_1.1, C401_1.1, C402_1.1, R203_1.1, R204_1.1, U1_1.10, U1_1.22, U1_1.36, U1_1.47, U1_1.48, U203_1.1, U401_1.2, U401_1.3, U401_1.9, U401_1.10
Board_1-/VIN: C201_1.1, D601_1.1, J601_1.1, R207_1.1, U201_1.A2
Board_1-/VLED: C208_1.1, D702_1.1, U201_1.C5
Board_1-/VSYS: C205_1.1, L201_1.2, U201_1.B5
Board_1-/XC1: U1_1.34, X2_1.1
Board_1-/XC2: U1_1.35, X2_1.3
Board_1-/XL1: U1_1.1, X1_1.2
Board_1-/XL2: U1_1.2, X1_1.1
Board_1-/nRESET: R1_1.2, TP701_1.1
Board_1-/nRESET_IC: C13_1.2, R1_1.1, U1_1.30
Board_2-/ACC_INT1: U1_2.27, U401_2.12
Board_2-/ACC_INT2: TP401_2.1, U1_2.24, U401_2.11
Board_2-/ANT: L2_2.1, U1_2.31
Board_2-/ANT_FEED: AE1_2.1, C15_2.1, R2_2.2
Board_2-/BATT_P: JP201_2.1, TP201_2.1
Board_2-/CHG_CD: U1_2.39, U201_2.E2
Board_2-/CHG_MR: TP203_2.1, U201_2.E1
Board_2-/DCC: L1_2.1, U1_2.46
Board_2-/DECA: C2_2.2, C5_2.2, C12_2.2, FB1_2.2, U1_2.33, U1_2.43
Board_2-/DECD: C1_2.2, FB1_2.1, L1_2.2, U1_2.45
Board_2-/DOCK_PG: U1_2.7, U201_2.D4
Board_2-/GND: C1_2.1, C2_2.1, C3_2.1, C4_2.2, C5_2.1, C6_2.1, C7_2.2, C8_2.2, C9_2.1, C10_2.2, C11_2.1, C12_2.1, C13_2.1, C14_2.2, C15_2.2, C201_2.2, C202_2.2, C205_2.2, C206_2.2, C208_2.2, C209_2.2, C210_2.2, C211_2.2, C401_2.2, C402_2.2, C501_2.2, C502_2.2, D601_2.2, D602_2.2, D603_2.2, J601_2.2, R202_2.2, R208_2.2, R211_2.2, TH201_2.2, TP202_2.1, TP707_2.1, U1_2.32, U1_2.44, U1_2.49, U201_2.A1, U201_2.A5, U201_2.C2, U201_2.D1, U201_2.D5, U202_2.6, U202_2.7, U202_2.11, U203_2.2, U203_2.5, U401_2.5, U401_2.6, U401_2.7, U401_2.8, U501_2.4, U501_2.8, X2_2.2, X2_2.4
Board_2-/HAPT_EN: U1_2.8, U501_2.5
Board_2-/I2C_SCL: R204_2.2, U1_2.5, U201_2.E5, U202_2.8, U401_2.1, U501_2.2
Board_2-/I2C_SDA: R203_2.2, U1_2.9, U201_2.E4, U202_2.9, U401_2.4, U501_2.3
Board_2-/ISET: R202_2.1, U201_2.C1
Board_2-/LED_B: D702_2.2, U202_2.4
Board_2-/LED_EN: R211_2.1, U1_2.38, U202_2.1
Board_2-/LED_G: D702_2.3, U202_2.3
Board_2-/LED_R: D702_2.4, U202_2.5
Board_2-/LRA_N: TP502_2.1, U501_2.9
Board_2-/LRA_P: TP501_2.1, U501_2.7
Board_2-/LS_CTRL: U1_2.13, U201_2.E3
Board_2-/PAD_SWDCLK: D602_2.1, J601_2.3, R601_2.1
Board_2-/PAD_SWDIO: D603_2.1, J601_2.4, R602_2.1
Board_2-/PMIC_INT: U1_2.6, U201_2.D2
Board_2-/PMID: C206_2.1, C209_2.1, C210_2.1, TP705_2.1, U201_2.A3, U201_2.B3, U201_2.B4, U201_2.C4, U202_2.2, U203_2.3, U203_2.4
Board_2-/REG: C502_2.1, U501_2.1
Board_2-/RF1: C6_2.2, L2_2.2, L3_2.1
Board_2-/RF2: C9_2.2, L3_2.2, L4_2.1
Board_2-/RF_50: C11_2.2, C14_2.1, L4_2.2, R2_2.1
Board_2-/SW: L201_2.1, U201_2.A4
Board_2-/SWDCLK: R601_2.2, U1_2.26
Board_2-/SWDIO: R602_2.2, U1_2.25
Board_2-/TS: R207_2.2, R208_2.1, TH201_2.1, U201_2.C3
Board_2-/VBAT: C202_2.1, C501_2.1, JP201_2.2, TP706_2.1, U201_2.B1, U201_2.B2, U501_2.6, U501_2.10
Board_2-/VDD_2V0: C3_2.2, C4_2.1, C7_2.1, C8_2.1, C10_2.1, C211_2.1, C401_2.1, C402_2.1, R203_2.1, R204_2.1, U1_2.10, U1_2.22, U1_2.36, U1_2.47, U1_2.48, U203_2.1, U401_2.2, U401_2.3, U401_2.9, U401_2.10
Board_2-/VIN: C201_2.1, D601_2.1, J601_2.1, R207_2.1, U201_2.A2
Board_2-/VLED: C208_2.1, D702_2.1, U201_2.C5
Board_2-/VSYS: C205_2.1, L201_2.2, U201_2.B5
Board_2-/XC1: U1_2.34, X2_2.1
Board_2-/XC2: U1_2.35, X2_2.3
Board_2-/XL1: U1_2.1, X1_2.2
Board_2-/XL2: U1_2.2, X1_2.1
Board_2-/nRESET: R1_2.2, TP701_2.1
Board_2-/nRESET_IC: C13_2.2, R1_2.1, U1_2.30
Board_3-/ACC_INT1: U1_3.27, U401_3.12
Board_3-/ACC_INT2: TP401_3.1, U1_3.24, U401_3.11
Board_3-/ANT: L2_3.1, U1_3.31
Board_3-/ANT_FEED: AE1_3.1, C15_3.1, R2_3.2
Board_3-/BATT_P: JP201_3.1, TP201_3.1
Board_3-/CHG_CD: U1_3.39, U201_3.E2
Board_3-/CHG_MR: TP203_3.1, U201_3.E1
Board_3-/DCC: L1_3.1, U1_3.46
Board_3-/DECA: C2_3.2, C5_3.2, C12_3.2, FB1_3.2, U1_3.33, U1_3.43
Board_3-/DECD: C1_3.2, FB1_3.1, L1_3.2, U1_3.45
Board_3-/DOCK_PG: U1_3.7, U201_3.D4
Board_3-/GND: C1_3.1, C2_3.1, C3_3.1, C4_3.2, C5_3.1, C6_3.1, C7_3.2, C8_3.2, C9_3.1, C10_3.2, C11_3.1, C12_3.1, C13_3.1, C14_3.2, C15_3.2, C201_3.2, C202_3.2, C205_3.2, C206_3.2, C208_3.2, C209_3.2, C210_3.2, C211_3.2, C401_3.2, C402_3.2, C501_3.2, C502_3.2, D601_3.2, D602_3.2, D603_3.2, J601_3.2, R202_3.2, R208_3.2, R211_3.2, TH201_3.2, TP202_3.1, TP707_3.1, U1_3.32, U1_3.44, U1_3.49, U201_3.A1, U201_3.A5, U201_3.C2, U201_3.D1, U201_3.D5, U202_3.6, U202_3.7, U202_3.11, U203_3.2, U203_3.5, U401_3.5, U401_3.6, U401_3.7, U401_3.8, U501_3.4, U501_3.8, X2_3.2, X2_3.4
Board_3-/HAPT_EN: U1_3.8, U501_3.5
Board_3-/I2C_SCL: R204_3.2, U1_3.5, U201_3.E5, U202_3.8, U401_3.1, U501_3.2
Board_3-/I2C_SDA: R203_3.2, U1_3.9, U201_3.E4, U202_3.9, U401_3.4, U501_3.3
Board_3-/ISET: R202_3.1, U201_3.C1
Board_3-/LED_B: D702_3.2, U202_3.4
Board_3-/LED_EN: R211_3.1, U1_3.38, U202_3.1
Board_3-/LED_G: D702_3.3, U202_3.3
Board_3-/LED_R: D702_3.4, U202_3.5
Board_3-/LRA_N: TP502_3.1, U501_3.9
Board_3-/LRA_P: TP501_3.1, U501_3.7
Board_3-/LS_CTRL: U1_3.13, U201_3.E3
Board_3-/PAD_SWDCLK: D602_3.1, J601_3.3, R601_3.1
Board_3-/PAD_SWDIO: D603_3.1, J601_3.4, R602_3.1
Board_3-/PMIC_INT: U1_3.6, U201_3.D2
Board_3-/PMID: C206_3.1, C209_3.1, C210_3.1, TP705_3.1, U201_3.A3, U201_3.B3, U201_3.B4, U201_3.C4, U202_3.2, U203_3.3, U203_3.4
Board_3-/REG: C502_3.1, U501_3.1
Board_3-/RF1: C6_3.2, L2_3.2, L3_3.1
Board_3-/RF2: C9_3.2, L3_3.2, L4_3.1
Board_3-/RF_50: C11_3.2, C14_3.1, L4_3.2, R2_3.1
Board_3-/SW: L201_3.1, U201_3.A4
Board_3-/SWDCLK: R601_3.2, U1_3.26
Board_3-/SWDIO: R602_3.2, U1_3.25
Board_3-/TS: R207_3.2, R208_3.1, TH201_3.1, U201_3.C3
Board_3-/VBAT: C202_3.1, C501_3.1, JP201_3.2, TP706_3.1, U201_3.B1, U201_3.B2, U501_3.6, U501_3.10
Board_3-/VDD_2V0: C3_3.2, C4_3.1, C7_3.1, C8_3.1, C10_3.1, C211_3.1, C401_3.1, C402_3.1, R203_3.1, R204_3.1, U1_3.10, U1_3.22, U1_3.36, U1_3.47, U1_3.48, U203_3.1, U401_3.2, U401_3.3, U401_3.9, U401_3.10
Board_3-/VIN: C201_3.1, D601_3.1, J601_3.1, R207_3.1, U201_3.A2
Board_3-/VLED: C208_3.1, D702_3.1, U201_3.C5
Board_3-/VSYS: C205_3.1, L201_3.2, U201_3.B5
Board_3-/XC1: U1_3.34, X2_3.1
Board_3-/XC2: U1_3.35, X2_3.3
Board_3-/XL1: U1_3.1, X1_3.2
Board_3-/XL2: U1_3.2, X1_3.1
Board_3-/nRESET: R1_3.2, TP701_3.1
Board_3-/nRESET_IC: C13_3.2, R1_3.1, U1_3.30
