DevonHope/FOSS-Health-Alarm/hardware/dock/rev-c/pcb/scripts/parts.py

"""WakeBand dock rev B PCB: parts and netlist (single source for schematic and board)."""
# (ref, lib:symbol, value, footprint, LCSC, MPN, {pin: net}, [nc pins], description)
R0402 = "Resistor_SMD:R_0402_1005Metric"
C0402 = "Capacitor_SMD:C_0402_1005Metric"
C0603 = "Capacitor_SMD:C_0603_1608Metric"
SOT6 = "Package_TO_SOT_SMD:SOT-23-6"
def R(ref, val, lcsc, a, b, desc=""): return (ref, "Device:R", val, R0402, lcsc, "", {"1": a, "2": b}, [], desc)
def C(ref, val, lcsc, a, b="GND", fp=C0402, desc=""): return (ref, "Device:C", val, fp, lcsc, "", {"1": a, "2": b}, [], desc)

RP_GPIO_NC = [2, 3, 5, 6, 7, 8, 9, 11, 12, 13, 14, 18, 28, 29, 30, 31, 32, 34, 35, 36, 37, 38, 39, 40, 41]
PARTS = [
    ("U1", "MCU_RaspberryPi:RP2040", "RP2040", "Package_DFN_QFN:QFN-56-1EP_7x7mm_P0.4mm_EP3.2x3.2mm", "C2040", "Raspberry Pi RP2040",
     {**{p: "+3V3" for p in ("1", "10", "22", "33", "42", "49", "43", "44", "48")},
      "4": "LED_USB", "15": "SWCLK_3V3", "16": "SWDIO_3V3", "17": "SWDIO_DRV", "27": "LED_ACT",
      "19": "GND", "20": "XIN", "21": "XOUT", "23": "+1V1", "50": "+1V1", "45": "+1V1",
      "24": "RP_SWCLK", "25": "RP_SWDIO", "26": "RUN", "46": "USB_DM_MCU", "47": "USB_DP_MCU",
      "51": "QSPI_SD3", "52": "QSPI_SCLK", "53": "QSPI_SD0", "54": "QSPI_SD2", "55": "QSPI_SD1", "56": "QSPI_SS",
      "57": "GND"},
     [str(p) for p in RP_GPIO_NC], "CMSIS-DAP SWD probe (Raspberry Pi debugprobe firmware, Debug Probe pin map)"),
    ("U2", "Memory_Flash:W25Q16JVSS", "W25Q16JVSNIQ", "Package_SO:SOIC-8_3.9x4.9mm_P1.27mm", "C2456211", "Winbond W25Q16JVSNIQ",
     {"1": "QSPI_SS", "2": "QSPI_SD1", "3": "QSPI_SD2", "4": "GND", "5": "QSPI_SD0", "6": "QSPI_SCLK", "7": "QSPI_SD3", "8": "+3V3"}, [],
     "2 MB QSPI flash for the RP2040 (debugprobe uses the W25Q080 boot stage)"),
    ("Y1", "Device:Crystal_GND24", "12MHz 12pF", "Crystal:Crystal_SMD_3225-4Pin_3.2x2.5mm", "C2981639", "3225-12-12-10-10/A",
     {"1": "XIN", "3": "XOUT_X", "2": "GND", "4": "GND"}, [], "RP2040 USB clock, 12 MHz"),
    C("C1", "15pF", "C1548", "XIN"), C("C2", "15pF", "C1548", "XOUT_X"),
    R("R1", "1k", "C11702", "XOUT", "XOUT_X", "crystal drive limit (as on the Pico)"),
    ("J1", "Connector:USB_C_Receptacle_USB2.0_16P", "USB-C", "dock:USB_C_Receptacle_HRO_TYPE-C-31-M-12", "C165948", "HRO TYPE-C-31-M-12",
     {"A4": "VBUS", "A9": "VBUS", "B4": "VBUS", "B9": "VBUS", "A1": "GND", "A12": "GND", "B1": "GND", "B12": "GND", "SH": "GND",
      "A5": "CC1", "B5": "CC2", "A6": "USB_DP", "B6": "USB_DP", "A7": "USB_DM", "B7": "USB_DM"}, ["A8", "B8"], "USB 2.0 device, 5 V sink"),
    R("R2", "5.1k", "C25905", "CC1", "GND", "CC1 sink pull-down"), R("R3", "5.1k", "C25905", "CC2", "GND", "CC2 sink pull-down"),
    ("U3", "Power_Protection:USBLC6-2SC6", "USBLC6-2SC6", SOT6, "C7519", "ST USBLC6-2SC6",
     {"1": "USB_DP", "6": "USB_DP", "3": "USB_DM", "4": "USB_DM", "5": "VBUS", "2": "GND"}, [], "USB ESD"),
    R("R4", "27", "C25100", "USB_DP", "USB_DP_MCU"), R("R5", "27", "C25100", "USB_DM", "USB_DM_MCU"),
    ("F1", "Device:Polyfuse", "500mA", "Fuse:Fuse_0805_2012Metric", "C181350", "FSMD050-0805-R", {"1": "VBUS", "2": "VBUS_F"}, [], "USB input fuse"),
    C("C3", "10uF", "C19702", "VBUS_F", fp=C0603),
    ("U4", "Regulator_Linear:XC6206PxxxMR", "XC6206P332MR", "Package_TO_SOT_SMD:SOT-23-3", "C2897477", "Torex XC6206P332MR",
     {"3": "VBUS_F", "2": "+3V3", "1": "GND"}, [], "3.3 V for the RP2040, flash and the 3.3 V side of the translators"),
    C("C4", "1uF", "C52923", "+3V3"),
    ("U5", "Regulator_Linear:XC6206PxxxMR", "XC6206P182MR", "Package_TO_SOT_SMD:SOT-23-3", "C21659", "Torex XC6206P182MR",
     {"3": "+3V3", "2": "+1V8", "1": "GND"}, [], "1.8 V reference for the band side of the SWD translators (the 4 pins carry no VTref)"),
    C("C5", "1uF", "C52923", "+1V8"),
    ("U6", "dock:SY6280AAC", "SY6280AAC", "Package_TO_SOT_SMD:SOT-23-5", "C55136", "Silergy SY6280AAC",
     {"5": "VBUS_F", "4": "VBUS_F", "3": "ISET", "2": "GND", "1": "VIN_BAND"}, [], "current-limited 5 V switch to the band's VIN pin"),
    R("R6", "33k", "C25779", "ISET", "GND", "limit = 6800 / 33k = 0.21 A (+-25 %; SY6280 range 0.13-2 A); the band draws <= 0.1 A"),
    C("C6", "1uF", "C52923", "VBUS_F"), C("C7", "1uF", "C52923", "VIN_BAND"),
    C("C8", "100nF", "C1525", "+3V3"), C("C9", "100nF", "C1525", "+3V3"), C("C10", "100nF", "C1525", "+3V3"),
    C("C11", "100nF", "C1525", "+3V3"), C("C12", "100nF", "C1525", "+3V3"), C("C13", "100nF", "C1525", "+3V3"),
    C("C14", "1uF", "C52923", "+3V3", desc="VREG_VIN"), C("C15", "1uF", "C52923", "+1V1", desc="VREG_VOUT, at pin 45"),
    C("C16", "100nF", "C1525", "+1V1"), C("C17", "100nF", "C1525", "+3V3", desc="flash"),
    C("C22", "100nF", "C1525", "+3V3", desc="ADC_AVDD (pin 43)"),
    C("C23", "100nF", "C160831", "+3V3", fp="Capacitor_SMD:C_0201_0603Metric", desc="USB_VDD / IOVDD (pins 48, 49)"),
    C("C24", "100nF", "C160831", "+1V1", fp="Capacitor_SMD:C_0201_0603Metric", desc="DVDD (pin 50)"),
    R("R7", "10k", "C25744", "+3V3", "RUN"), R("R8", "10k", "C25744", "+3V3", "QSPI_SS"),
    R("R9", "1k", "C11702", "QSPI_SS", "BOOT"),
    ("SW1", "Switch:SW_Push", "BOOTSEL", "Button_Switch_SMD:SW_SPST_TS-1088-xR020", "C720477", "XKB TS-1088-AR02016",
     {"1": "BOOT", "2": "GND"}, [], "hold while plugging in USB to get the UF2 drive"),
    ("U7", "Logic_LevelTranslator:SN74LVC1T45DBV", "74LVC1T45", SOT6, "C168856", "Diodes 74LVC1T45W6-7",
     {"1": "+3V3", "2": "GND", "3": "SWCLK_3V3", "4": "SWCLK_1V8", "5": "+3V3", "6": "+1V8"}, [], "SWCLK 3.3 V to 1.8 V, A to B"),
    ("U8", "Logic_LevelTranslator:TXS0101DBV", "TXS0101", SOT6, "C132604", "TI TXS0101DBVR",
     {"1": "+1V8", "2": "GND", "3": "SWDIO_1V8", "4": "SWDIO_3V3", "5": "+1V8", "6": "+3V3"}, [], "SWDIO, auto-direction (debugprobe has no direction pin)"),
    C("C18", "100nF", "C1525", "+3V3"), C("C19", "100nF", "C1525", "+1V8"), C("C20", "100nF", "C1525", "+3V3"), C("C21", "100nF", "C1525", "+1V8"),
    R("R10", "22", "C25092", "SWDIO_DRV", "SWDIO_3V3", "GPIO14 drives, GPIO13 (SWDI) reads the same node"),
    R("R11", "100", "C25076", "SWCLK_1V8", "P_SWCLK", "limits current into the translator from a 5 V short on the bare pin"),
    R("R12", "100", "C25076", "SWDIO_1V8", "P_SWDIO", "limits current into the translator from a 5 V short on the bare pin"),
    ("R15", "Device:R", "100k", "Resistor_SMD:R_0201_0603Metric", "C106224", "Yageo RC0201FR-07100KL", {"1": "SWCLK_3V3", "2": "GND"}, [],
     "holds the 74LVC1T45 input low when debugprobe releases GPIO12 (0201: the only size that fits beside U7)"),
    ("U9", "Power_Protection:USBLC6-2SC6", "USBLC6-2SC6", SOT6, "C7519", "ST USBLC6-2SC6",
     {"1": "P_SWCLK", "6": "P_SWCLK", "3": "P_SWDIO", "4": "P_SWDIO", "5": "VIN_BAND", "2": "GND"}, [], "ESD clamp on the bare SWCLK/SWDIO spring pins"),
    ("D3", "Device:D_Zener", "SMF6.0A", "Diode_SMD:D_SOD-123F", "C123790", "SMF6.0A", {"1": "VIN_BAND", "2": "GND"}, [], "TVS on the bare VIN spring pin"),
    ("D1", "Device:LED", "red USB", "LED_SMD:LED_0603_1608Metric", "C2286", "KENTO KT-0603R", {"1": "LED_USB_K", "2": "LED_USB"}, [], "USB connected (GPIO2)"),
    R("R13", "1k", "C11702", "LED_USB_K", "GND"),
    ("D2", "Device:LED", "red ACT", "LED_SMD:LED_0603_1608Metric", "C2286", "KENTO KT-0603R", {"1": "LED_ACT_K", "2": "LED_ACT"}, [], "DAP running (GPIO16)"),
    R("R14", "1k", "C11702", "LED_ACT_K", "GND"),
    ("P1", "Connector_Generic:Conn_01x01", "SWCLK", "dock:SpringPin_Mill-Max_0906_PTH_D1.4mm_Drill0.6mm", "", "Mill-Max 0906-4-15-20-75-14-11-0", {"1": "P_SWCLK"}, [], "spring pin to the band's SWDCLK contact"),
    ("P2", "Connector_Generic:Conn_01x01", "SWDIO", "dock:SpringPin_Mill-Max_0906_PTH_D1.4mm_Drill0.6mm", "", "Mill-Max 0906-4-15-20-75-14-11-0", {"1": "P_SWDIO"}, [], "spring pin to SWDIO"),
    ("P3", "Connector_Generic:Conn_01x01", "GND", "dock:SpringPin_Mill-Max_0906_PTH_D1.4mm_Drill0.6mm", "", "Mill-Max 0906-4-15-20-75-14-11-0", {"1": "GND"}, [], "spring pin to GND"),
    ("P4", "Connector_Generic:Conn_01x01", "VIN", "dock:SpringPin_Mill-Max_0906_PTH_D1.4mm_Drill0.6mm", "", "Mill-Max 0906-4-15-20-75-14-11-0", {"1": "VIN_BAND"}, [], "spring pin to VIN (5 V, 0.21 A limit)"),
    ("TP1", "Connector_Generic:Conn_01x01", "RP_SWCLK", "TestPoint:TestPoint_Pad_D1.0mm", "", "", {"1": "RP_SWCLK"}, [], "RP2040 SWD (recovery)"),
    ("TP2", "Connector_Generic:Conn_01x01", "RP_SWDIO", "TestPoint:TestPoint_Pad_D1.0mm", "", "", {"1": "RP_SWDIO"}, [], "RP2040 SWD (recovery)"),
    ("TP3", "Connector_Generic:Conn_01x01", "RUN", "TestPoint:TestPoint_Pad_D1.0mm", "", "", {"1": "RUN"}, [], "RP2040 reset"),
    ("TP4", "Connector_Generic:Conn_01x01", "GND", "TestPoint:TestPoint_Pad_D1.0mm", "", "", {"1": "GND"}, [], "ground"),
]
FLAGS = ["VBUS", "VBUS_F", "GND"]
