DevonHope/FOSS-Health-Alarm/(commit log)

2026-10-28 Add hardware roadmap with slim parts shortlist and PCB options
    Claude-Session: https://claude.ai/code/session_01Q9Z9S7Xccz3dq3tqx84KXT
2026-10-28 Route SWD and UART through the dock pads so the band needs no USB
    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
2026-10-28 Add verified stage 0 parts list with order links
    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
2026-10-28 Add Digi-Key BOM upload CSV for stage 0
    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
    [stage-0-digikey.csv]
2026-10-28 Drop battery from Digi-Key CSV for Canadian orders
    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
    [stage-0-digikey.csv]
2026-10-30 Add flex PCB schematic plan with BMS and Stage 0b battery test
    Plan for a 2-layer flex board that folds around the battery, with a
    stiffened LRA tape-down pad, nPM1304 charger/BMS, and a step-by-step
    KiCad schematic build plan. Roadmap now points Stage 1 at the flex board
    and adds a Stage 0b battery and BMS bench test.
    Claude-Session: https://claude.ai/code/session_01Q9Z9S4cetxefbuzxgfQdaw
2026-10-30 Set pod to about 22 x 36 mm with a 12 x 30 mm 110 mAh cell
    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
2026-10-30 Start KiCad project for flex rev A with ISP2454 symbol and GPIO plan
    Seven-sheet project (top, power, mcu, sensors, haptics, dock, debug).
    The MCU sheet places the ISP2454-LX with every signal pin wired to a
    global label or marked no-connect. GPIO choices follow Zephyr's
    nRF54L15 DK and XIAO nRF54L15 pin mappings. The footprint waits on the
    datasheet pad drawing.
    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
    [debug.kicad_sch, dock.kicad_sch, flex-rev-a.kicad_sch, haptics.kicad_sch, mcu.kicad_sch, power.kicad_sch, sensors.kicad_sch]
2026-10-30 Fix ISP2454 datasheet link (the _R7 file name does not exist)
    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
    [mcu.kicad_sch]
2026-10-30 Add ISP2454 footprint and move all signals to outer-row pads
    Footprint built from datasheet section 4.1 (R7), with an antenna
    keep-out rule area per section 4.3. GPIO plan changed so every signal
    uses an outer-row pad and the flex needs no via-in-pad.
    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
    [debug.kicad_sch, dock.kicad_sch, flex-rev-a.kicad_sch, haptics.kicad_sch, mcu.kicad_sch, power.kicad_sch, sensors.kicad_sch]
2026-10-30 Draw nPM1304 power sheet and move the project to KiCad 10 format
    Power sheet (step 3 of the flex plan), from Nordic's nPM1304 datasheet
    reference circuit "configuration 2" (QFN32):
    - VBUS from dock VIN with a TVS and 1 uF; CC1/CC2 to GND (no USB-C).
    - VBAT to the cell pads through a cut-able current-measure jumper (JP201).
    - BUCK1 at 1.8 V (VSET1 47k, confirmed in the datasheet table) on VDD_1V8,
    2.2 uH + 10 uF; VDDIO from VOUT1; PVSS1 to GND through a net tie.
    - BUCK2 unused: VOUT2 to VSYS, VSET2 and PVSS2 to GND, SW2 open, no inductor.
    Load switches unused (pins to GND), LED pins open.
    - 10k B3380 NTC, SHPHLD test pad + DNP pull-up and button footprint,
    PMIC_INT on GPIO3, 4.7k I2C pu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
    [debug.kicad_sch, dock.kicad_sch, flex-rev-a.kicad_sch, haptics.kicad_sch, mcu.kicad_sch, power.kicad_sch, sensors.kicad_sch]
2026-10-30 Power sheet: record SHPHLD decision, add LCSC numbers, make VBAT global
    - SHPHLD relies on the nPM1304's internal 50k pull-up; R201 and SW201 stay
    DNP (noted on the sheet).
    - LCSC part numbers on the passives, NTC, inductor, TVS and button; pads,
    jumper and net tie excluded from the BOM.
    - VBAT is now a global label so the debug sheet can give it a test pad.
    - 10 uF caps changed to a 25 V part (CL10A106MA8NRNC) that LCSC stocks.
    [power.kicad_sch]
2026-10-30 Draw sensors sheet: LIS2DW12 accelerometer on the 1.8 V I2C bus
    From ST datasheet DocID029682 Rev 4, table 2:
    - VDD (9) and VDD_IO (10) on VDD_1V8, 100 nF on each.
    - CS (2) and SDO/SA0 (3) tied to VDD_1V8: I2C mode, address 0x19.
    - SDA/SCL on I2C_SDA/I2C_SCL (pull-ups stay on the power sheet).
    - INT1 -> ACC_INT1, INT2 -> ACC_INT2 with test pad TP401.
    - NC (5) and RES (7) to GND as the datasheet allows/requires.
    - New LIS2DW12 project symbol; KiCad LGA-12 2x2 footprint (check vs ST).
    - Project footprints added: 0.8 mm test pad, LRA lead pad, 6-pad dock
    strip; library saved in KiCad 10 format.
    ERC: 2 errors, 9 warnings, none on the power or sensors sheets.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
    [sensors.kicad_sch]
2026-10-30 Draw haptics sheet: DRV2605L driving the coin LRA
    From TI datasheet SLOS854D (DGS pin table):
    - VDD (10) and VDD/NC (6) from VSYS with 1 uF; REG (1) with 1 uF.
    - EN <- HAPT_EN, IN/TRIG <- HAPT_TRIG, SDA/SCL on the shared 1.8 V bus
    (VIH 1.3 V, address 0x5A).
    - OUT+/OUT- to LRA lead pads TP501/TP502 (1.0 x 1.5 mm).
    - Notes: the 9 mm LRA tape-down pad is a layout feature on an FR4
    stiffener; VDD must stay on (I2C pins limited to VDD + 0.3 V) and the
    motor is blocked while VBUS is present.
    ERC: 2 errors, 7 warnings, none on the power, sensors or haptics sheets.
    [haptics.kicad_sch]
2026-10-30 Draw dock sheet: six pogo pads with TVS and series resistors
    - J601: six pads at 2 mm pitch, 1.2 x 3.0 mm (project footprint), order
    VIN, GND, SWDCLK, SWDIO, UART_RX, UART_TX.
    - TPD1E10B06 TVS at the VIN pad and each data pad (D601-D605); none on
    the GND pad.
    - 100 ohm in series between each data pad and the SoC net; 100k
    pull-down on UART_RX at the SoC side.
    - VIN TVS and its PWR_FLAG move from the power sheet to the pad (the pads
    and the PMIC sit on different flex islands).
    - (check) TPD1E10B06 leakage is 100 nA max at 5 V, above the 50 nA target;
    no 1.8 V figure for the data pads.
    ERC: 1 error (nRESET, debug sheet next), 3 warnings; SWDCLK error cleared.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
    [dock.kicad_sch, power.kicad_sch]
2026-10-30 Draw debug sheet: test pads and DNP debug LED
    - 0.8 mm round test pads (project footprint, no paste) on nRESET,
    I2C_SDA, I2C_SCL, VDD_1V8, VSYS, VBAT and GND. SHPHLD and ACC_INT2
    already have pads on the power and sensors sheets.
    - LED_DBG -> 1k -> 0402 red LED -> GND, both DNP.
    - nRESET has only a test pad (internal pull-up in the nRF54L15). The
    passive pad satisfies KiCad's "input not driven" check, so the nRESET
    error clears without an exclusion; noted on the sheet.
    ERC: 0 errors, 1 warning (ISP2454 hidden VSS pins vs GND label).
    [debug.kicad_sch]
2026-10-30 Finish rev A schematic pass: clean ERC, BOM with LCSC numbers
    - ERC 0 errors, 0 warnings: the ISP2454 symbol's ground pins renamed from
    VSS to GND (same pins), so they no longer clash with the GND label.
    - Sensors: larger LIS2DW12 symbol so pin names and GND symbols no longer
    overlap. Dock: connector mirrored and TVS spacing widened for
    readability. No connectivity changes.
    - bom.csv: JLCPCB-style columns with LCSC numbers checked on lcsc.com;
    ISP2454-LX and nPM1304-QEAA have none. Pads, jumper and net tie excluded.
    - All 50 references annotated and unique; PDF replotted; README status
    table, ERC notes and plan progress updated.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
    [bom.csv, dock.kicad_sch, flex-rev-a.kicad_sch, mcu.kicad_sch, sensors.kicad_sch]
2026-10-30 Record schematic review fixes and power budget in the plan
    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
2026-10-30 Apply schematic review fixes: 2.0 V rail, pad 10 NC, VIN TVS, bulk cap
    - Power: R202 47k -> 68k so BUCK1 starts at 2.0 V; global net VDD_1V8
    renamed VDD_2V0 on every sheet, notes updated.
    - Haptics: DRV2605L IN/TRIG tied to GND, HAPT_TRIG removed (effects run
    over I2C). Footprint kept as Package_SO:TSSOP-10_3x3mm_P0.5mm: it is
    KiCad's TI DGS land pattern (cites MPDS035); KiCad 10 has no footprint
    named VSSOP-10_3x3mm_P0.5mm.
    - MCU: pad 10 (P1.10) no-connect; GND global label replaced by the GND
    power symbol; note on the trapped lower-row GND pads 12/14/16/18 and on
    pads 8/24.
    - Sensors: C403 10 uF on LIS2DW12 VDD per ST; related (check) removed.
    - Dock: VIN TVS is now Littelfuse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
    [bom.csv, debug.kicad_sch, dock.kicad_sch, haptics.kicad_sch, mcu.kicad_sch, power.kicad_sch, sensors.kicad_sch]
2026-10-30 Start rev A layout hand-off: outline, layers, keep-outs, placement
    Step 8 of the flex plan, first pass, no routing:
    - flex-rev-a.kicad_pcb created from the schematic (51 footprints, all pad
    nets checked against the kicad-cli netlist).
    - Unfolded outline with 1 mm fillets: island A 32 x 18, 5 mm neck,
    island B 32 x 20; fold line x = 136.
    - User layers named Stiffener.Top/Bottom, Bend.Zone, Antenna.Keepout;
    bottom stiffener map, bend zone and antenna drawings, cell/LRA outlines.
    - Rule areas: BEND_ZONE (no vias/pads/parts) and ANTENNA_SHADOW_B (module
    keep-out mirrored onto island B).
    - Flex design rules: 0.12 mm board, 0.1/0.1 mm, 0.3/0.55 mm vias.
    - Placement by island; DRC has no sh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
    [flex-rev-a.kicad_pcb]
2026-10-30 Correct DRV2605L footprint note in the review table
    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
2026-10-30 Set pod to about 22 x 40 mm so the cell clears the antenna area
    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
2026-10-30 Lengthen both flex islands by 4 mm for a 22 x 40 mm pod
    The antenna shadow on island B mirrors island A's far end across the fold,
    so island A grows with island B: A is now x 96-132 (36 x 18 mm) with the
    ISP2454 moved to its new far end, B is x 140-176 (36 x 20 mm). The shadow
    rule area moves to x 171-176 and the 30 mm cell bay (x 140.5-170.5) ends
    0.5 mm before it. Stiffener map, keep-out drawings, fab notes, layout PDF
    and README pod size updated. Placement otherwise unchanged; DRC still has
    no shorts, clearance, courtyard or keep-out errors (unrouted nets and
    silkscreen only).
    [flex-rev-a.kicad_pcb]
2026-10-30 Route flex rev A (partial): DRC 0 errors, 3 nets open
    - Freerouting 1.9.0 route of all nets, GND included; GND pours on island A
    (both layers), island B (top) and hatched top in the neck; ISP2454 pads
    8/24 tied to 7/25; teardrops enabled on all pads and vias.
    - R601-R604 moved to island A next to the neck; neck widened 5 -> 7 mm.
    - Net classes (power 0.3, motor 0.25, VDD_2V0 0.2, GND 0.2, signals
    0.12 mm, clearance 0.13), no-via areas off the stiffeners, edge bands.
    - DRC exclusions for the 6 ISP2454 GND pads left unconnected on purpose.
    - Open: PAD_SWDIO (R602), VBUSOUT (C206), NTC (U201-TH201). Warnings are
    silkscreen only. Pad nets match the schematic; ERC still 0/0.
    Co-Authored-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
    [flex-rev-a.kicad_pcb]
2026-10-30 Complete flex rev A routing: DRC 0 errors, 0 warnings, 0 unconnected
    - Placement for routing: U501 group to the lower right of island A, U401
    group next to the module, PMIC caps regrouped so U201's power pins have a
    clear path to the neck (R601-R604 already on island A, neck 7 mm).
    - Freerouting 1.9.0 for the bulk; scripted grid router for the last VSYS
    link (0.15 mm at the QFN pin) and two GND links joining module pads
    25 and 31 to the main ground.
    - Neck: no vias, straight traces perpendicular to the fold, top and bottom
    traces staggered (45-degree jogs at the neck ends), hatched top GND.
    - GND: solid top pours on both islands, hatched in the neck; no bottom
    pour (it only left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
    [flex-rev-a.kicad_pcb]
2026-10-30 Fix fold orientation: cell and LRA pads to island B's B side; fab package
    Island B folds under island A, so its B side is the inner face where the
    cell and LRA sit.
    - TP201/TP202 (cell tabs, neck end) and TP501/TP502 (LRA leads, just
    outside the LRA stiffener) moved to B.Cu/B.Mask, clear of stiffeners.
    - BATT_P, LRA+, LRA- and the TP202 GND link rerouted to them; the LRA pair
    moved up on F.Cu in the neck so no trace sits over another at the fold.
    - All SMT parts stay on F (single-sided assembly); NTC stays on F.
    - Fold/assembly orientation note added to the fab notes layer and README.
    - fab/: Gerbers (copper, mask, paste, silk, edge, bottom stiffener, bend
    zone, antenna keep-out, notes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
    [bom_jlcpcb.csv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]
2026-10-30 Rework flex layout per layout review: 23.5 x 40 pod, straight neck lanes
    - Islands widened to 21.5 mm (pod about 23.5 x 40 mm); island B across the
    width: 0.3 edge, 12 mm cell bay, 0.5 gap, 8 mm LRA strip, 0.7 edge, so the
    LRA no longer overlaps the cell.
    - Neck widened to 9 mm; every trace in it is one straight locked lane along
    x (7 on F.Cu, 4 on B.Cu), no vias, >= 0.5 mm in y between F and B lanes.
    - Cell tabs TP201/TP202 and LRA leads TP501/TP502 on island B's B side,
    outside the cell bay, 0.5 mm clearance to other nets, mask +0.1 mm;
    battery +/- run 0.4 mm straight to their lanes (no vias on island B), 4
    battery-path vias on island A each doubled.
    - One merged FR4 0.4 stiffe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
    [flex-rev-a.kicad_pcb]
2026-10-30 Re-export flex fab package for the reworked layout; README updates
    - Gerbers without User.1, so the job file has no Stiffener_Top; the job
    file now carries the polyimide / 18 um copper / ENIG stackup.
    - Drill, JLCPCB CPL (31 fitted parts) and BOM re-generated; zip rebuilt.
    - fab/README.md: stackup, coverlay openings (0 expansion on fine-pitch
    parts, JLCPCB to confirm) and placement rotation checks for U201, U501,
    U401, D601 and the consigned U1.
    - README: 23.5 x 40 mm pod, layout review rework section with the
    remaining compromises; layout PDF replotted (adds B.Fab).
    [cpl_jlcpcb_top.csv, flex-rev-a-Antenna_Keepout.gbr, flex-rev-a-B_Cu.gbl, flex-rev-a-B_Mask.gbs, flex-rev-a-B_Paste.gbp, flex-rev-a-B_Silkscreen.gbo, flex-rev-a-Bend_Zone.gbr, flex-rev-a-Edge_Cuts.gm1]
2026-11-02 Rigid rev A: copy flex project, 60 mAh cell, 4-layer stackup and placement
    Schematic: cell text, title blocks and sheet notes updated for the rigid
    board and the 60 mAh cell; J601 uses a new round-pad dock footprint.
    ERC 0/0. Board: 15 x 33 mm outline, 4-layer JLCPCB stackup, parts placed,
    cell/LRA/antenna envelopes on Dwgs.User. Not routed yet.
    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
    [bom.csv, debug.kicad_sch, dock.kicad_sch, haptics.kicad_sch, mcu.kicad_sch, power.kicad_sch, rigid-rev-a.kicad_pcb, rigid-rev-a.kicad_sch]
2026-11-02 Rigid rev A: power routing and module via-in-pad
    POFV vias in the ISP2454 GND pads (8, 12, 14, 16, 18, 21, 23, 24 at
    0.2/0.3 mm; 1, 7, 25, 31 at 0.3/0.45 mm) and in nRESET pad 13, which
    runs on In2 to TP701. ANT_LINK pads 20-22 joined on F.Cu. 3x3 GND vias
    in the nPM1304 exposed pad, PMIC GND pins tied to it. VSYS, VBAT,
    BATT_P, VIN, VBUSOUT, SW1, PVSS1, VDD_2V0 (PMIC side) and LRA routed.
    L2 GND plane defined (not filled yet). J601 turned so pad 1 (VIN)
    sits next to D601. DRC: no clearance errors; signals still unrouted.
    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
    [rigid-rev-a.kicad_pcb]
2026-11-03 Rigid rev A: board nets and fields match the schematic
    Local nets renamed to their sheet paths (/power/PVSS1, /dock/PAD_RX,
    ...), NC pads given their unconnected-* nets, LCSC/MPN fields copied
    from the symbols and DNP set on R201, SW201, D701, R701. Netclass
    patterns follow the new names. DRC schematic parity: 0 issues.
    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
    [rigid-rev-a.kicad_pcb]
2026-11-03 Rigid rev A: signal routing, GND pours and stitching, DRC clean
    Signals routed with a scripted grid router (Freerouting 2.2.4 crashed
    loading the board). 0.12 mm tracks, 0.10 mm clearance on all netclasses,
    0.2 mm hole and inner-layer via clearance, 0.5 mm around the hand-solder
    pads, nothing in the antenna keep-out, no routing on In1.
    - C203 moved 0.65 mm left (it blocked PMIC SDA/SCL/SHPHLD); C401 turned
    90 deg next to the U401 GND pads; VIN In2 jog moved to x=121.6.
    - Removed duplicate VSYS/PVSS1/VIN segments that overlapped.
    - GND pours on F, In2 (spare area) and B; In1 solid. GND fan-out vias,
    18 edge and 2 module stitching vias; two 0.3/0.2 vias under U501.
    - Custom rules file now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
    [rigid-rev-a.kicad_pcb]
2026-11-03 Rigid rev A: JLCPCB fab package, PDFs and board README
    fab/: Gerbers (kicad-cli 10.0.5, --check-zones) for F/In1/In2/B copper,
    mask, paste, silk and outline; PTH/NPTH drills with maps; job file with
    the JLC04081H-7628 0.8 mm ENIG stackup; bom_jlcpcb.csv and
    cpl_jlcpcb_top.csv (31 parts, DNP excluded); rigid-rev-a-fab.zip; U1
    pin-1 drawing; README with order options (POFV required), rotation checks
    for U201/U401/U501/D601/U1 and the consigned parts.
    Board: title block set; NT201 GND link widened to 0.2 mm. Layout and
    schematic PDFs plotted. README covers stackup, orientation, envelopes,
    placement, routing, vias, inner pads and POFV, DRC/ERC, the nPM1304
    charger settings firmware must make, a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
    [bom_jlcpcb.csv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]
2026-11-03 Docs: rev A is now the rigid board with a 60 mAh cell
    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
2026-11-03 Rigid rev A: shorter GND returns and second power vias
    D605 and NT201 GND pads now each have their own via: D605 through 0.6 mm
    of 0.3 mm track, NT201 (PVSS1 star point) through 1.5 mm of 0.3 mm track,
    kept clear of the net-tie bridge. The old 4-5 mm thin links are gone;
    SWDCLK, PAD_RX, VDD_2V0, HAPT_EN, I2C, UART_TX, PMIC_INT and ACC_INT2 were
    rerouted around the new stubs.
    Second 0.45/0.3 vias, joined on both layers, at 8 of 11 single-via power
    layer changes (VBAT x2, BATT_P, VIN x2, PVSS1 x2, LRA_P). No room at BATT_P
    (121.7, 102.7), VIN at the dock (122.65, 113.2) and LRA_P at U501.
    Fab package, layout PDF and READMEs regenerated. DRC 0 violations /
    0 unconnected / parity 0. 143 vias.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
    [rigid-rev-a-B_Cu.gbl, rigid-rev-a-B_Mask.gbs, rigid-rev-a-B_Paste.gbp, rigid-rev-a-B_Silkscreen.gbo, rigid-rev-a-Edge_Cuts.gm1, rigid-rev-a-F_Cu.gtl, rigid-rev-a-F_Mask.gts, rigid-rev-a-F_Paste.gtp]
2026-11-03 Rigid rev A: DPY footprint for the data TVS, SMF12A on VIN
    - D602-D605 (TPD1E10B06DPYR) now use Package_SON:Texas_DPY0002A_0.6x1mm_P0.65mm
    instead of a generic 0402, in the schematic and on the board. Swapped in
    place; each GND pad keeps its own via about 0.8 mm away. The D605 silk
    exclusion is gone with the old footprint.
    - D601 is now Littelfuse SMF12A (LCSC C207255, same SOD-123FL footprint):
    12 V standoff, 13.3-14.7 V breakdown, 19.9 V clamp at 10.1 A, which is
    below the nPM1304 VBUS abs max of 22 V. SMF18A clamped at 29.2 V.
    - "(check)" removed from the TPD1E10B06 and L201 values (Murata
    DFE201610E-2R2M confirmed). Sheet notes and bom.csv updated.
    DRC 0 violations / 0 uncon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
    [bom.csv, dock.kicad_sch, power.kicad_sch, rigid-rev-a.kicad_pcb]
2026-11-03 Rigid rev A: tight buck loop at nPM1304 pins 1-4
    Re-placed the BUCK1 parts left of U201 (netlist unchanged):
    - C204 (input cap) sits right at pin 2 (PVSS1) and pin 4 (VSYS/PVDD),
    0.7 mm from the pins; SW1 runs under it between its pads to L201.
    C204.2 -> pin 2 is 1.6 mm pad centre to centre (was 5.4 mm), C204.1 ->
    pin 4 1.6 mm with no vias (was 3.3 mm and 2 vias).
    - C207 (output cap) sits above L201: C207.1 -> L201.2 1.1 mm (was 2.9),
    C207.2 -> pin 2 4.0 mm with no vias, through C204.2 (was 7.3 mm, 2 vias).
    - NT201 sits on the PVSS1 link next to pin 2 with its own GND via to In1;
    NT201.1 -> pin 2 3.2 mm (was 9.6 mm).
    - SW1 is 2.9 mm pad centre to centre (was 1.1 mm), 2.2 mm of copp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
    [rigid-rev-a.kicad_pcb]
2026-11-03 Rigid rev A: local caps at pins 19-22, TP201/TP202 off the cell
    D - VSYS pin 20 now has its own cap:
    - C206, C201, C205, C202 stacked right of U201 beside pins 22, 21, 20, 19
    (VBUSOUT, VIN, VSYS, VBAT), GND pads tied by an F.Cu spine with three
    vias to In1. Track from pin to cap: C205 1.5 mm (was 13.0), C201 1.8,
    C202 1.7, C206 3.0.
    - VSYS pin 4 to pin 20 is now 12.5 mm with 2 vias (was 23.9 mm, 4 vias):
    two 0.2 mm In2 tracks under the EP, between the via rows, into a via in
    C205.1's pad. Pin 32 joins through its own via; VSYS to U501/C501 runs
    on F along the top edge of the PMIC area.
    - VIN: via in C201.1's pad, In2 down the stack to the dock; VBAT: F from
    pin 19/C202 to R201/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
    [rigid-rev-a.kicad_pcb]
2026-11-03 Rigid rev A: no router vias in fine-pitch pads
    The grid router had dropped vias inside U501 pins 2 and 3, U201 pins 13
    and 18, TH201.1, TP703 and TP704. Vias are now kept out of every pad and
    I2C_SDA, I2C_SCL, NTC and the TP704 link are re-routed. The only via-in-pad
    added in this rework is in C201.1 (VIN) and C205.1 (VSYS), filled by POFV.
    DRC 0 violations / 0 unconnected / parity 0.
    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
    [rigid-rev-a.kicad_pcb]
2026-11-03 Rigid rev A: stitching vias, notes, regenerated fab package
    - Six GND stitching vias put back after the rework (three around TP202,
    BAT-), 135 vias in total. Title block dated 2026-11-03.
    - README: pod height counting both walls (about 8-9 mm); B.Cu carries
    signal tracks, so the case must cover it except the six pad windows, or
    it gets conformal coat (new compromise); buck-loop before/after table;
    SMF12A and DPY TVS details; L201 land pattern not yet compared with
    Murata's drawing; SW201 (DNP) not to be fitted; KiCad 10.0.3.
    - fab/README: rails with tabs or mouse bites, not V-cut (copper 0.30 mm
    from the edge); new vias in pads (C201.1, C205.1, TP704) under POFV;
    D601 SMF12A an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
    [bom_jlcpcb.csv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]
2026-11-05 Rigid rev A: L201 land pattern confirmed against Murata sheet
    Murata's DFE201610E recommended pattern (0.9 mm gap, 2.0 mm span,
    1.6 mm tall) gives 0.55 x 1.6 mm pads at +/-0.725 mm, matching
    KiCad's L_Murata_DFE201610P exactly. The DFE201610P sheet shows the
    same drawing. No board change; notes updated.
    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
2026-11-06 Rigid rev A: clean up every trace (45-degree bends, no staircases, ends on pad and via centres)
    A trace audit of 2ebc6fb found 196 staircase steps left by the grid
    router, 33 segments off the 45-degree grid, 18 square corners, about
    200 track ends that stopped inside or only touched a pad or via
    without reaching its centre, duplicated VSYS and LRA_P tracks on In2,
    and 2 dead-end stubs.
    Every run between pads, vias and junctions was re-laid with straight
    and 45-degree segments only, with each end on its pad or via centre,
    checked against all other-net clearances (0.1 mm, 0.2 mm to vias on
    inner layers, 0.2 mm hole, 0.3 mm edge, 0.5 mm at the cell and LRA
    pads, antenna keep-out). Eight spots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
    [rigid-rev-a.kicad_pcb]
2026-11-06 Rigid rev A: refill zones and regenerate fab package after trace cleanup
    Zones refilled with KiCad 10.0.3 pcbnew. Tracks and vias unchanged
    (399 segments, 135 vias, identical blocks; pcbnew only reordered them).
    DRC with schematic parity: 0 violations, 0 unconnected, 0 parity issues
    (D701 lib_footprint_mismatch stays excluded). ERC: 0 errors, 0 warnings.
    Regenerated Gerbers (--check-zones --subtract-soldermask), drill files and
    maps, job file, layout PDF and the fab zip. Only the routed copper layers
    changed in content; BOM and CPL regenerate identical and are kept.
    Claude-Session: https://claude.ai/code/session_01Q9Z9S4cetxefbuzxgfQd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
    [rigid-rev-a-B_Cu.gbl, rigid-rev-a-B_Mask.gbs, rigid-rev-a-B_Paste.gbp, rigid-rev-a-B_Silkscreen.gbo, rigid-rev-a-Edge_Cuts.gm1, rigid-rev-a-F_Cu.gtl, rigid-rev-a-F_Mask.gts, rigid-rev-a-F_Paste.gtp]
2026-11-06 Rigid rev A README: trace audit results, DRC via-centring check, buck loop lengths
    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
2026-11-06 Rigid rev A: 3D models for U1 and D602-D605, cell and LRA models
    KiCad 10 has no model for the ISP2454 footprint or for
    Texas_DPY0002A_0.6x1mm_P0.65mm. Add parametric build123d models in
    wakeband.3dshapes (ISP2454 8x8x1 mm, DPY0002A 1.0x0.6x0.375 mm, 60 mAh
    401215-class cell with PCM, VG0832012 LRA) and point U1 and D602-D605 at
    them through ${KIPRJMOD}. make_placed.py places the cell and LRA in the
    board's STEP frame with leads routed to their pads. DRC unchanged.
    [rigid-rev-a.kicad_pcb]
2026-11-06 Rigid rev A 3D: route the LRA- lead at x 132.0 to leave the board edge free for the case
2026-11-06 Case rev A: 3D-printable two-part case for the rigid rev A board, one M2 screw
    Outer shell over B.Cu with six dock-pad windows and sealing rims, wrist
    cover with 16 mm strap loops, an LRA pedestal and a cell bay. A hook at
    the antenna end and one M2 x 6 countersunk screw into a heat-set insert
    at the LRA end hold it together. Prints without supports. Clash check
    against the board, cell and LRA: only the intended 0.1 mm rim press.
    [wakeband-case-rev-a-cover.step, wakeband-case-rev-a-cover.stl, wakeband-case-rev-a-shell.step, wakeband-case-rev-a-shell.stl]
2026-11-06 Case rev A: 0.1 mm hook play, tilt-in fit checked, column slot clearance
    Raise the hook pocket ramp so the seated hook has 0.1 mm play (was 0.5).
    Widen the column slot and move the screw and LRA end 0.2 mm out so the
    cover swings in from 25 deg without touching the shell or the board.
    [wakeband-case-rev-a-cover.step, wakeband-case-rev-a-cover.stl, wakeband-case-rev-a-shell.step, wakeband-case-rev-a-shell.stl]
2026-11-06 Rigid rev A: parts side out, dock pads to F top edge, lead pads to B
    The cell and LRA move to B (no parts on that side), so the board mounts
    parts-side out. Changes:
    - J601 dock pads: new footprint DockPads_1x06_P2.0mm_D1.4mm on F along
    the top edge (y 101.6), TX RX SWDIO SWDCLK GND VIN left to right.
    - TP201/JP201 (bottom right), TP202/TP501 (top right) and TP502 flipped
    to B, outside the cell and LRA outlines; JP201 stays cuttable with the
    cell fitted.
    - Dock lines, VIN and VBAT re-routed (grid router plus three hand fixes);
    unused vias and stubs removed.
    DRC with parity 0/0/0, ERC 0, trace audit clean (baseline exceptions only).
    Zones refilled; Gerbers, drill, layout PDF and fab z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
    [dock.kicad_sch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]
2026-11-07 Case rev A: parts-side-out board, ridge joint, no extra openings
    New stack as worn: shell over F.Cu (parts and dock pads), board, cell and
    LRA in the wrist cover under B.Cu. Openings: six dock windows (the dock
    land presses onto the board round them) and the countersunk screw hole
    only; strap slots are in loops outside the body. A stepped ridge runs all
    round the parting line (cover lip 0.95 x 0.7 mm in a 0.9 mm shell skirt,
    0.15 mm clearance). One M2 x 6 countersunk screw into a heat-set insert
    in a boss at the LRA end; two press-fit pins at the antenna end replace
    the tilt-in hook. Clash check: no overlaps; push-on path clear except
    the pins. Body 44.8 x 19.3 x 10.0 mm, 54.2 mm with the st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
    [wakeband-case-rev-a-cover.step, wakeband-case-rev-a-cover.stl, wakeband-case-rev-a-shell.step, wakeband-case-rev-a-shell.stl]
2026-11-07 Case rev A: dock contacts embedded flush in the case top, no open holes
    The six dock windows become Ø1.05 mm bores for gold Ø1.0 x 2.5 mm contact
    pins, soldered upright on the dock pads and sealed into the case top with
    epoxy or UV resin, flush with the outer face. Board unchanged. Contact
    model added (wakeband-case-rev-a-dock-contacts.step). Checks: pins clear
    their bores, no clashes with board, cell or LRA. README: pin sourcing
    (Mill-Max 3340 post cut to length or custom pin), solder jig, sealing,
    dock-side spring pins (Mill-Max 0965).
    [wakeband-case-rev-a-cover.step, wakeband-case-rev-a-dock-contacts.step, wakeband-case-rev-a-shell.step, wakeband-case-rev-a-shell.stl]
2026-11-07 Magnetic dock: band magnets in the case top, dock rev A concept
    Band: two Ø3 x 1 mm N52 discs sealed under a 0.2 mm skin at each end of
    the contact row (x 118.6 and 134.9, 13.6 mm clear of the antenna
    keep-out), opposite poles out for keying; inserted at a print pause. The
    six flush gold contacts stay as the targets, so the board is unchanged.
    Dock rev A: printed puck with a locating recess, six Mill-Max 0965 spring
    pins on a small dock board, matching reversed magnets, USB-C power slot
    and programming header slot; README with parts, polarity and assembly.
    Fit checks: no overlaps; dock clears the band.
    [wakeband-case-rev-a-cover.step, wakeband-case-rev-a-dock-contacts.step, wakeband-case-rev-a-magnets.step, wakeband-case-rev-a-shell.step, wakeband-case-rev-a-shell.stl, wakeband-dock-rev-a-base.step, wakeband-dock-rev-a-base.stl, wakeband-dock-rev-a-board.step]
2026-11-07 Rigid rev A: RGB charge LED with KTD2026 I2C driver, case LED skin
    - SW201 (DNP ship-mode button) and its SHPHLD stub removed; SHPHLD stays
    on TP203.
    - D702 TOGIALED TJ-S1615SW6TGLCCYRGB-A5 RGB LED (LCSC C273610, common
    anode on VSYS) at SW201's old place, driven by U202 KTD2026EWE-TR
    (I2C 0x30, VIN on VSYS, C208 1 uF). New footprints, symbol and 3D
    models in wakeband.pretty / wakeband.kicad_sym / wakeband.3dshapes.
    - Routed by hand and grid router; DRC with parity 0/0/0, ERC 0, trace
    audit unchanged from baseline. 465 segments, 142 vias.
    - Gerbers, drill, layout and schematic PDFs, fab zip, BOM and CPL
    regenerated. U202 has no LCSC listing: consign it.
    - Case: 0.4 mm skin over t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
    [bom.csv, bom_jlcpcb.csv, power.kicad_sch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]
2026-11-07 Rigid rev A: VSYS via for the charge LED on TP705's centre
    The router left the via 0.1 mm off TP705's centre, inside the pad. It now
    sits on the centre (via in pad, filled by POFV like TP701/TP704) with a
    45-degree In2 leg. DRC with parity 0/0/0, audit at baseline. Fab files
    regenerated; via-in-pad lists in both READMEs updated.
    [rigid-rev-a-B_Cu.gbl, rigid-rev-a-B_Mask.gbs, rigid-rev-a-B_Paste.gbp, rigid-rev-a-B_Silkscreen.gbo, rigid-rev-a-Edge_Cuts.gm1, rigid-rev-a-F_Cu.gtl, rigid-rev-a-F_Mask.gts, rigid-rev-a-F_Paste.gtp]
2026-11-07 Rigid rev A: 4 wrist-side dock contacts on B; contact carrier PCB
    - J601 is now four Ø1.6 mm ENIG landing pads on B.Cu in a column at
    x 131.5 beside the LRA: SWDCLK (101.1), SWDIO (103.3), GND (111.7),
    VIN (113.9). UART_RX/TX stay on F as bench test pads at the old place.
    New footprint DockLanding_4xB_D1.6mm_2xUART.
    - TP501/TP502 (LRA leads) moved to the top strip at x 127.0/125.5,
    TP202 shrunk to 1.5 mm at x 129.05; PAD_RX via moved.
    - SWD lines keep their old routes and step down to the new pads; VIN on
    In2 along the bottom edge; LRA leads re-routed; VSYS to the LED on F.
    DRC with parity 0/0/0, ERC 0, audit at baseline. Fab regenerated.
    - New hardware/contact-carrier-rev-a: 2.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
    [contact-carrier-rev-a-B_Cu.gbl, contact-carrier-rev-a-B_Mask.gbs, contact-carrier-rev-a-B_Silkscreen.gbo, contact-carrier-rev-a-Edge_Cuts.gm1, contact-carrier-rev-a-F_Cu.gtl, contact-carrier-rev-a-F_Mask.gts, contact-carrier-rev-a-F_Silkscreen.gto, contact-carrier-rev-a-NPTH-drl_map.gbr]
2026-11-07 Strap patterns: hook-and-loop (rev A) and elastic-edge buckle strap (rev B), S/M/L
    Claude-Session: https://claude.ai/code/session_01Q9Z9S4fjgr9b1uuWYTC7tP
2026-11-07 Dock rev A PCB: USB-C, RP2040 debugprobe SWD probe, 4 spring pins
    New KiCad project hardware/dock-rev-a/pcb (4-layer 1.6 mm, 40 x 26.5 mm):
    - USB-C (HRO TYPE-C-31-M-12), 5.1k CC pull-downs, USBLC6-2SC6 ESD,
    500 mA PTC, 10 uF.
    - RP2040 + W25Q16JV + 12 MHz crystal with the Raspberry Pi Debug Probe
    pin map (SWCLK GPIO12, SWDI GPIO13, SWDIO GPIO14, LEDs GPIO2/16), so the
    stock debugprobe.uf2 runs unchanged. BOOTSEL button, RP2040 SWD/RUN pads.
    - Band side of SWD at 1.8 V (no VTref on the 4 pins): 74LVC1T45 for
    SWCLK, TXS0101 for SWDIO, 22 R series to the pins; 1.8 V and 3.3 V
    XC6206 LDOs.
    - VIN to the band through an SY6280AAC current-limited switch (~0.45 A).
    - Four Mill-Max 0906-4 sp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
    [bom_jlcpcb.csv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]
2026-11-07 Wrist-side 4-pin dock: case cover contacts, dock puck, READMEs
    - Case: shell top closed (only the 0.4 mm LED skin); wrist cover gets the
    contact carrier pocket, four cone windows (Ø2.0 -> Ø1.2) to the 0906-2
    pin tails, two keyed Ø3x1 magnets under a 0.2 mm skin (print pause),
    ledge notches, LRA pedestal cut back, F-side post over the bottom pair.
    Pins compressed 0.60 of 1.40 mm; size unchanged (44.8 x 19.3 x 10.0).
    Clash check 0 against board, cell, LRA; SolidCraft imports cleanly.
    - Dock: band sits wrist side down; two-part puck (top plate + tray) with
    0906-4 spring pins at mid-stroke, keyed magnets, strap channels, USB-C
    opening, LED and BOOTSEL holes; clash-free with the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
    [wakeband-case-rev-a-contact-carrier.step, wakeband-case-rev-a-cover.step, wakeband-case-rev-a-cover.stl, wakeband-case-rev-a-dock-contacts.step, wakeband-case-rev-a-magnets.step, wakeband-case-rev-a-shell.step, wakeband-case-rev-a-shell.stl, wakeband-case-rev-a-spring-pins.step]
2026-11-07 Dock and carrier fixes: USB-C flush, low-force dock pins, carrier panel
    - Dock: both parts notched 13 mm in front of USB-C so the receptacle face
    sits at the edge; plunger guide bores widened to Ø1.5 mm; rebuilt,
    clash-free with the dock PCB model and the band cover.
    - Dock PCB: spring pins specified as 0906-4 with the low-force spring 72;
    GND pin P3 gets a thermal relief for hand soldering. DRC/parity 0/0/0,
    ERC 0; fab regenerated.
    - Contact carrier: 6-up panel (48.2 x 29.1 mm, tab-joined) with its own
    fab zip, DRC 0/0.
    - Case README home build: seat the pins on a flat surface (not on the dock,
    whose pins would lift them), short soldering touches on PETG, gel epoxy
    bead so no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
    [contact-carrier-rev-a-panel-B_Cu.gbl, contact-carrier-rev-a-panel-B_Mask.gbs, contact-carrier-rev-a-panel-B_Silkscreen.gbo, contact-carrier-rev-a-panel-Edge_Cuts.gm1, contact-carrier-rev-a-panel-F_Cu.gtl, contact-carrier-rev-a-panel-F_Mask.gts, contact-carrier-rev-a-panel-F_Silkscreen.gto, contact-carrier-rev-a-panel-NPTH-drl_map.gbr]
2026-11-07 Contact carrier README: match the flat-bench soldering step
2026-11-07 Strap rev A pattern: 1 mm max thickness note (two layers at the bar folds)
    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
2026-11-07 Dock PCB: tidy routing to the band's trace-audit standard
    Hand re-laid the auto-router leftovers: 45-degree bends only, no
    stair-steps, every track end on its pad or via centre, no overlaps.
    Nudged C3, C6, C10, C19, R4, R10, R11, R13 so pad centres sit on 45-degree
    runs; moved the LED_ACT and +1V8 vias. DRC with parity 0/0/0 (via-centring
    check as error), ERC 0, audit clean. Fab package, CPL and layout PDF
    regenerated. Contact carrier board and panel re-checked: DRC 0/0, no
    tracks.
    [cpl_jlcpcb.csv, dock-pcb-rev-a-B_Cu.gbl, dock-pcb-rev-a-B_Mask.gbs, dock-pcb-rev-a-B_Paste.gbp, dock-pcb-rev-a-B_Silkscreen.gbo, dock-pcb-rev-a-Edge_Cuts.gm1, dock-pcb-rev-a-F_Cu.gtl, dock-pcb-rev-a-F_Mask.gts]
2026-11-07 Regenerate all fab packages from the current boards
    Fresh Gerbers, drill files, maps, job files and zips for rigid rev A, the
    dock PCB and the contact carrier (single and panel). The rigid rev A F.Cu
    Gerber had been exported before the last board edit. DRC 0/0 on every
    board; zips match the loose files; rigid CPL matches the board.
    [contact-carrier-rev-a-B_Cu.gbl, contact-carrier-rev-a-B_Mask.gbs, contact-carrier-rev-a-B_Silkscreen.gbo, contact-carrier-rev-a-Edge_Cuts.gm1, contact-carrier-rev-a-F_Cu.gtl, contact-carrier-rev-a-F_Mask.gts, contact-carrier-rev-a-F_Silkscreen.gto, contact-carrier-rev-a-NPTH-drl_map.gbr]
2026-11-07 Rigid rev B: JLC-stocked schematic and placement
    nRF54L10-QFAA (QFN48 reference circuit, Johanson chip antenna),
    BQ25125 charger with 1.8 V buck, IS31FL3193 LED driver. Same
    outline, dock landings, LED spot and lead pads as rev A.
    Generated from scripts/parts.py; ERC 0, placement fits.
    [rigid-rev-b.kicad_pcb, rigid-rev-b.kicad_sch]
2026-11-07 Rigid rev B: routed (all signal and supply nets), Nordic reference cluster, BQ fan-out
    Radio support parts placed as in Nordic's QFAA reference layout (rotated),
    re-routed to the house standard; BQ25125 via-in-pad fan-out; 1.8 V on an
    In2 plane; R210 dropped (internal pull-up on /PG). Case rev B shell script
    (antenna roof pocket, shorter dock land). Ground stitching still to do.
    [nordic_ref_qfaa_0_8.kicad_pcb, rigid-rev-b.kicad_pcb, rigid-rev-b.kicad_sch]
2026-11-07 Rigid rev B: 2.0 V LDO logic rail, IS31 VCC on PMID, all nets routed
    TPS7A0220 (2.0 V +/-1.5 %) replaces the BQ25125 1.8 V buck as the logic
    rail (nRF54L power-on reset needs 1.75 V); IS31FL3193 VCC on PMID so it
    can't clamp I2C; R209/R210 dropped for nRF internal pull-ups. Escape vias
    for the dock landings and U202. All signal/supply nets routed, DRC clean
    apart from ground stitching.
    [rigid-rev-b.kicad_pcb, rigid-rev-b.kicad_sch]
2026-11-08 Rigid rev B: UART pads removed, DRC/ERC/parity 0 at all severities
    Removed J601 UART pads 5/6, D604, D605, R603-R605, D701, R701 (logs via
    SEGGER RTT over the SWD dock pins). All nets routed; dangling vias and
    stubs removed; U203 silk trimmed off C211 (project-library footprint);
    RF-match sliver kept out of the top pour.
    [rigid-rev-b.kicad_pcb, rigid-rev-b.kicad_sch]
2026-11-08 Rigid rev B: trace audit pass (45-degree bends, ends on centres), DRC/ERC 0
    Re-laid the tangles the router left (I2C_SCL/SDA, LED_R, LS_CTRL hairpin,
    CHG_MR, VSYS/VLED 90-degree bends, duplicate PMID/VBAT/2.0 V runs) and
    centred track ends on pads and vias. One documented exception: a forced
    0.2 mm PMID jog between TP203 and TP707. README: status and routing notes.
    [rigid-rev-b.kicad_pcb]
2026-11-08 Rigid rev B: 2x2 JLCPCB assembly panel and fab files (Gerbers, BOM, CPL)
    Panel 70.1 x 71.1 mm (Standard PCBA minimum 70 x 70), boards on 3 mm
    mousebite tabs placed where the long edges are clear of copper, backbone
    between rows, rails with fiducials and tooling holes. Panel DRC 0 at all
    severities. BOM 40 lines / 55 placements per board with LCSC numbers.
    [bom.csv, rigid-rev-b-panel.kicad_pcb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]
2026-11-08 Case rev B: antenna x fixed, shell built, clash check 0 overlaps with the rev B board
    [wakeband-case-rev-b-shell.step, wakeband-case-rev-b-shell.stl]
2026-11-08 Rigid rev B: ground stitching check, 2 stitching vias, fab files rebuilt
    In1 one unbroken GND fill, no tracks; In2 islands all >= 2 GND vias;
    12 GND vias along the RF feed. Two stitching vias added where they clear
    every layer. DRC/parity 0 at all severities, panel DRC 0.
    [rigid-rev-b-panel.kicad_pcb, rigid-rev-b.kicad_pcb]
2026-11-08 Case rev B README: note the 0.4 mm LED window (inherited from rev A, checked)
2026-11-08 Contact carrier: buy list for spring pins, carrier panel and fitting parts
    Dock pins switch to the stocked 0906-4-15-20-75 (the -72 low-force version is factory special order).
    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
2026-11-08 Dock rev B: sleeker shell, strap saddles, LED skins, Ø4 x 1.5 mm magnets; dock pins to stocked 0906-4-...-75
    New hardware/dock-rev-b (rev A kept): 58.6 x 31.1 x 9.4 mm, 7 mm corners,
    rounded top edge, hidden lip joint, rounded strap channels with end saddles,
    LEDs through a 0.4 mm skin, rubber-foot recesses. Clash check 0 overlaps
    against the dock PCB model, pins, magnets and band cover; pins at mid-stroke.
    Dock PCB pin MPN -72 -> -75 (stocked); ERC 0, DRC/parity 0.
    [dock-pcb-rev-a.kicad_pcb, dock-pcb-rev-a.kicad_sch, wakeband-dock-rev-b-magnets.step, wakeband-dock-rev-b-spring-pins.step, wakeband-dock-rev-b-strap-standin.step, wakeband-dock-rev-b-top.step, wakeband-dock-rev-b-top.stl, wakeband-dock-rev-b-tray.step]
2026-11-08 Buy list: links, magnets from Indigo (Mouser has none at 3-4 mm)
    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
2026-11-08 Dock PCB BOM: merge D1 and D2 into one line (same LCSC part)
    JLCPCB warns when two BOM lines use the same part number.
    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
    [bom_jlcpcb.csv]
2026-11-08 Dock PCB to hardware/dock-pcb-rev-a with a USB-C 3D model; print checks and fixes for the printed parts
    - Dock PCB moved out of dock-rev-a/pcb into its own folder (git mv), own README, script paths relative.
    J1 (HRO TYPE-C-31-M-12, C165948) gets the LCSC/EasyEDA STEP on a project footprint, offset 1.6 mm so
    its face is on the board edge. ERC 0, DRC 0 at all severities, parity 0.
    - Dock rev B: pocket over the USB-C shell (the model showed it 0.56 mm into the plate); locating pins
    instead of a lip (no walls under 0.8 mm); 0.5 mm channel floor rounds (no feather edges at the joint);
    solid end blocks overlap the wall (closed a 0.01 mm slit); foot locating rings instead of 8 mm
    bridged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
    [bom_jlcpcb.csv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]
2026-11-08 Dock PCB CPL: JLCPCB rotation fixes for SOT-23, SOIC and QFN parts
    The positions were right, but KiCad and JLCPCB draw these packages turned
    relative to each other, so the placement preview showed them rotated.
    scripts/gen_cpl.py now writes the CPL from the board with the corrections.
    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
    [cpl_jlcpcb.csv]
2026-11-08 Hardware reorganised by type and revision: band/ and dock/, each rev with pcb/ and case/
    - band/rev-a/{pcb,case,contact-carrier}, band/rev-b/{pcb,case,contact-carrier}, band/archive/flex-rev-a,
    dock/rev-a/{pcb,case}, dock/rev-b/{pcb,case}; strap/ and tools/ unchanged. Moves are git mv.
    - dock/rev-b/pcb: dock PCB copy as dock-pcb-rev-b (title block rev B, same circuit, stocked 0906-4-...-75
    pins), own Gerbers/drill/PDFs and fab zip with the merged-LED BOM.
    - band/rev-b/contact-carrier: copy of the carrier project (identical board).
    - gen_cpl.py in both dock PCBs, plus a J1 offset: JLC's EasyEDA footprint for the HRO USB-C has its
    origin 1.42 mm behind KiCad's (shield legs/holes), so J1'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
    [bom.csv, bom_jlcpcb.csv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]
2026-11-08 Band rev B case folder carries the wrist cover too; README tool links fixed
    Every revision folder now holds its own pcb/ and every part to print in case/.
    [wakeband-case-rev-b-cover.step, wakeband-case-rev-b-cover.stl, wakeband-case-rev-b-shell.step]
2026-11-08 PCB review 2026-11-08: two independent advisors per board plus KiCad 10 DRC/ERC
    Covers band rev A, band rev B, contact carrier and dock PCB. Report only, no design changes.
    Claude-Session: https://claude.ai/code/session_01Q9Z9S3QWskxg3DZFHPUP8z
2026-11-08 PCB review: fix advisor verdicts on the fix-before-ordering list
    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
2026-11-08 Review fixes: dock case pin-barrel slots + rear PCB stops, rev B rotation checklist and RF note, rev A known issues, carrier hotplate soldering
    Applied the fixes the fix advisor backed (hardware/reviews/2026-11-08/fix-advisor.md):
    - dock rev B top plate: 1.9 x 0.6 mm slot over each spring-pin pair; tray: two rear PCB stops; STL/STEP regenerated
    - band rev B: placement-preview pin-1 checklist (pos.csv stays raw), README documents the kept In1 ground under the RF filter, transplant.py reports skipped zones
    - band rev A: 'Before ordering rev A' known-issues note
    - contact carrier: pins reflowed into the carrier before it goes into the cover; docking test with side offset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
    [wakeband-dock-rev-b-magnets.step, wakeband-dock-rev-b-spring-pins.step, wakeband-dock-rev-b-strap-standin.step, wakeband-dock-rev-b-top.step, wakeband-dock-rev-b-top.stl, wakeband-dock-rev-b-tray.step, wakeband-dock-rev-b-tray.stl]
2026-11-08 Dock PCB rev B: dog-bone the 26 vias that sat in SMD pads (review fix D-L1)
    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
    [dock-pcb-rev-b-B_Cu.gbl, dock-pcb-rev-b-B_Mask.gbs, dock-pcb-rev-b-B_Paste.gbp, dock-pcb-rev-b-B_Silkscreen.gbo, dock-pcb-rev-b-Edge_Cuts.gm1, dock-pcb-rev-b-F_Cu.gtl, dock-pcb-rev-b-F_Mask.gts, dock-pcb-rev-b-F_Paste.gtp]
2026-11-08 Review fix log; dock README segment count; dock PCB rev A marked superseded
    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
2026-11-08 Dock rev B case: band recess clearance 0.15 mm (review C-L2), top plate regenerated
    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
    [wakeband-dock-rev-b-top.step, wakeband-dock-rev-b-top.stl]
2026-11-08 Band rev A: review fixes (C203 spokes, U202 EP, off-board ref text, SWDCLK pad via)
    Review 2026-11-08 items for band rev A, applied by
    hardware/band/rev-a/pcb/scripts/review_fixes_2026_11_08.py (asserts the
    starting geometry, deterministic, fills zones with pcbnew ZONE_FILLER):
    - C203 pad 2 (GND): solid zone connection; its thermal relief could only
    get 1 spoke into GND_L1 (KiCad 10 starved_thermal).
    - U202 KTD2026: exposed pad 1.45 x 0.8 -> 1.2 x 0.65 mm (0.2 mm to the
    pins; KiCad's 0.7 would leave 0.175 with these pins), paste in two
    0.45 x 0.48 mm windows (55 %). Footprint renamed
    Kinetic_UTDFN-8_1.5x1.5mm_P0.4mm_EP1.2x0.65mm in wakeband.pretty, the
    symbol library, the schemati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
    [bom.csv, bom_jlcpcb.csv, power.kicad_sch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]
2026-11-08 Dock PCB rev B: review fixes (pin ESD/TVS, SWCLK pull-down, 0.21 A limit, no vias under paste, crystal, VBUS_F, silkscreen)
    - D-E1: USBLC6-2SC6 (U9) on the bare SWCLK/SWDIO pins, SMF6.0A (D3) on VIN, R11/R12 22 -> 100 R
    - D-E3: 100 k pull-down (R15, 0201) on the 74LVC1T45 input
    - D-E2: R6 15 k -> 33 k (band current limit 0.21 A)
    - U3 pin 5 VBUS via out of the pad; RP2040 EP paste split into 16 windows clear of the vias (D-L8)
    - D-L4: SWDIO_DRV off the crystal; D-L7: In2 VBUS_F 0.45 mm; D-L9: pin-1/cathode/pin labels/board name
    - schematic regenerated from parts.py (title block fixed in gen_sch.py), gen_bom.py added
    - DRC + parity 0/0/0/0, ERC 0, trace audit clean; fab, BOM, CPL, PDFs regener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
    [bom_jlcpcb.csv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]
2026-11-08 Band rev B: review fixes (In1 RF void + I2C_SDA reroute, B-L4..B-L7, text)
    - B-L1: In1-only rule area under the RF filter (Nordic's void clipped at x >= 103.5);
    In2 stays solid as the filter reference (In2 copy of the C9-island void removed).
    I2C_SDA (B.Cu) now passes above the filter (ACC_INT1 via moved up its diagonal to
    105.95,103.2); I2C_SCL drops to B.Cu at 101.3,104.6 and crosses under the feed at
    y 108.7. No In2/B.Cu signal inside x 102.5-106.9, y 103.8-106.6.
    - B-L4: courtyard POFV rules only match holes < 0.16 mm; VLED via moved to 122.55,106.05.
    - B-L5: C6 back at Nordic's y (105.707).
    - B-L6: U201 ball mask margin 0.03 mm (0.11 mm dams).
    - B-L7: 8 GND vias along the 0.36 m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
    [rigid-rev-b-panel.kicad_pcb, rigid-rev-b.kicad_pcb, rigid-rev-b.kicad_sch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]
2026-11-08 Dock PCB rev B: re-layout under the RP2040 (decoupling at the supply pins, flash turned, QSPI shortened)
    - C15 (VREG_VOUT 1 uF) at pin 45; new 100 nF at pin 43 (C22), pins 48/49 (C23, 0201) and pin 50 (C24, 0201)
    - U2 turned 180 degrees and moved right: QSPI 4-16 mm per line (was up to 27 mm)
    - R4/R5, C12, R8/R9/C17 moved; BOOT and LED_USB re-routed on In2
    - XOUT stays on In2: a top-layer route does not fit the 3225 crystal (see README)
    - DRC + parity 0/0/0/0 (with and without refill), ERC 0, trace audit clean; fab, BOM, CPL, PDFs regenerated
    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
    [bom_jlcpcb.csv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]
2026-11-08 Band rev B: ESD clamps next to the dock contacts (review B-L3)
    - Each J601 landing now goes through one via touching the landing and a short F.Cu
    run straight into its clamp pad; the rest of the net leaves from the clamp pad.
    Landing centre to clamp: SWDCLK 2.7 mm (was 22.1), SWDIO 2.0 mm (was 23.3),
    VIN 4.2 mm (was 14.1, mostly In2). Each clamp has a GND via beside its GND pad.
    - D602/D603 (TPD1E10B06) moved right of U501, below the case dock land;
    C502 moved 0.3 mm down and turned horizontal; PMID hops to B.Cu between the
    SWD landings instead of running down F.Cu at x 132.6.
    - D601 SMF12A (SOD-123F, C207255) -> ESD5681N07 (DFN1006, C240204, 7 V standoff,
    16 V clamp at 27 A) at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
    [bom.csv, rigid-rev-b-panel.kicad_pcb, rigid-rev-b.kicad_pcb, rigid-rev-b.kicad_sch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]
2026-11-08 Review: re-layout and verification results; band rev B case clash re-check
    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
2026-11-08 Dock PCB rev B: verification follow-ups (U2 pin-1 dot, J1 slot clearance, D2 via margin, docs)
    - N1: U2 pin-1 silk dot moved with U2
    - N2: In2 VBUS_F diagonal by J1's shield slot 0.45 -> 0.4 mm (0.33 mm to the hole)
    - N6: D2's LED_ACT via 0.08 mm right (0.28 mm hole to the cathode pad)
    - N8: README (rev B differs from rev A, no poke hole, XOUT 9.2 mm, audit wording), title-block comment,
    P4 description 0.21 A
    - DRC + parity 0/0/0/0 (with and without refill), ERC 0; fab, PDFs regenerated (BOM/CPL unchanged)
    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
    [dock-pcb-rev-b-B_Cu.gbl, dock-pcb-rev-b-B_Mask.gbs, dock-pcb-rev-b-B_Paste.gbp, dock-pcb-rev-b-B_Silkscreen.gbo, dock-pcb-rev-b-Edge_Cuts.gm1, dock-pcb-rev-b-F_Cu.gtl, dock-pcb-rev-b-F_Mask.gts, dock-pcb-rev-b-F_Paste.gtp]
2026-11-08 Band rev B: title block rev B (B-L10) and D601 GND via at the landing edge
    - Title block: "WakeBand rigid rev B", rev B, 2026-11-08, mounting described correctly (was rev A's,
    "parts-side down"); Gerber headers and job file now carry revision B
    - D601's GND via moved from under the J601.2 plunger to the landing edge (130.85, 111.7)
    - DRC + parity 0/0/0/0 (with and without refill), ERC 0, panel DRC 0; gerbers.zip and panel regenerated
    (bom.csv, pos.csv unchanged)
    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
    [rigid-rev-b-panel.kicad_pcb, rigid-rev-b.kicad_pcb]
2026-11-08 Rev C folders: today's review-fixed band and dock live in band/rev-c and dock/rev-c; rev B restored as reviewed
    - band/rev-c (pcb, case, contact-carrier) and dock/rev-c (pcb, case) = the 2026-11-08 review-fixed state,
    renamed rigid-rev-c.* / dock-pcb-rev-c.* / wakeband-case-rev-c-* / wakeband-dock-rev-c-*, title blocks and
    silkscreen rev C; fab packages, BOM/CPL, PDFs, panel and case models regenerated with the new names
    - band/rev-b and dock/rev-b restored to 25262a1 (as reviewed) plus a "Superseded by rev C" line in each README
    - hardware/README tree and order table point at rev C; review README notes where the fixed boards live
    - rev C: ERC 0, DRC + parity 0/0/0/0 (saved and refilled)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
    [bom.csv, bom_jlcpcb.csv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]
2026-11-08 Rev C placement files: per-part JLC corrections from JLC's own footprints (band and dock)
    - jlc_cpl_fix.py fetches each LCSC part's EasyEDA footprint, matches its pads to the KiCad pads by
    number and stores the rotation step / offset (jlc_cpl_fix.json); jlc_cpl_check.py lays JLC's pads at
    the written CPL values on the board pads
    - band rev C: U201, U202, U401, U501 +270 (they sat turned, 1.6-3.5 mm off, pin 1 wrong); worst residual
    0.28 mm (land size), pin 1 ok on all 40 parts; panelfab.py applies the table to all four panel copies
    - dock rev C: replaces the generic SOT-23/SOIC/QFN table, which was wrong for U1 (RP2040, 6 mm off),
    U3/U6/U9 and the LEDs D1/D2 (reversed); worst residua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
    [cpl_jlcpcb.csv, pos.csv]
2026-11-10 Add project README: NudgeBand overview, how it works, current status (PCBs ordered)
    Claude-Session: https://claude.ai/code/session_01Q9Z9S5QGY3qJJywj7TYHjX
2026-11-10 Firmware: to-do plan, board definition, smart-wake logic with host tests, driver and Bluetooth drafts
    - firmware/TODO.md: phased plan from tools and bring-up to real-night testing and releases
    - boards/nudgeband: Zephyr board for band rev C (nRF54L10, crystals, DC/DC, I2C, GPIOs)
    - smart-wake decision, movement measure, alarm times and BLE byte layouts in pure C,
    unit-tested on the host (make -C firmware/tests/host)
    - first drafts of LIS2DW12, DRV2605L, IS31FL3193, BQ25125 and the NudgeBand GATT service
    following docs/ble-protocol.md (shared with the app)
    - CI: host tests plus a Zephyr v4.2 build
    - README: firmware status and layout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
2026-11-10 Android: compare API 33 GATT write results to BluetoothStatusCodes.SUCCESS; print lint report in CI
    Claude-Session: https://claude.ai/code/session_01Q9Z9S4fBCu1DzduGzjHcYK
2026-11-10 Firmware CI: pin CMake 3.x (Zephyr v4.2 scripts break under CMake 4)
    Claude-Session: https://claude.ai/code/session_01Q9Z9S75bwW3mQox1jcvuFJ
2026-11-10 Add security checks for every PR and fix privacy issues found in an audit
    Security workflow (runs on every PR, on main and weekly):
    - gitleaks secret scan over the full history, redacted output
    - privacy check: home-folder paths, emails, confidential/NDA markings,
    datasheet PDFs, key files, .env, local.properties, large files;
    warns on commits with a personal email
    - zizmor audit of the workflows
    - dependency review on PRs, Android dependency submission on main
    CodeQL for C, Kotlin, Python and Actions; Dependabot for Actions and Gradle.
    Fixes:
    - pin every action to a commit SHA and stop persisting the checkout token
    - routing scripts find the board relative to themselves instead of a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
